raphaelcasimir/kord-stk/README.md

# kord-stk
The KORD-reborn project (of Holy Mother Russia) purpose is to control a rocket's attitude in flight.

1. First phase: the Stick of Truth (STK) 
1. Second phase: the Rocket Control System (RCS)

https://www.youtube.com/watch?v=VuEvJ63-ckM

Please keep in mind that  explosions, holes in things and casualties should be minimised.

May Russia be with you.
