raphaelcasimir/kord-stk/Report/chapters/glossary.tex

% Glossaries package
% http://ctan.cs.uu.nl/macros/latex/contrib/glossaries/glossariesbegin.pdf
%
% % % % % % % %
%	Example of glossary entry:
% \newglossaryentry{cabbage}{name={cabbage},description={vegetable with thick green or purple leaves}}
%
%	Example of acronym entry:
% \newacronym{spi}{SPI}{Serial Peripheral Interface}
%

\newacronym{e}{E}{example}
