raphaelcasimir/kord-stk/Report/chapters/Preanalysis&Requirement/RocketStability.tex

\subsection{Controlling a Rocket's Stability}
The design method for placing the CP and GP does not always provide a perfectly stable attitude control. Indeed to have such precision an active control system is necessary. Full scale rockets use the thrusting force to achieve alike control. In order to do so most of them operate with the gimbaled thrust method. It consists of steering the engine's nozzle to get the thrusting force in right incidence. An example is seen cf. figure \autoref{fig:RocketGimbal}. 
\begin{figure} [htbp]
	\centering
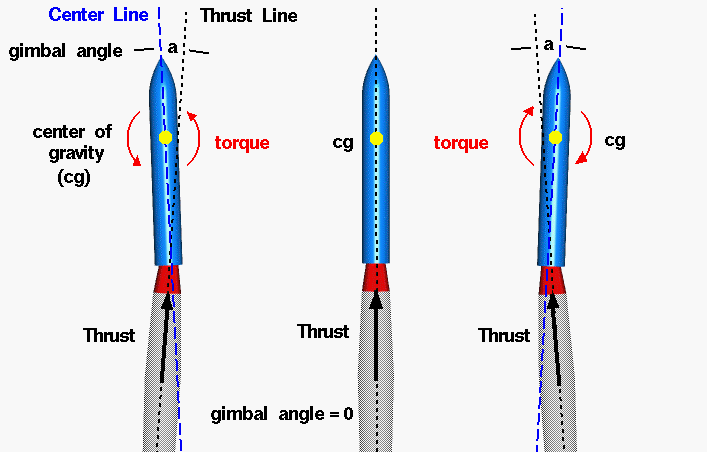
[picture p5: Report/figures/Preanalysis&Requirement/RocketStability/RocketGimbal.png]
	
	\caption{Example of gimballing a rocket nozzle \cite{web:rocketnasa}.}
	\label{fig:RocketGimbal}
\end{figure}
\newpage

Where a torque is applied to create a rotation around the rocket's center of gravity. The thrust direction is relative to the position of the center of gravity.  This should compensate for direction deviations from the rocket's center line or trajectory, and keep the rocket stable. The described gimbal method will be the control method focused on in this project. The rocket will be designed with a control system depending on vectoring the thruster in relation to the attitude position of the rocket.
