raphaelcasimir/kord-stk/Report/chapters/Implementation/implementation.tex

\chapter{Inverted Pendulum Implementation}\label{sec:InvPendImp}
This section describes the hardware and software implementation of the controllers designed \autoref{sec:IPController}. The goal is to determine if the designed controllers will balance the stick in the real world application. The section is separated into three different parts about sensors, hardware controller and software controller. The first part is to implement the feedback for the controllers which in the case is sensors. 

\section{Implementing Sensors}
The following section describes the implementation of the sensors with an Arduino Uno and the inverted pendulum setup.   

\subsection*{Potentiometer}\label{section:PotmeterImplementation}
The system consist of multiple sensors, as decribed in \autoref{sec:IPDesc}, where two of these are potentiometers. The potentiometers is tested in Appendix \ref{appendix:PotMeterTest}. The appendix concluded with a first order approximation of both potentiometers. During the implementation it is realized that slight calibrations were needed because the potentiometer had moved in the setup. The approximation for Pot$_{arm}$ is:
\begin{equation}
\theta_a\ =\ 63,11 \cdot V_{{Pot}_{arm}} - 117,0
\end{equation}
\startexplain
	\explain{$\text{V}_{{Pot}_{arm}}$ is the output voltage of the arms potentiometer}{V}
	\explain{$\theta_a$ is the angle of the arm}{$^\circ$}
\stopexplain

The approximation for Pot$_{stick}$ is:
\begin{equation}
\theta_s\ =\ 66,66 \cdot \text{VPot}_{stick} - 163,9
\end{equation}
\startexplain
	\explain{$\text{V}_{{Pot}_{stick}}$ is the output voltage of the stick potentiometer.}{V}
	\explain{$\theta_s$ is the angle of the stick, but where zero degrees is when the stick has a zero degree deviation from the arm}{$^\circ$}
\stopexplain

An example of implementing this is done through a pseudo-code which converts the analogue value to radians. The linear approximations of the potentiometers are used.
\begin{lstlisting}
void loop() {
  // read the input on A0 and A1:
  int PotArm = analogRead(A0);
  int PotStick = analogRead(A1);

  double VPotarm = PotArm / 204.8; //Analog2Voltage
  double ThetaA = 66.66 * VPotarm - 170.46; // Voltage2Degree
  double ThetaARad = ThetaA * (31.415926 / 1800.0); //Degree2Radians
  double VPotstick = PotStick / 204.8;
  double ThetaS = 63.64 * VPotstick - 117.77;
  double ThetaSRad = ThetaS * (31.415926 / 1800.0);
}
\end{lstlisting}    

The sampling time of the sensors is an important aspect when ensuring stability of the control system. The sensor sampling can not be to slow because then the control loops will be slow and not update fast enough. Considering that the sensor is a potentiometer which does not have any active components, then the only limit is the Arduino. Arduino specifies that calling an analogRead() takes approximately 100 $\upmu$s which corresponds to a sampling frequency of 10 kHz. This is considered fast enough for the system and is therefore not a problem. 

\subsection*{Tachometer}
The tachometer and its precision has been tested in Appendix \ref{appendix:RPMTest}. The test concluded that the internal tachometer's precision is within the limit of what can be implemented. The tachometer outputs a voltage which is close to linear with the number of revolutions per minute.

The test concluded with a transfer function for the tachometer, that gives the relation between the tachometer voltage and motor velocity:
\begin{equation}
\dfrac{\dfrac{1000\ \text{RPM}}{3.130\ \text{V}} \cdot 2 \cdot \pi}{60\ \text{s}}\ \cdot\ T_{Voltage}[\text{V}]\ =\ M_{Velocity}\ \text{[rad/s]}
\end{equation}

The function can not directly be implemented with the Arduino. The tachometer will generate a negative and a positive voltage corresponding to the direction of the motor. Negative voltage can not be directly input to the Arduino without short circuiting it, and the positive voltage would be too high considering that the motor can go up to 8500 RPM. Interfacing is therefore needed between tachometer and Arduino.
This interfacing is done through the ESCON motor controller included in the inverted pendulum setup. The two outputs of the tachometer are put into the motor controller via two analogue inputs. One acts as the positive connection and the other as the negative. How the motor controller is reacting to an input is configured through the ESCON studio included. In this case it is set with the conversion ratio from voltage to RPM on 3.130 V/1000 RPM, which was determined by external calibration from another tachometer and implemented in the software.  The motor controller is set with a output that converts this RPM down between 1 and 4 V to the Arduino. Where 1 V is corresponding to -3000 RPM and 4 V corresponding to +3000 RPM. This gives the possibility to convert these values back to RPM in Arduino. How the motor controller converts the voltages is considered a black box. The wiring for the tachometer can be seen on \autoref{fig:EsconWiring}. 

\begin{figure}[htbp]
\centering

\caption{Circuit diagram of the wiring for the control setup.}
\label{fig:EsconWiring}
\end{figure}
\newpage
\section{Implementing ESCON Motor Controller}
The following sections describes the implementation of the hardware motor controller with the Arduino. The motor controller in the setup is a Maxon Escon 50/5.

The Maxon ESCON 50/5 is a PWM servo controller, that can be used to control DC and EC motors. The application is to amplify signals and control systems through different control operations. It can also be used with a PWM input signal that can be outputted as an amplified and higher frequency PWM signal to a motor. The servo controller can be used in three different modes which can be configured through the included Maxon ESCON studio. It can be configured in two modes for speed control with open and closed loops with feedback from sensors through the board, and one mode for motor current control through inputs from other modules such as an Arduino. In the setup the Escon controller is set to current control.

It is set up through the ESCON studio with current control, and with an external controlled PWM signal. It then gives the possibility to input a PWM signal from the Arduino, which will be amplified so that 90\% duty cycle equals 11 A and 10\% equals -11 A. This means that 50\% will give 0 A.

The Arduino uses a 8-bit timer for PWM as standard. To get a better resolution the TimerOne library is implemented. TimerOne is a 16-bit hardware timer which can be downscaled to give the possibility to have a 10-bit resolution on the PWM signal. A better resolution gives a higher number of duty cycle values which makes the control more precise than with 8-bit. 

The configuration file for the ESCON studio is included in the attachment files under "/Attachment/Implementation/Motor Controller/Motor Controller Configuration File". It can be imported into the ESCON studio and loaded onto any 50/5 controller.

The main specifications of the ESCON is listed in \autoref{MaxonSpecifications}.

\begin{table}[htbp]
	\centering
\caption{Maxon Escon 50/5 specifications\citep{datasheet:maxon}.}
\label{MaxonSpecifications}
	\begin{tabular}{llll}
	\hline
	Parameter & Value & Unit \\ \hline
	Supply voltage V$_{cc}$& 10-50 V & {[}V{]} \\
	Output voltage (max.) & 0,98 $\cdot$ V$_{cc}$& {[}kg{]} \\
	Nominal output current & 5 & {[}A{]} \\
	Maximum output current (<20 s) & 15 & {[}A{]}\\
	Current control PWM frequency & 53,6 & {[}kHz{]}
	\end{tabular}
\end{table}

The wiring for the setup can also be seen on \autoref{fig:EsconWiring}.  

\newpage
The control PWM signal from the Arduino is set with a frequency of 5 kHz because that it is the maximum input frequency the motor controller will accept. It is set to 5 kHz so that the PWM avoids interference with the sampling frequency for the system.
The input PWM signal is then amplified and made faster. The output PWM frequency of the motor controller is 53.6 kHz with a duty cycle from 10 - 90\% which can not be changed in the ESCON studio. The switching frequency of the ESCON is considered close to optimal as the PWM frequencies are within the limit of the datasheet specifications. The main concern of a switching frequency of 53.6 kHz on the motor is heat dissipation. Therefore the minimum PWM frequency for the motor is calculated to see if the motor controllers PWM frequency fits the motor.

\subsection{Calculating Minimum PWM Frequency}
The only PWM frequency considered is the minimum switching frequency for the motor. This is done by considering the motor resistance and inductance versus the maximum amount of current ripple wanted on the motor. The values for the resistance and the inductance of the motor are calculated in Appendix \ref{tab_appendix:KeSetUp}. The formula is seen on \autoref{eq:PWMSwitch}.

\begin{equation}
f_{switch} \geq \frac{-1}{2\cdot \ln(1-\frac{p}{100})}\cdot\frac{R_{m}}{L_{m}}
\label{eq:PWMSwitch}
\end{equation}
\startexplain
	\explain{$p$ is the maximum \% current ripple in the motor.}{1}
	\explain{$\nicefrac{R_{m}}{L_{m}}$ is the inverse electrical time constant of the motor.}{Hz}
\stopexplain

Replacing with the numerical values of the resistance and the inductance and choosing a max ripple percentage of 5\%, the minimum switching frequency determined to be:
\begin{equation}
    f_{switch} \geq \frac{-1}{2 \cdot ln(1-\frac{5}{100})}\cdot\frac{0.82\ \Omega}{156\cdot10^-6 \ \cdot \text{H}} \approx \ 51.2 \text{ kHz}
\end{equation}

The maximum ripple in the motor is determined by making the ripple the unknown factor P$_{ripple}$ and setting the PWM frequency to the implemented 53.6 kHz.  

\begin{equation}
    53.6 \text{kHz} = \frac{-1}{2 \cdot ln(1-\frac{P_{ripple}}{100})}\cdot\frac{0.82\ \Omega}{156\cdot10^-6 \ \cdot \text{H}}\ =\ P_{ripple}\ = 4.785\%  
\end{equation}
This gives that the maximum current ripple is 4.785\% if considering a PWM frequency on 53.6 kHz. A general rule is that the ripple should be less than 10\% of the current, so considering that it is less than 5\% is acceptable.

%https://playground.arduino.cc/Code/Timer1
 
%\section{Implementing Controllers}
%The implementing on the hardware has been described in the chapter, and therefore the implementation can proceed to the implementing the controllers on an Arduino. 

\input{chapters/Implementation/ZTransform.tex}

\subsection{Controller Software}
This sections describes the software implemented on the Arduino.  The software can be found in the attached materials under "Attachment/Implementation/Arduino Software/InvertedPendulumControlSoftware". The structure and processes is represented with a flowchart on \autoref{fig:Flowchart}.   
\begin{figure}[htbp]
\centering

\caption{Flowchart for the implemented software on Arduino.}
\label{fig:Flowchart}
\end{figure}
\newpage

\section{Implementation Evaluation}
This following sections describes the different problems that occurred with the hardware and software through out the implementation. They will be explained to show the progress through out the implementation.

\subsection{Filtering Sensors}
During implementation of the arm loop, it was found that a shaking occurred through the motor, gear and out to the arm. From testing higher gains it was found that the shaking was amplified and became more unstable with the higher gains. Testing of the hardware and software was done to determine the source of the shaking. To start with, the sensors were checked for noise and floating. This was done to remove incorrect readings and unstable sensors. The sensors were read through an oscilloscope and it was found that the ESCON motor controllers PWM frequency was represented in the sensor signal. This can occur from incorrect ground or wires not correctly isolated. This problem was solved by adding a capacitor to the sensors as seen on \autoref{fig:EsconWiring}. The capacitor is connected from signal wires to ground to make a low pass filter. 1 $\upmu$F is chosen, one for each signal wire and considering that it is two 10 k$\Omega$ potentiometers it will give a varying cut of frequency. The cut-off frequency is calculated to be:       
\begin{subequations}
\begin{flalign}
\frac{1}{2\cdot \pi \cdot 10000\ \Omega \cdot 1 \cdot 10^{-6}\  \text{F}}\ =\ 15.92\ \text{Hz} \\
\frac{1}{2\cdot \pi \cdot 2.97\ \Omega \cdot 1 \cdot 10^{-6}\  \text{F}}\ =\ 53.6\ \text{kHz}
\end{flalign}
\end{subequations}

The resistance changes needs to go under $\approx$ 2.97 $\Omega$ before the cut-off frequency exceeds the frequency of the noise, and any resistance change higher will dampen with more than -3 dB. It is noticeable that the resistance values of the potentiometers are in between both limits of resistances and the noise is therefore dampened. The conclusion of adding these filters, is that the high frequency noise that made the arm shake is reduced. There was still a small-amplitude shaking around the setpoint when the arm was at a position and kept there. This could due to non-optimal range and bad optimization of bits in the software. The software is made with scaling from analogue values to radians, which means that reading the arm potentiometer and having an analogue value from 235 to 527 and converting it to -0,785 to 0,785 radians means that that first two bits are not used. This gives that the 10-bit resolution of the PWM is not used optimally when two are static, but it is still better than having 8-bit with two static. 

This can be optimized by changing the range of the potentiometers so the maximum angles the arm reaches correspond to the full 10-bit range. It could also be solved by changing the model and with the conversion throughout the software. The analogue value would thus not be converted which would give a better resolution for the PWM output. They can also be combined for the best resolution. It is chosen to only implement the resolution optimization if and only if the acceptance test show that the system does not fulfil the set requirements.

\subsection{PWM Frequency Problems}
The stick control loop was implemented with an interrupt attached to the TimerOne to get the desired sampling rate. The simulations gave gains and results that could be implemented on the system. When implemented it was found that the arm did not control correctly when the stick moved. Repetitive test gave the conclusions that the speed of the arm was to slow. Higher gains were implemented but did not give the wanted result and the gains were set back to the simulated. An oscilloscope test was made on the Arduino PWM frequency by measuring the input frequency on the motor controller. The test showed that the frequency was 100 Hz and not 5 kHz as expected. 

The software was revised and determined that attaching the interrupt to TimerOne overwrote the PWM switching frequency. The interrupt was removed and changed to a wait so that the sampling time was kept constant. The PWM frequency was then measured to be 5 kHz and the arm then behaved as wanted with the simulated gains. 

\subsection{I2T Limitation}
Another problem observed where a run time limit on the control system. The system would slow down after approximately a minute but it was easily observed through the ESCON studio that an I2T limit was reached on the motor controller. An I2T limit is an algorithm that is described by the nominal current, the motor peak current in RMS, and the motor peak current in seconds. It is used to secure the motor and driver from damage and over heating. The parameters for the algorithm were set through the ESCON studio, with a nominal current on 5 A, a peak current on 11 A, and a thermal time constant on 200 seconds. When the limit is reached, the motor current only goes to 5 A so the motor controller is shut off to cool down before it can then be used again.  

\subsection{Controller tuning}
An initial test showed that the controller designed could balance the stick but it was balanced when the arm was closer to 30$^\circ$ than 0$^\circ$. This is likely caused by a steady state error somewhere in the system. As the motor loop controller had a steady state error the gain was increased to reduce the error. This made the stick balance closer to the upright position. The new motor loop controller becomes \autoref{eq:newDmotor}.
\begin{flalign}
D_{motor}=10\label{eq:newDmotor}
\end{flalign}

\chapter{Rocket Implementation}

\section{Implementing Inertial Measurement Unit}

\input{chapters/"Implementation"/rocket_measurement_unit.tex}
