raphaelcasimir/kord-stk/Report/chapters/appendices/_appendices.tex

\graphicspath{{figures/appendices/}}

%\include{chapters/appendices/PsocMasterCode}

%\include{chapters/appendices/template}
\include{chapters/appendices/DCmotorInductance}
\include{chapters/appendices/LinearStick}
\include{chapters/appendices/RPMTest}
\include{chapters/appendices/PotMeterTest}
\include{chapters/appendices/SRB_test}
\include{chapters/appendices/servomotors}
%\include{chapters/appendices/gyroscope}
%\include{chapters/appendices/ground_attached_first_flight}
