raphaelcasimir/kord-stk/Report/chapters/appendices/DCmotorInductance.tex

\graphicspath{{figures/appendix/"Motor&GearTests"/}}
\chapter{Test Journal: Gear Train System}\label{appendix:DCMotorInductance}
\begin{table}[htbp]
\begin{tabular}{l l}
\textbf{Test participants:} & Maxime \& Geoffroy  \\
\textbf{Date:}  & 28/2/2017
\end{tabular}
\end{table}

\section*{Purpose}
The objective of this test is to determine all the characteristics of the gear train system composed of the DC motor and the gear train.
\section{Electronics characteristics}

\input{chapters/appendices/LmRmTest.tex}

\subsection{The DC Motor velocity constant $K_e$}\label{sec:MeasKe}
\input{chapters/appendices/KeTest.tex}

\subsection{The DC Motor torque constant $K_t$}\label{sec:MeasKt}
\input{chapters/appendices/KtTest.tex}

\newpage
\section{Mechanical Characteristics}

\subsection{Frictions $B_m$}\label{sec:MeasBm}
\input{chapters/appendices/BmTest.tex}

\subsection{Moment of Inertia of the Gears $J_{gear}$}\label{sec:MeasJg}
\input{chapters/appendices/GearFriction.tex}
