raphaelcasimir/kord-stk/Report/chapters/Modeling/MotorGearsTFSimplified.tex

\subsubsection{Determining $\frac{\Theta_a}{U_m}$ }
When controlling the equilibrium of the stick, $\theta_s$ grows up to only a couple degrees, not exceeding 10. Therefore, regarding the torque generated by the stick, $\theta_s$ can be considered as 0. Thus giving a second degree equation for $\tau_s$ and $\tau_l$:
\begin{subequations}
	\begin{flalign}\label{eq:LinTauSSimplified}
		\tau_s&=M_sgl_a\Theta_a\\
		\tau_l&=M_ag\frac{l_a}{2}\Theta_a-J_a\Theta_a s^2+M_sgl_a\Theta_a +(J_{gear}s +B_{gear})\Omega_m(s)
	\end{flalign}
\end{subequations}

Now that $\tau_l$ is found, it is re-injected in \autoref{eq:Iinserted} giving \autoref{eq:begTFOaUm}.
\begin{align}\label{eq:begTFOaUm}
	s J_{m} \Omega_m(s) &=K_{t} \frac{U_m-K_e \Omega_m(s)}{R_m} - \Big(M_ag\frac{l_a}{2}\Theta_a-J_a\Theta_a s^2+M_sgl_a\Theta_a \notag \\ 
	&+ (J_{gear}s +B_{gear})\Omega_m(s)\Big) - B_{m} \Omega_m(s) 
\end{align}

$\Omega_m(s)$ is expressed according to $\Theta_a$ with \autoref{eq:thetaOmega}.
\begin{flalign}\label{eq:begTFOaUm2}
	\frac{J_{m}}{N^3}\Theta_a s^2 &=K_{t} \frac{U_m-K_e \frac{s}{N^3}\Theta_a}{R_m}- \Big(M_ag\frac{l_a}{2}\Theta_a-J_a\Theta_a s^2+M_sgl_a\Theta_a \notag \\ 
	&  + (J_{gear}s +B_{gear})\frac{s}{N^3}\Theta_a\Big) - B_{m} \frac{s}{N^3}\Theta_a 
\end{flalign}

Factorizing \autoref{eq:begTFOaUm2} by $\Theta_a$ and $U_m$, \autoref{eq:midTFOaUm} is obtained.
\begin{flalign}\label{eq:midTFOaUm}
	\frac{K_t}{R_m}U_m	= \Theta_a\Big[ \frac{J_{m}}{N^3}s^2 + \frac{K_e K_t}{R_mN^3}s + M_ag\frac{l_a}{2} - J_a s^2 + M_sgl_a + \frac{J_{gear}}{N^3}s^2+\frac{B_{gear}}{N^3}s + \frac{B_{m}}{N^3}s \Big]
\end{flalign}

\autoref{eq:midTFOaUm} is then organized to find $\nicefrac{\Theta_a}{U_m}$.
\begin{flalign}\label{eq:UmThetaaTFSimplified}
	\frac{\Theta_a}{U_m}&= \frac{\nicefrac{K_t}{R_m}}{\left( \frac{J_{m}}{N^3} + \frac{J_{gear}}{N^3} - J_a \right)s^2 + \left( \nicefrac{1}{N^3}\left( \frac{K_e K_t}{R_m} + B_{gear} + B_{m}\right) \right) s + gl_a(M_s+M_a)}
\end{flalign}
