raphaelcasimir/kord-stk/Report/chapters/Modeling/MotorGearsTFComplete.tex

Now that $\tau_l$ is found, it is re-injected in \autoref{eq:Iinserted} giving \autoref{eq:UmtoThetaa1}. 
\begin{flalign}\label{eq:UmtoThetaa1}
	s\cdot J_m\cdot \Omega_m(s) & =K_t\frac{U_m(s)-K_e\cdot \Omega_m(s)}{R_m+sL_m}-\big(-J_a\Theta_a s^2+M_ag\frac{l_a}{2}\Theta_a \notag \\ 
	& +M_sl_a\Theta_a+s^2\frac{l_s}{2}l_aM_s\Theta_a+s^2\frac{l_s^2}{4}M_s\left(\frac{\frac{-3l_a}{2l_s}s^2}{s^2-\frac{3g}{2l_s}}\right)\Theta_a \notag\\
	& +(J_{gear}s +B_{gear})\Omega_m(s) \big) - B_m \cdot \Omega_m(s)
\end{flalign}

$\Omega_m(s)$ is expressed according to $\Theta_a$ with \autoref{eq:thetaOmega}. 
\begin{flalign}\label{eq:UmtoThetaa2}
	s\cdot J_{m}\cdot \frac{s}{N^3}\Theta_a &=K_{t}\frac{U_m(s)-K_e\cdot \frac{s}{N^3}\Theta_a}{R_m+sL_m}-\Big( -J_a\Theta_a s^2+M_ag\frac{l_a}{2}\Theta_a \notag\\ 
	&+M_sl_a\Theta_a+s^2\frac{l_s}{2}l_aM_s\Theta_a+s^2\frac{l_s^2}{4}M_s\left(\frac{\frac{-3l_a}{2l_s}s^2}{s^2-\frac{3g}{2l_s}}\right)\Theta_a \notag \\
	&+(J_{gear}s+B_{gear}) \frac{s}{N^3}\Theta_a \Big)  - \frac{B_m}{N^3}s\Theta_a
\end{flalign}

\autoref{eq:UmtoThetaa2} is reorganized in order to find the transfer function from $U_m$ to $\Theta_a$. $L_m$ is neglected given the insignificance of it's value compared to $R_m$.
\begin{flalign}\label{eq:UmtoThetaa3}
	\frac{K_t}{R_m} U_m &= -\Theta_a \Big[s\cdot J_{m}\cdot \frac{s}{N^3} + \frac{K_eK_t}{R_m}-J_a s^2+M_ag\frac{l_a}{2} \notag\\ 
	&+M_sl_a+s^2\frac{l_s}{2}l_aM_s+s^2\frac{l_s^2}{4}M_s\left(\frac{\frac{-3l_a}{2l_s}s^2}{s^2-\frac{3g}{2l_s}}\right) \notag \\
	&+(J_{gear}s+B_{gear}) \frac{s}{N^3} +\frac{B_{m}}{N^3}s \Big]
\end{flalign}

\begin{flalign}
	\frac{\Theta_a}{U_m} &= \frac{\nicefrac{K_t}{R_m}(s^2-\frac{3g}{2l_s})}{As^4+Bs^3+Cs2+Ds+E} \label{eq:UmtoThetaaFinal}\\
	A&= \frac{J_m}{N^3} + \frac{J_{gears}}{N^3} - J_a + \frac{1}{8}l_al_sM_s \addunit{\kilo\gram\meter\squared}\\
	B&= \frac{1}{N^3}\left( \frac{K_eK_t}{R_m} + B_m + B_{gears} \right) \addunit{\newton\meter\second}\\
	C&= gl_a\left( M_a + \frac{1}{4}M_s \right) -\frac{3g}{2l_s}\left( \frac{J_m + J_{gears}}{N^3} -J_a\right) \addunit{\newton\meter}  \\
	D&= -\frac{3g}{2l_sN^3} \left( \frac{K_eK_t}{R_m} + B_m + B_{gears} \right) \addunit{\newton\meter\per\second}  \\
	E&= -\frac{3g^2l_a}{4l_s}(M_a+M_s)  \addunit{\newton\meter\per\second\squared}
\end{flalign}
