raphaelcasimir/kord-stk/Report/chapters/appendices/template.tex

\graphicspath{{figures/design/}}
\chapter{Test Journal: Template}
\begin{table}[!h]
\begin{tabular}{l l}
\textbf{Test participants:} & Maxime \& Robin \& Bang  \\
\textbf{Date:}  & 12/10-2016
\end{tabular}
\end{table}

\section*{Purpose}
The purpose of the test is to calculate the internal resistance and inductance for the DC motor.
\section*{Test equipment and components}
\begin{table}[h]
	\centering
	\caption{List of measurement equipment and components}\label{tab_appendix:template}

	\begin{tabularx}{\textwidth}{lXXXX}
		Name 				& Brand	& Model & AAU-number									\\ \toprule \rowcolor{lightGrey}
		Multimeter	& Fluke & 37 & 08181 	\\
		Powersupply	& Hameg triple & HM7042 & 33902\\ \rowcolor{lightGrey}
		DC motor & Maxon & 41.023.038-00.00-052& N/A
	\end{tabularx}
\end{table}
\section*{Setup}
Measurement setup is seen on \autoref{fig:DCSetup} \
\begin{figure} [h]
\centering

\caption{Measurement setup.}
\label{fig:DCSetup}
\end{figure}

Pictures and describing text
\section*{Method}
Step by step of test, maybe in enumerate
\begin{enumerate}
\item one
\item two
\end{enumerate}
\section*{Raw data}
Or maybe a plot if there's many results. (Remember to save the raw data anyway.)
\section*{Data processing}
\section*{Conclusion}
