raphaelcasimir/kord-stk/Report/figures/Design/MotorLoop/MotorRootLocus.pdf

-200 | -150 | -100 | -50
0 | 50

-1

-0.50

0.51

Root Locus of Voltage to Velocity

Real Axis

Imaginary Axis
