raphaelcasimir/kord-stk/Report/chapters/preface.tex

\iflanguage{english}{
\chapter*{Preface\markboth{Preface}{Preface}}\label{ch:preface}%
%\addcontentsline{toc}{chapter}{Preface}%
}{%
\chapter*{Forord\markboth{Forord}{Forord}}\label{ch:forord}%
%\addcontentsline{toc}{chapter}{Forord}%
}

This report is composed by group CE6-633 during the 6th semester of the Bachelor of \projectFaculty{} at \AAU{}, \the\year. The study of rocket stabilization and inverted pendulum balancing described in this report is part of the theme \textit{\projectTheme}. 

For citation the report employs IEEE style referencing. If citations are not present by figures or tables, these have been made by the authors of the report. Units are indicated according to the SI system.

The natural logarithm is denominated by $\ln$ and $\log_{10}$ is the base 10 logarithm.

A period is used as a decimal mark. Half a space is used as a 100 0 separator. 

\vspace{\baselineskip}\hfill \AAU, \today
\vfill\noindent

\begin{center}
\begin{minipage}[b]{0.3\textwidth}
 \centering
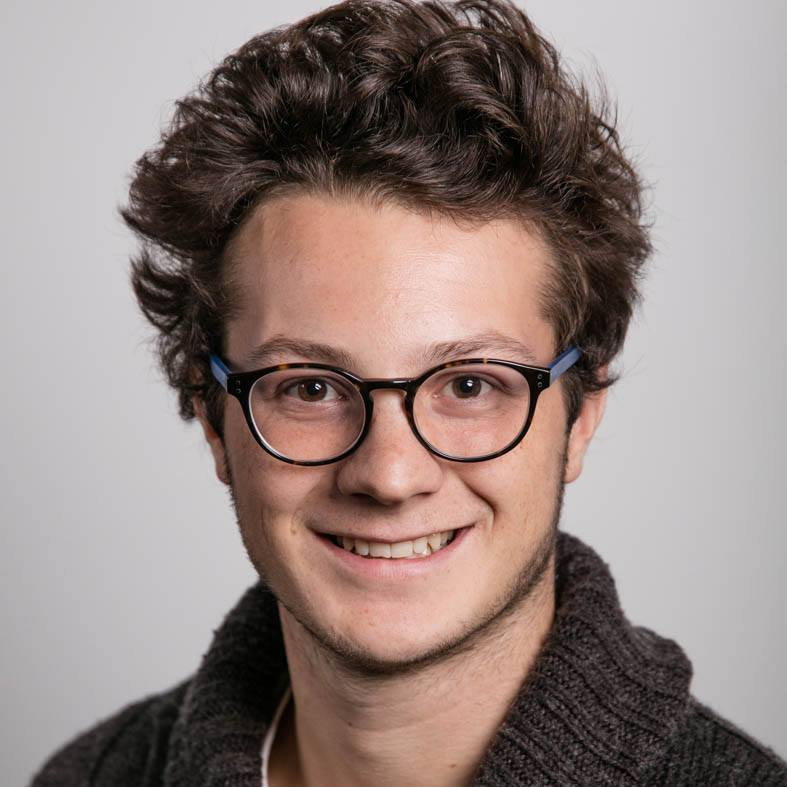
[picture p17: Report/figures/ID_photo/Geoffroy2.jpg]
 	
 \rule{\textwidth}{0.5pt}\\
  Geoffroy Sion\\
 {\footnotesize <gsion16@student.aau.dk>}
\end{minipage}
\begin{minipage}[b]{0.3\textwidth}
 \centering
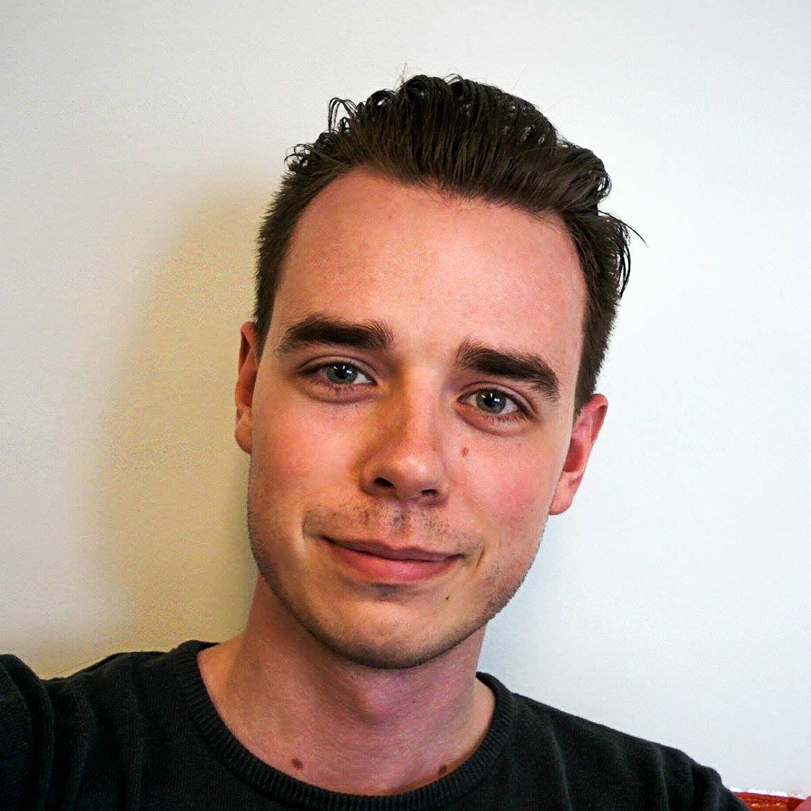
[picture p18: Report/figures/ID_photo/Jacob2.jpg]
 
 \rule{\textwidth}{0.5pt}\\
  Jacob Lassen\\
 {\footnotesize <jlasse14@student.aau.dk>}
\end{minipage}
\begin{minipage}[b]{0.3\textwidth}
	\centering
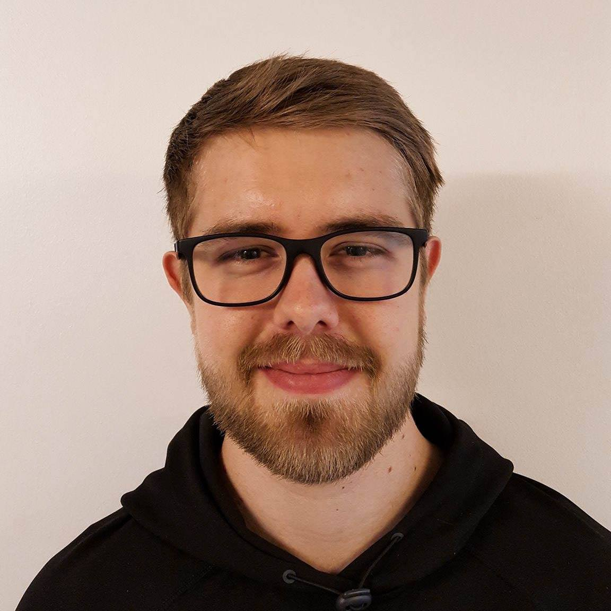
[picture p19: Report/figures/ID_photo/Mathias.jpg]
	
	\rule{\textwidth}{0.5pt}\\
	Mathias Nielsen\\
	{\footnotesize <mathni14@student.aau.dk>}
\end{minipage}

\end{center}
\vspace{3\baselineskip}
\begin{center}

\begin{minipage}[b]{0.3\textwidth}
 \centering
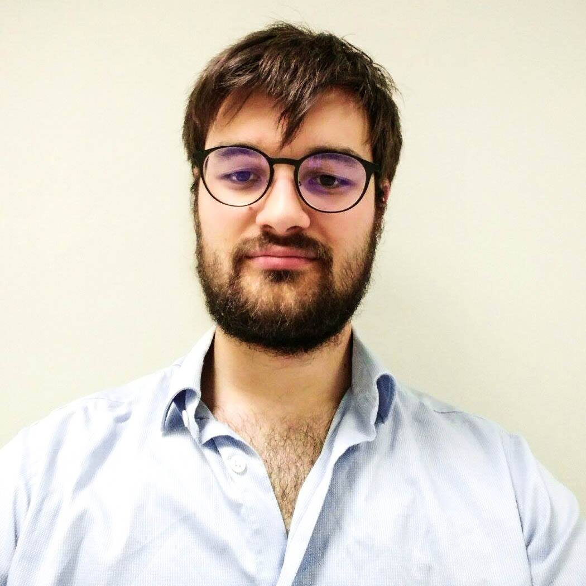
[picture p20: Report/figures/ID_photo/Maxime2.jpg]
 
 \rule{\textwidth}{0.5pt}\\
  Maxime Remy\\
 {\footnotesize <mremy16@student.aau.dk>}
\end{minipage}
\begin{minipage}[b]{0.3\textwidth}
	\centering
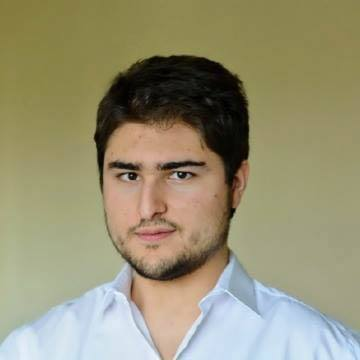
[picture p21: Report/figures/ID_photo/Raphael2.jpg]
	
	\rule{\textwidth}{0.5pt}\\
	Raphaël Casimir\\
	{\footnotesize <rcasim16@student.aau.dk>}
\end{minipage}
\begin{minipage}[b]{0.3\textwidth}
	\centering
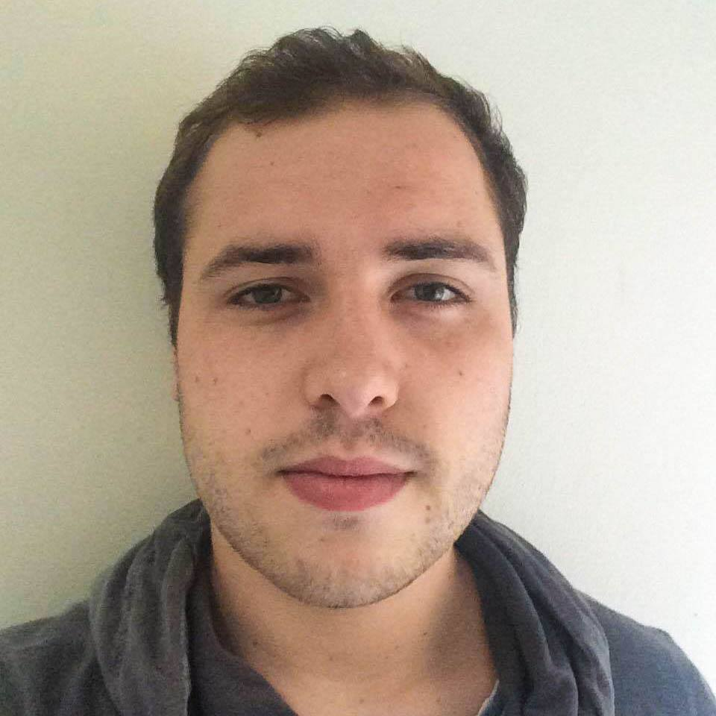
[picture p22: Report/figures/ID_photo/Romain2.jpg]
	
	\rule{\textwidth}{0.5pt}\\
	Romain Dieleman\\
	{\footnotesize <rdiele16@student.aau.dk>}
\end{minipage}

% For one person 
%\begin{minipage}[b]{0.45\textwidth}
% \centering
% \rule{\textwidth}{0.5pt}\\
%  xx\\
% {\footnotesize <xx>}
%\end{minipage}

% For 2 persons 
%\begin{minipage}[b]{0.45\textwidth}
% \centering
% \rule{\textwidth}{0.5pt}\\
%  xx\\
% {\footnotesize <xx>}
%\end{minipage}
%\hspace{0.3cm}
%\begin{minipage}[b]{0.45\textwidth}
% \centering
% \rule{\textwidth}{0.5pt}\\
%  xx\\
% {\footnotesize <xx>}
%\end{minipage}

\end{center}
