raphaelcasimir/kord-stk/Report/chapters/projectinfo.tex

\newcommand{\projectFaculty}{%
\iflanguage{english}{%
Electronics and IT%
}{%
Elektronik og IT%
}}

\newcommand{\projectGroup}{%
Group CE6-633%
}

\newcommand{\projectSemester}{%
P6%
}

\newcommand{\projectType}{%
\iflanguage{english}{%
Project Report%
}{%
Projektrapport%
}}

\newcommand{\projectTitle}{%
%
Inverted Pendulum Balance \\ and \\  Rocket Trajectory Stability
%
}

\newcommand{\projectSubtitle}{%
\iflanguage{english}{%
- Compare and Control -%
}{%
- Undertitel -%
}}

\newcommand{\projectTheme}{%
Control Engineering%
}

\newcommand{\projectPeriod}{%
\iflanguage{english}{%
Spring Semester 2017%
}{%
Efterårssemester 2016%
}}

\newcommand{\projectParticipants}{%
Geoffroy Sion\\
Jacob Lassen\\
Mathias Nielsen\\
Maxime Remy\\
Raphaël Casimir\\
Romain Dieleman
}

\newcommand{\projectSupervisors}{%
Kirsten Nielsen \\ Tom Pedersen
}

\newcommand{\projectCopies}{??}

\newcommand{\projectCompletion}{
30 May 2017%
}
