raphaelcasimir/kord-stk/Report/figures/modeling/gearTrain/LabelledWheels.pdf

m

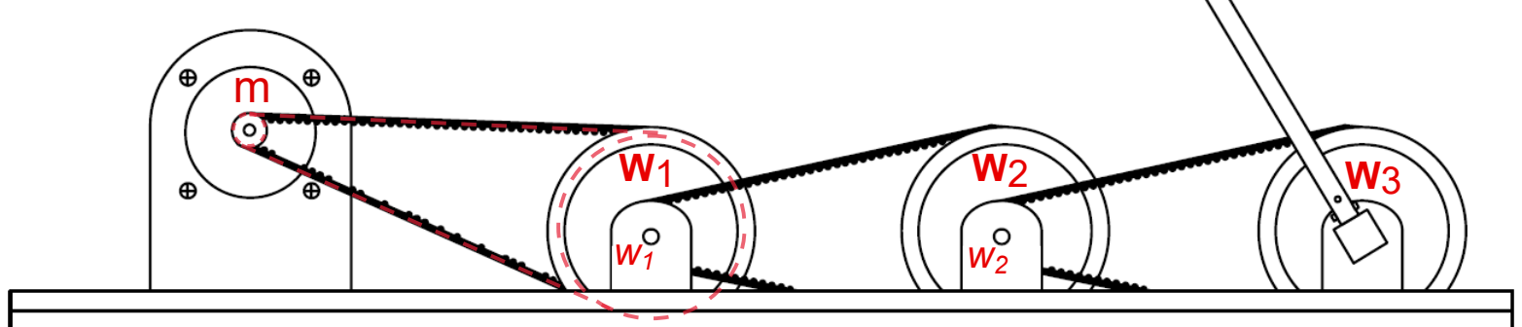
[picture p26: page 1]

•• | • •

W1
w1

W2

w2

W3
