raphaelcasimir/kord-stk/Report/figures/Design/IPController/rlocusArmStick-eps-converted-to.pdf

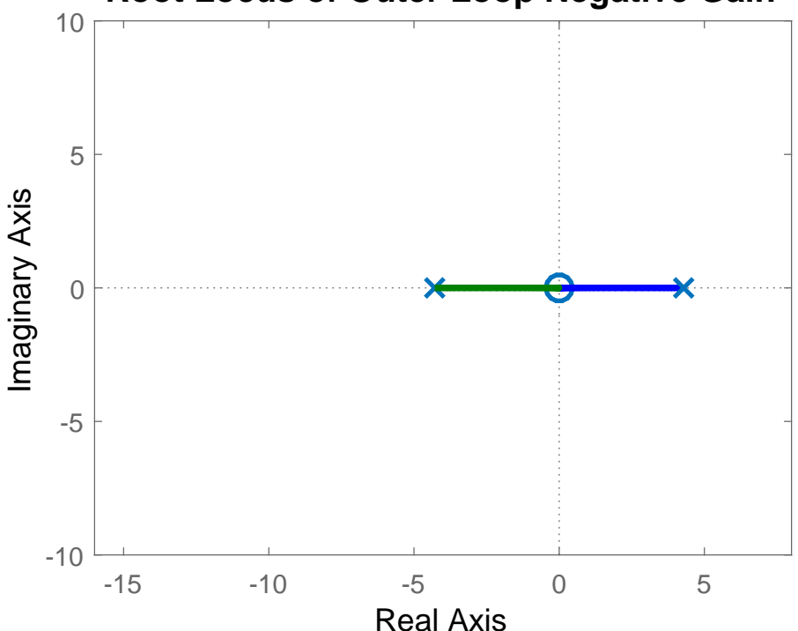
[picture p27: figure]
Real Axis; Imaginary Axis

Root Locus of Outer Loop Negative Gain
