raphaelcasimir/kord-stk/Report/figures/Design/IPController/rlocusZeroAdded-eps-converted-to.pdf

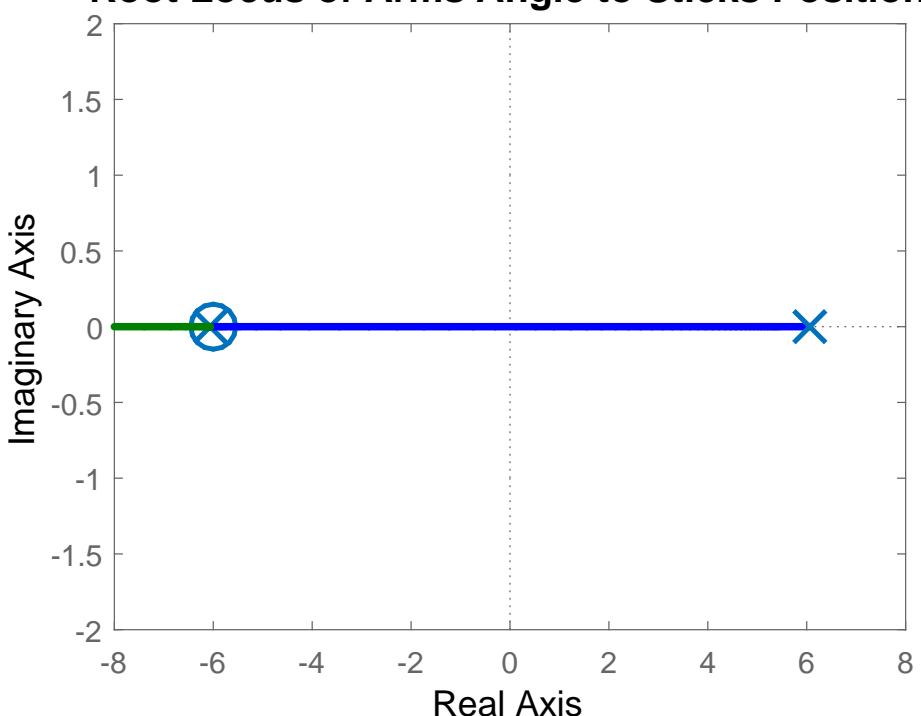
[picture p28: figure]
Real Axis; Imaginary Axis

Root Locus of Arms Angle to Sticks Position
