raphaelcasimir/kord-stk/Report/figures/Design/IPController/IPCascade.pdf

Ds | Da | Ga | Gs
Ref | Θs(s) | Θa(s) | U(s) | Θa(s) | Θs(s) | Out
