raphaelcasimir/kord-stk/Report/figures/modeling/Motor/DCMotorMechanic.pdf

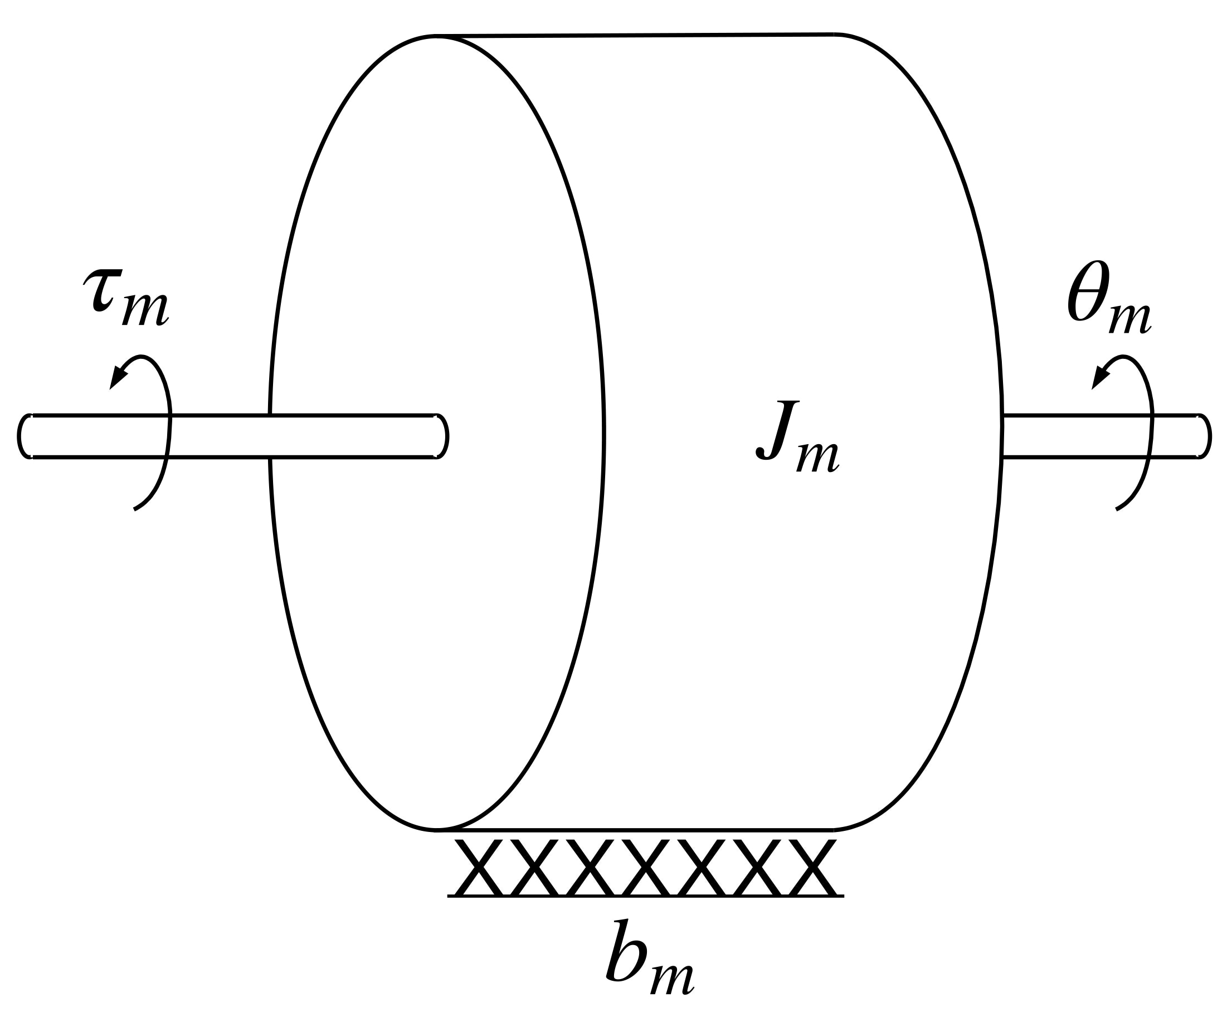
[picture p29: page 1]
