raphaelcasimir/kord-stk/Old Report CDs/2010/Materiale/statefeedback1.pdf

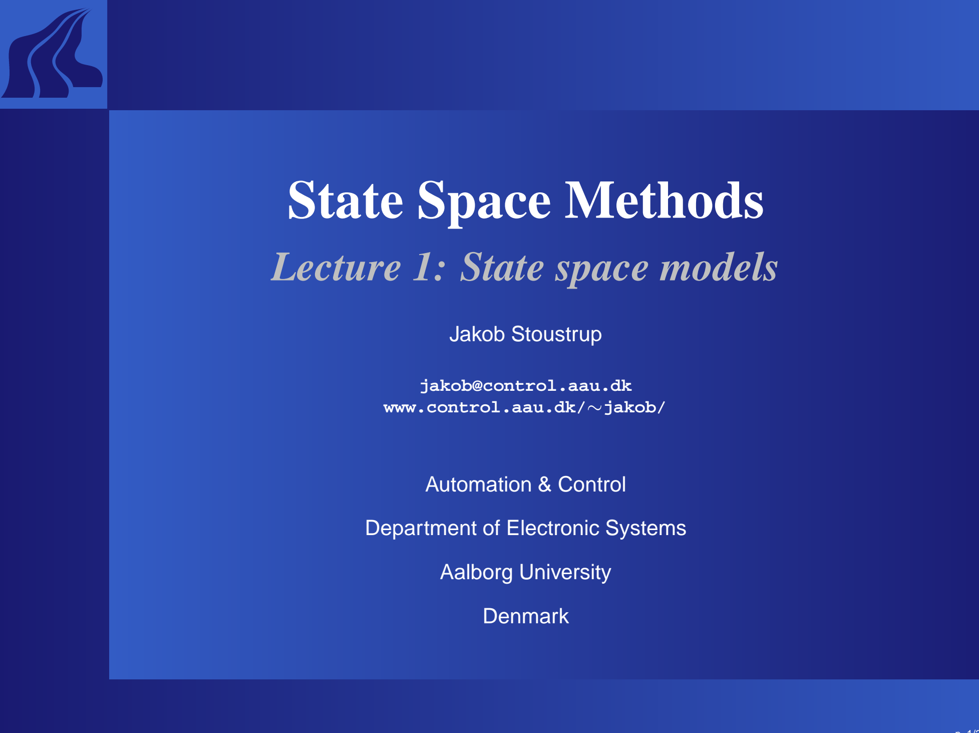
[picture p30: figure]
State Space Methods; Lecture 1: State space models; Jakob Stoustrup; jakob@control.aau.dk www.control.aau.dk/∼jakob/; Automation & Control; Department of Electronic Systems; Aalborg University; Denmark

– p. 1/25

## CContents (http://www.aau.dk/english/index.htm)

One slide course summary

State space models
Example: mass-spring-damper

State space models and transfer functions

Poles and zeros of state space models

State space transformations

## COne (http://www.aau.dk/english/index.htm) slide course summary

State space models

## COne (http://www.aau.dk/english/index.htm) slide course summary

State space models
Controllability

## COne (http://www.aau.dk/english/index.htm) slide course summary

State space models
Controllability
State feedback design (pole assignment)

## COne (http://www.aau.dk/english/index.htm) slide course summary

State space models
Controllability
State feedback design (pole assignment) Observability

## COne (http://www.aau.dk/english/index.htm) slide course summary

State space models
Controllability
State feedback design (pole assignment) Observability
Observer gain design (pole assignment)

## COne (http://www.aau.dk/english/index.htm) slide course summary

State space models
Controllability
State feedback design (pole assignment) Observability
Observer gain design (pole assignment) Observer based control (separation theorem)

## COne (http://www.aau.dk/english/index.htm) slide course summary

State space models
Controllability
State feedback design (pole assignment) Observability
Observer gain design (pole assignment) Observer based control (separation theorem) Reduced order observers

## COne (http://www.aau.dk/english/index.htm) slide course summary

State space models
Controllability
State feedback design (pole assignment) Observability
Observer gain design (pole assignment) Observer based control (separation theorem) Reduced order observers
Integral state space control

## COne (http://www.aau.dk/english/index.htm) slide course summary

State space models
Controllability
State feedback design (pole assignment) Observability
Observer gain design (pole assignment) Observer based control (separation theorem) Reduced order observers
Integral state space control
Zero assignment

## COne (http://www.aau.dk/english/index.htm) slide course summary

State space models
Controllability
State feedback design (pole assignment) Observability
Observer gain design (pole assignment) Observer based control (separation theorem) Reduced order observers
Integral state space control
Zero assignment
Anti-windup

## COne (http://www.aau.dk/english/index.htm) slide course summary

State space models
Controllability
State feedback design (pole assignment) Observability
Observer gain design (pole assignment) Observer based control (separation theorem) Reduced order observers
Integral state space control
Zero assignment
Anti-windup
Optimal control

## CContents (http://www.aau.dk/english/index.htm)

One slide course summary

State space models
Example: mass-spring-damper

State space models and transfer functions

Poles and zeros of state space models

State space transformations

## CState (http://www.aau.dk/english/index.htm) space models

A linear third order system in continuous time with two inputs and two outputs has a state space model of the following form:

x˙ 1= a11x1 | + a12x2 | + a13x3 | + b11u1 | + b12u2
x˙ 2= a21x1 | + a22x2 | + a23x3 | + b21u1 | + b22u2
x˙ 3= a31x1 | + a32x2 | + a33x3 | + b31u1 | + b32u2
where x1, x2, x3 | are called the states, u1, u2 | are
called the inputs, and y1, y2 | are called the
outputs.

## CState (http://www.aau.dk/english/index.htm) space models

A linear third order system in continuous time with two inputs and two outputs has a state space model of the following form:

x˙ 1= a11x1 | + a12x2 | + a13x3 | + b11u1 | + b12u2
x˙ 2= a21x1 | + a22x2 | + a23x3 | + b21u1 | + b22u2
x˙ 3= a31x1 | + a32x2 | + a33x3 | + b31u1 | + b32u2
| | | {z | | }
System equations

## CState (http://www.aau.dk/english/index.htm) space models

A linear third order system in continuous time with two inputs and two outputs has a state space model of the following form:

x˙ 1= a11x1 | + a12x2 | + a13x3 | + b11u1 | + b12u2
x˙ 2= a21x1 | + a22x2 | + a23x3 | + b21u1 | + b22u2
x˙ 3= a31x1 | + a32x2 | + a33x3 | + b31u1 | + b32u2
y1= c11x1 | + c12x2 | + c13x3 | + d11u1 | + d12u2
y2= c21x1 | + c22x2 | + c23x3 | + d21u1 | + d22u2

## CState (http://www.aau.dk/english/index.htm) space models

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

x˙ 1= a11x1 | + a12x2 | + a13x3 | + b11u1 | + b12u2
x˙ 2= a21x1 | + a22x2 | + a23x3 | + b21u1 | + b22u2
x˙ 3= a31x1 | + a32x2 | + a33x3 | + b31u1 | + b32u2
y1= c11x1 | + c12x2 | + c13x3 | + d11u1 | + d12u2
y2= c21x1 | + c22x2 | + c23x3 | + d21u1 | + d22u2
| | | {z | | }
Output equations

## CState (http://www.aau.dk/english/index.htm) space models

In matrix form, a continuous time state space model can be written as:

x˙(t) | = | Ax(t) | + | Bu(t)
y(t) | = | Cx(t) | + | Du(t)
where:
x | =
x1 x2 x3 | , | u | = | u1 u2! | , | y | = | y1 y2!

## CState (http://www.aau.dk/english/index.htm) space models

In matrix form, a continuous time state space model can be written as:

x˙(t) | = | Ax(t) | + | Bu(t)
y(t) | = | Cx(t) | + | Du(t)
where:
A | = a11 | a12 | a13 a21 | a22 | a23 a31 | a32 | a33 | , | B | = b11 | b12 b21 | b22 b31 | b32

## CState (http://www.aau.dk/english/index.htm) space models

In matrix form, a continuous time state space model can be written as:

x˙(t) | = | Ax(t) | + | Bu(t)
y(t) | = | Cx(t) | + | Du(t)
where:
C | = | c11 | c12 | c13 c21 | c22 | c23! | , | D | = | d11 | d12 d21 | d22!

## CState (http://www.aau.dk/english/index.htm) space models

In matrix form, a continuous time state space model can be written as:

x˙(t) | = | Ax(t) | + | Bu(t)
y(t) | = | Cx(t) | + | Du(t)

Similarly, a discrete time state space model can be written as:

x(k + 1) | = | Ax(k) | + | Bu(k)
y(k) | = | Cx(k) | + | Du(k)

## CChoosing (http://www.aau.dk/english/index.htm) state variables

For a physical system, the number of states required is typically equal to the number of ’energy storages’, and a possible choice of state variables is often those variables, that ’represent’ energy storage.

## CChoosing (http://www.aau.dk/english/index.htm) state variables

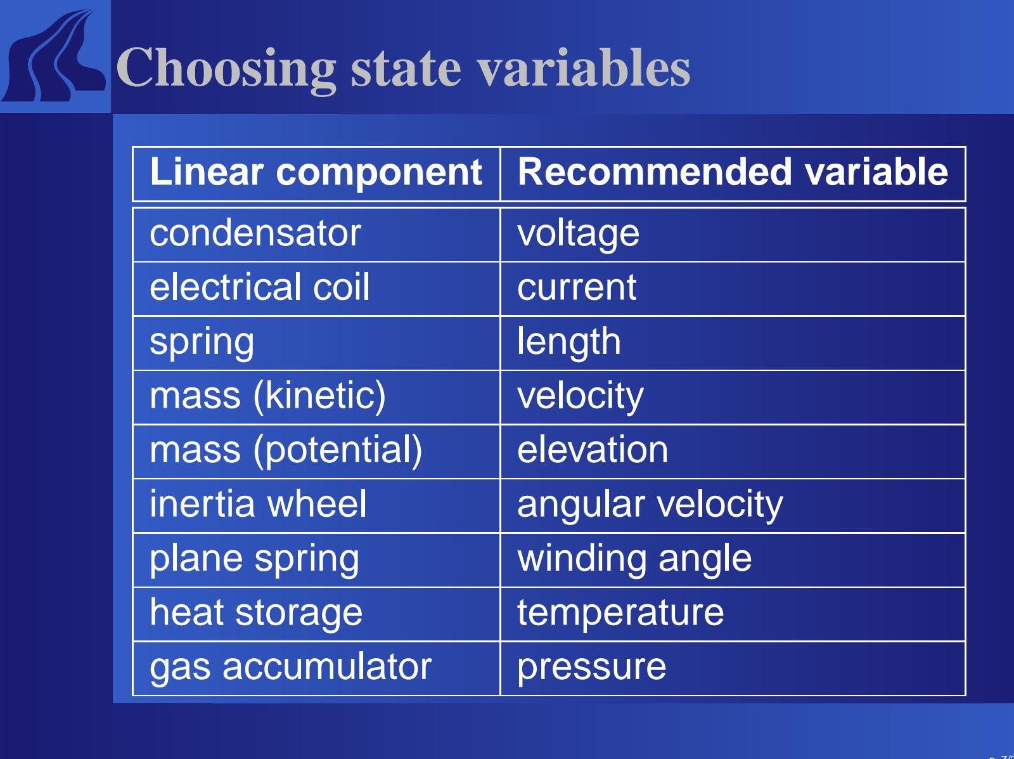
[picture p31: page 24]

Linear component | Recommended variable
condensator | voltage
electrical coil | current
spring | length
mass (kinetic) | velocity
mass (potential) | elevation
inertia wheel | angular velocity
plane spring | winding angle
heat storage | temperature
gas accumulator | pressure

## CContents (http://www.aau.dk/english/index.htm)

One slide course summary

State space models
Example: mass-spring-damper

State space models and transfer functions

Poles and zeros of state space models

State space transformations

## CExample: (http://www.aau.dk/english/index.htm) mass-spring-damper

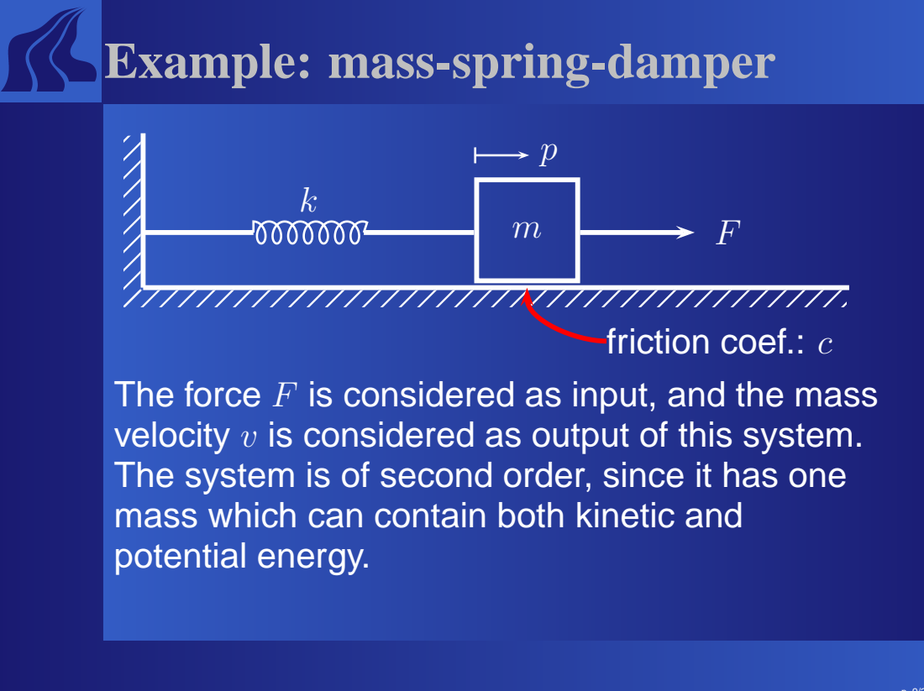
[picture p32: page 26]
friction coef.: c; The force F; is considered as input, and the mass; velocity v; is considered as output of this system.

The system is of second order, since it has one
mass which can contain both kinetic and
potential energy.

## CExample: (http://www.aau.dk/english/index.htm) mass-spring-damper

A possible selection of states are the position p and the velocity v.

## CExample: (http://www.aau.dk/english/index.htm) mass-spring-damper

A possible selection of states are the position p and the velocity v. The derivative of v is given by Newton’s second law:

mv˙ | = −k · p − c · v + F | =⇒
v˙ | = − k m
- p − | c
| m · v +

1
m
| | · F

## CExample: (http://www.aau.dk/english/index.htm) mass-spring-damper

A possible selection of states are the position p and the velocity v. The derivative of v is given by Newton’s second law:

mv˙ | = −k · p − c · v + F | =⇒
v˙ | = − k m
- p − | c
| m · v +

1
m
| | · F
The derivative of p | is simply given by:
p˙ | = v

## CExample: (http://www.aau.dk/english/index.htm) mass-spring-damper

Thus, we have the following state space model:

˙pv! = | 0 | 1 − km | − cm | ! pv! + | 01m | ! F
v | = | 0 | 1 | pv! + | 0 | F

which is indeed of the form:

x˙(t) | = | Ax(t) | + | Bu(t)
y(t) | = | Cx(t) | + | Du(t)

## CContents (http://www.aau.dk/english/index.htm)

One slide course summary

State space models
Example: mass-spring-damper

State space models and transfer functions

Poles and zeros of state space models

State space transformations

CState (http://www.aau.dk/english/index.htm) space model → transfer fct.

Taking Laplace transforms of the system

x˙(t) | = | Ax(t) | + | Bu(t)
y(t) | = | Cx(t) | + | Du(t)
yields

CState (http://www.aau.dk/english/index.htm) space model → transfer fct.

Taking Laplace transforms of the system

x˙(t) | = | Ax(t) | + | Bu(t)
y(t) | = | Cx(t) | + | Du(t)
yields
sx(s) | = | Ax(s) | + | Bu(s)
y(s) | = | Cx(s) | + | Du(s)
rearranging, we obtain:

CState (http://www.aau.dk/english/index.htm) space model → transfer fct.

Taking Laplace transforms of the system

x˙(t) | = | Ax(t) | + | Bu(t)
y(t) | = | Cx(t) | + | Du(t)
yields
sx(s) | = | Ax(s) | + | Bu(s)
y(s) | = | Cx(s) | + | Du(s)
rearranging, we obtain:
(sI − A) x(s) | = | Bu(s)
y(s) | = | Cx(s) + Du(s)

CState (http://www.aau.dk/english/index.htm) space model → transfer fct.

sx(s) | = | Ax(s) | + | Bu(s)
y(s) | = | Cx(s) | + | Du(s)
rearranging, we obtain:
(sI − A) x(s) | = | Bu(s)
y(s) | = | Cx(s) + Du(s)
Premultiplying with (sI − A)⁻¹ | on either side of
the system equation, results in
x(s) | = | (sI − A)⁻¹ Bu(s)
y(s) | = | Cx(s) + Du(s)

CState (http://www.aau.dk/english/index.htm) space model → transfer fct.

(sI − A) x(s) | = | Bu(s)
y(s) | = | Cx(s) + Du(s)
Premultiplying with (sI − A)⁻¹ | on either side of
the system equation, results in
x(s) | = | (sI − A)⁻¹ Bu(s)
y(s) | = | Cx(s) + Du(s)
Finally, we obtain:
x(s) | = | (sI − A)⁻¹ Bu(s)
y(s) | = | C (sI − A)⁻¹ Bu(s) + Du(s)

CState (http://www.aau.dk/english/index.htm) space model → transfer fct.

Premultiplying with (sI − A)⁻¹ on either side of the system equation, results in

x(s) | = | (sI − A)⁻¹ Bu(s)
y(s) | = | Cx(s) + Du(s)
Finally, we obtain:
x(s) | = | (sI − A)⁻¹ Bu(s)
y(s) | = | C (sI − A)⁻¹ Bu(s) + Du(s)
Consequently,
y(s) = G(s)u(s), where:
G(s) = C (sI − A)⁻¹ B + D

## CExample: (http://www.aau.dk/english/index.htm) mass-spring-damper

For the spring-mass-damper system with m | = 1,
c | = 3, k | = 2, the state space representation is:
˙pv! = | 0 | 1 −2 | −3 | ! pv! + | 01 | ! F
v | = | 0 | 1 | pv! + | 0 | F

Thus, the transfer function becomes:
G(s) = C (sI − A)⁻¹ B + D

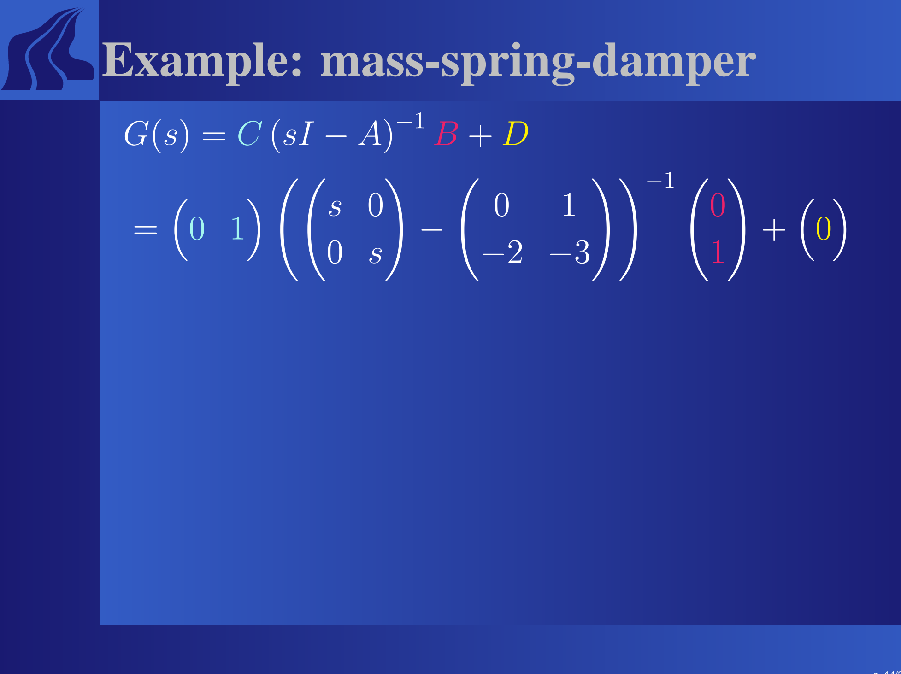
[picture p33: figure]
CExample: mass-spring-damper

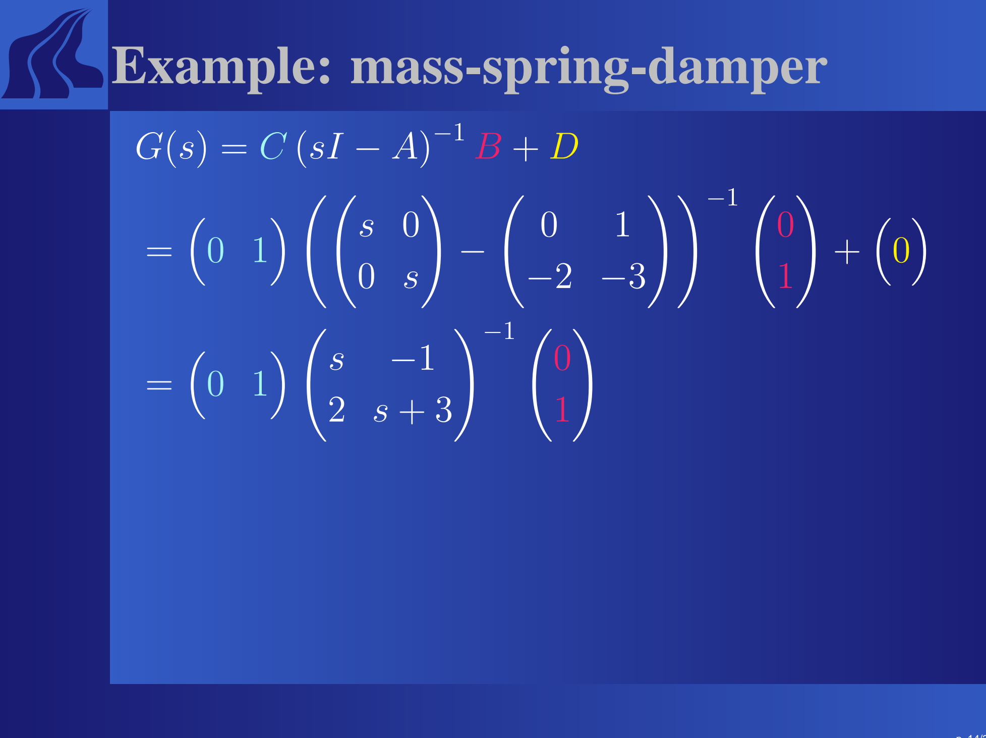
[picture p34: figure]
CExample: mass-spring-damper

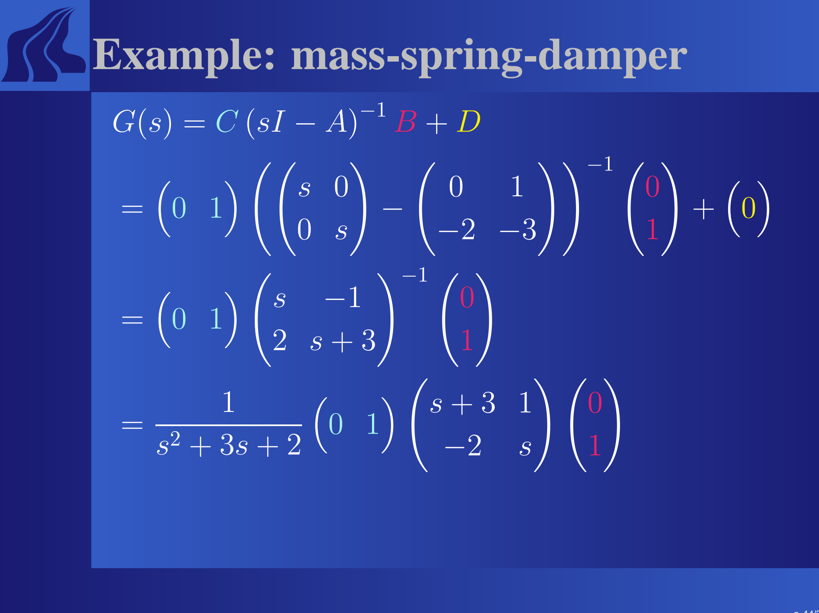
[picture p35: figure]
CExample: mass-spring-damper

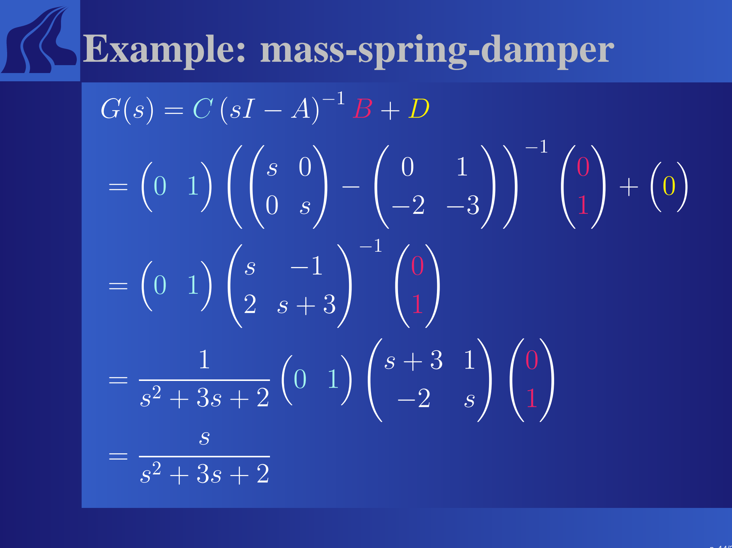
[picture p36: figure]
CExample: mass-spring-damper

## CTransfer (http://www.aau.dk/english/index.htm) fct. → state space model

Consider the transfer function g(s) = | 1 s²+a1s+a2 | .
From the relationship
y(s) = | 1 s² + a1s + a2u(s)

we infer

s²y(s) + a1sy(s) + a2y(s) = u(s)
Taking inverse Laplace transform, this becomes:

y¨(t) + a1y˙(t) + a2y(t) = u(t)

## CTransfer (http://www.aau.dk/english/index.htm) fct. → state space model

y¨(t) + a1y˙(t) + a2y(t) = u(t)
A possible choice of states is: x1 | = y, x2 | = | ˙y.
With this choice, the system equations become:
x˙ 1 | = | ˙y | = x2
x˙ 2 | = | ¨y | = −a1y˙ − a2y + u | = −a2x1 | − a1x2 | + u
In matrix form, we obtain:

## CTransfer (http://www.aau.dk/english/index.htm) fct. → state space model

y¨(t) + a1y˙(t) + a2y(t) = u(t)
A possible choice of states is: x1 | = y, x2 | = | ˙y.
With this choice, the system equations become:
x˙ 1 | = | ˙y | = x2
x˙ 2 | = | ¨y | = −a1y˙ − a2y + u | = −a2x1 | − a1x2 | + u
In matrix form, we obtain:
˙x1 x2! = | 0 | 1 −a2 | −a1 | ! x1 x2! + | 01! u
y | = | 1 | 0 | x1 x2! + | 0 u

## CContents (http://www.aau.dk/english/index.htm)

One slide course summary

State space models
Example: mass-spring-damper

State space models and transfer functions

Poles and zeros of state space models

State space transformations

## CPoles (http://www.aau.dk/english/index.htm) of state space models

With
G(s) = C (sI − A)⁻¹ B + D
we have that:
G(s) → ∞ for s | → p | ⇒ | det (pI − A) = 0
Hence,
p | is a pole for G(s) | ⇒

## CPoles (http://www.aau.dk/english/index.htm) of state space models

With
G(s) = C (sI − A)⁻¹ B + D
we have that:
G(s) → ∞ for s | → p | ⇒ | det (pI − A) = 0
Hence,
p | is a pole for G(s) | ⇒ | p | is an eigenvalue for A

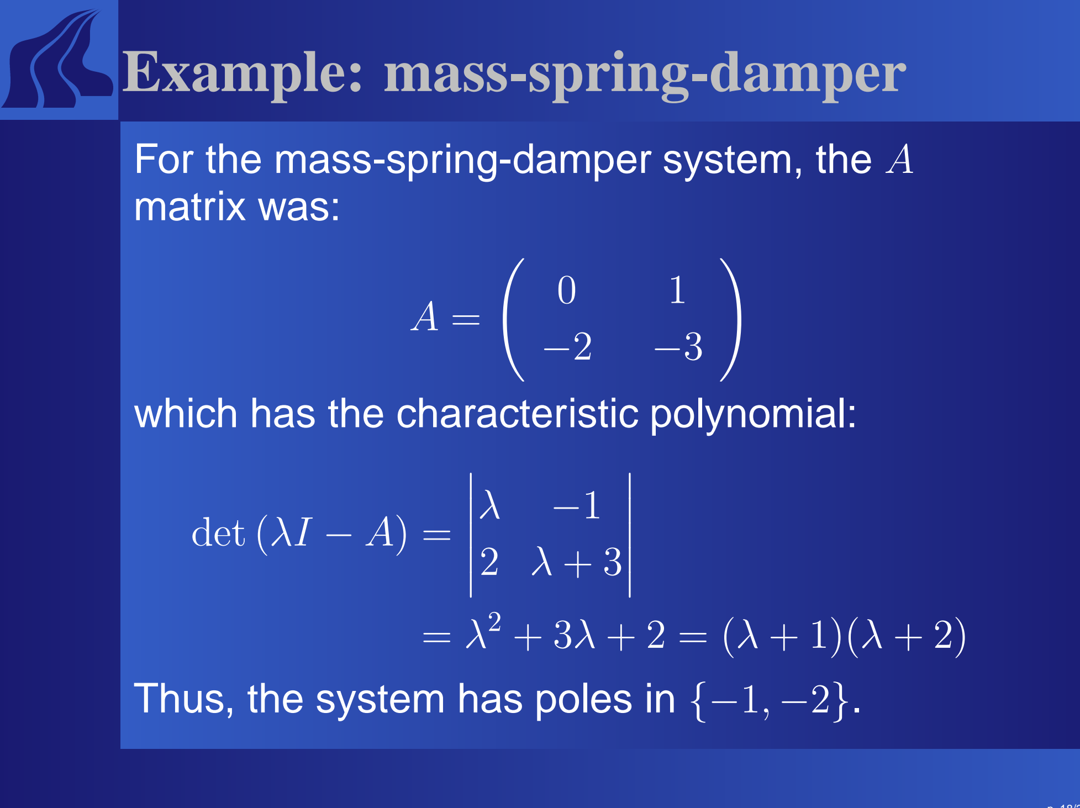
[picture p37: figure]
CExample: mass-spring-damper; matrix was:; det (λI − A) =; = λ² + 3λ + 2 = (λ + 1)(λ + 2) Thus, the system has poles in {−1, −2}.

For the mass-spring-damper system, the A

which has the characteristic polynomial:

## CZeros (http://www.aau.dk/english/index.htm) of state space models

With
G(s) = C (sI − A)⁻¹ B + D
we have that:
G(z)u | = 0 | ⇒ | C (zI − A)⁻¹ Bu + Du | = 0
⇒ | Cξ + Du | = 0 , | ξ | = (zI − A)⁻¹ Bu
⇒ | Cξ + Du | = 0 , | (A − zI) ξ + Bu | = 0
⇒ | A − zI | B C | D! | ξu! = 0

## CZeros (http://www.aau.dk/english/index.htm) of state space models

G(z)u | = 0 | ⇒ | C (zI − A)⁻¹ Bu + Du | = 0
⇒ | Cξ + Du | = 0 , | ξ | = (zI − A)⁻¹ Bu
⇒ | Cξ + Du | = 0 , | (A − zI) ξ + Bu | = 0
⇒ | A − zI | B C | D! | ξu! = 0
Thus, z | is a zero for | G(s) | ⇒
A − zI | B C | D! does not have full column rank

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

## CContents (http://www.aau.dk/english/index.htm)

One slide course summary

State space models
Example: mass-spring-damper

State space models and transfer functions

Poles and zeros of state space models

State space transformations

## CState (http://www.aau.dk/english/index.htm) space transformations

State space representations are not unique! Given one model:

x˙ | = | Ax | + | Bu
y | = | Cx | + | Du
another model can be obtained by a non-singular transformation of the state vector:
x | = Tξ , | ξ | = T ⁻¹x

## CState (http://www.aau.dk/english/index.htm) space transformations

Introducing this in the state space model, we obtain:
T ˙ξ | = | ATξ | + | Bu
y | = | CTξ | + | Du
or, equivalently ˙ξ | = | T ⁻¹ATξ | + | T ⁻¹Bu
y | = | CTξ | + | Du

CState (http://www.aau.dk/english/index.htm) space transformations ˙ξ | = | T ⁻¹ATξ | + | T ⁻¹Bu
y | = | CTξ | + | Du
Thus, a new state space model of the form ˙ξ | = | A˜ξ | + | B˜u
y | = | C˜ξ | + | D˜u

where

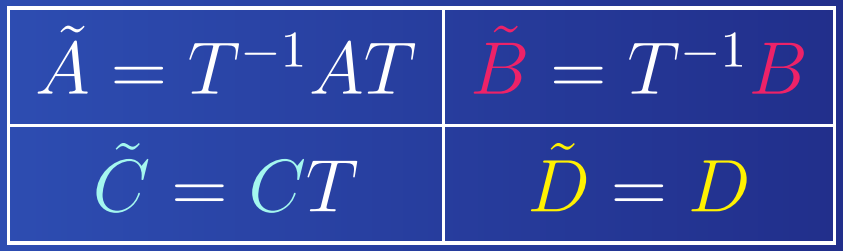
[picture p38: figure]
A˜ = T ⁻¹AT

has been obtained.

## CExample: (http://www.aau.dk/english/index.htm) mass-spring-damper

For the mass-spring-damper system, we change basis using the following transformation matrix:

T | = | 1 | 1 −1 | −2! , | T ⁻¹ | = | 2 | 1 −1 | −1!

This gives the following new state space
representation: | ˙ξ | = | A˜ξ | + | B˜u
y | = | C˜ξ | + | D˜u

with

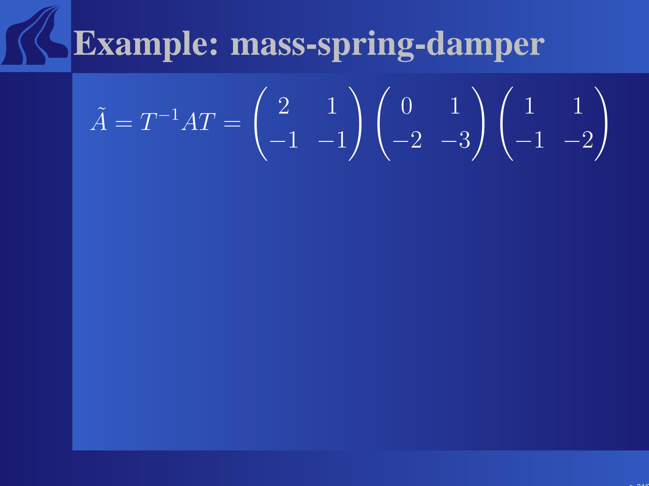
[picture p39: figure]
CExample: mass-spring-damper

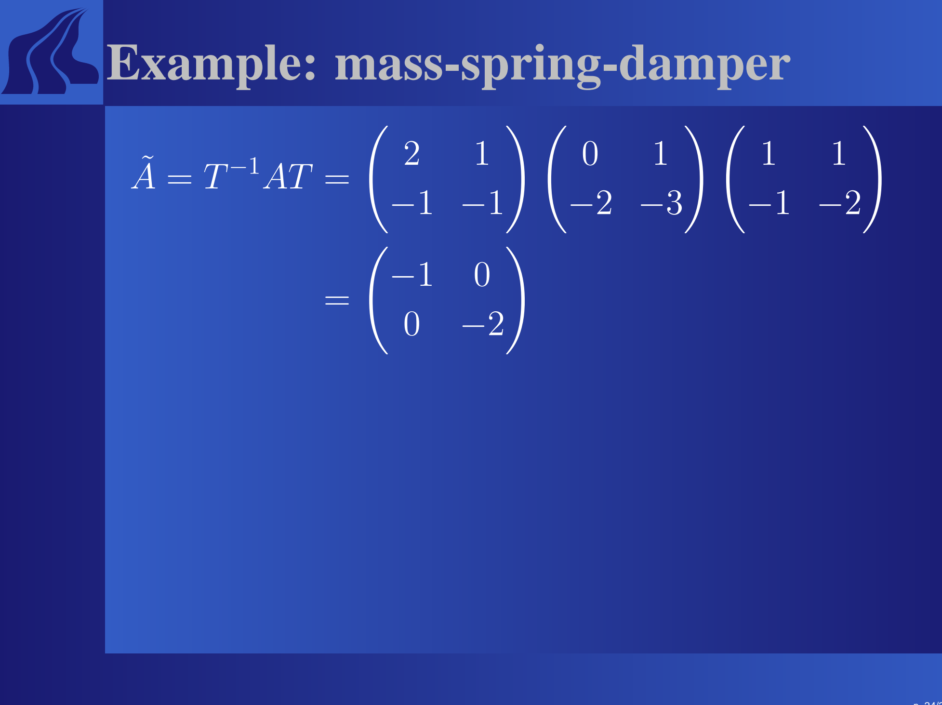
[picture p40: figure]
CExample: mass-spring-damper

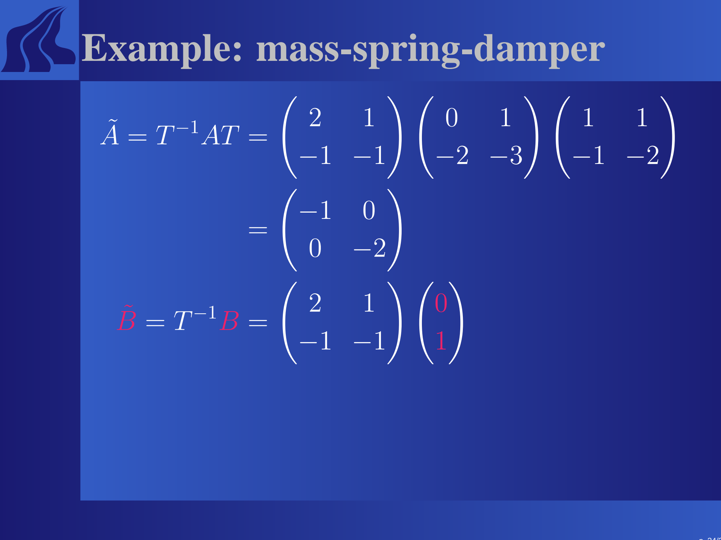
[picture p41: figure]
CExample: mass-spring-damper

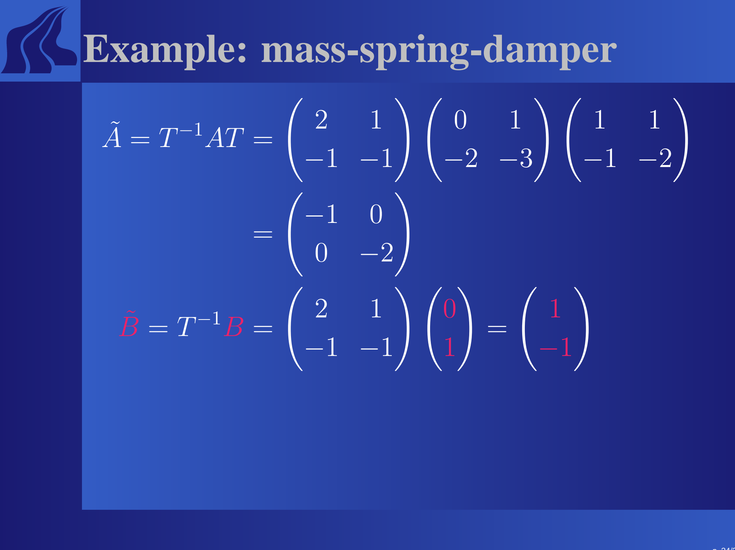
[picture p42: figure]
CExample: mass-spring-damper

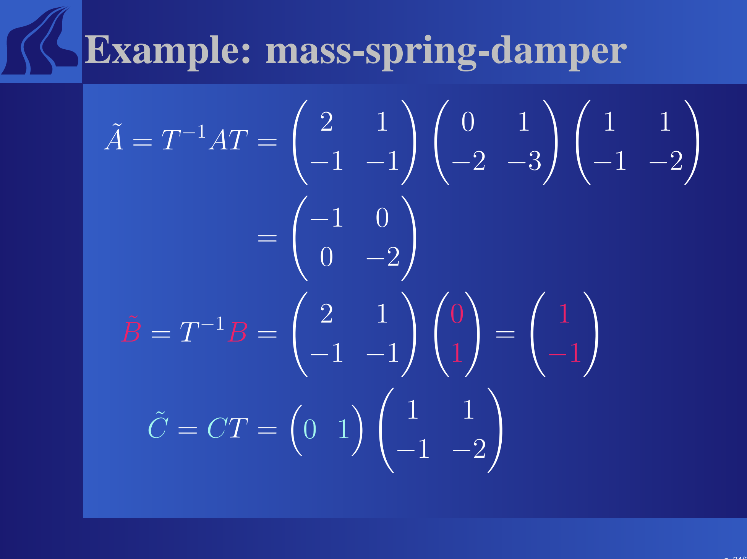
[picture p43: figure]
CExample: mass-spring-damper

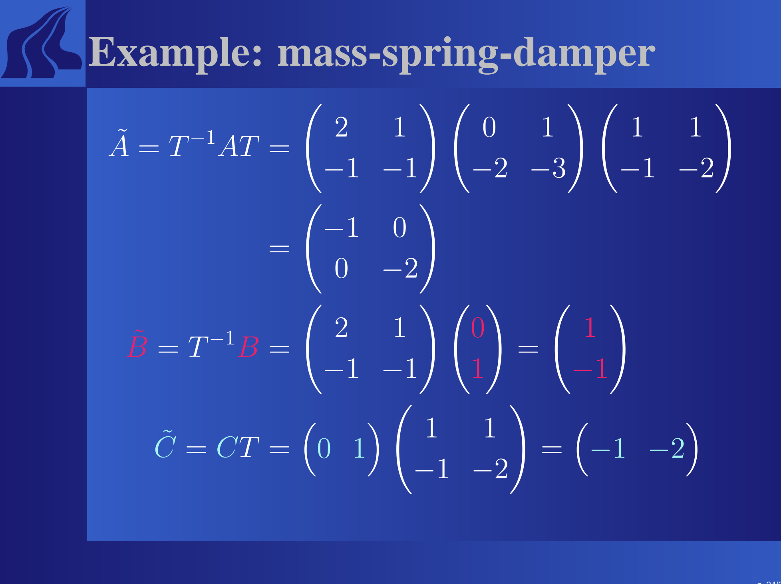
[picture p44: figure]
CExample: mass-spring-damper

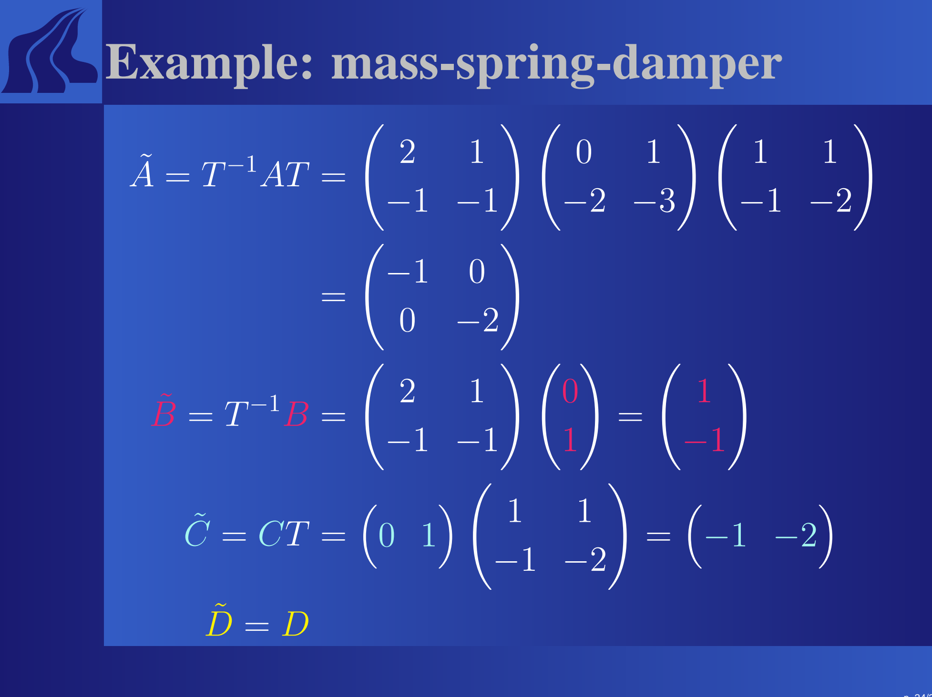
[picture p45: figure]
CExample: mass-spring-damper

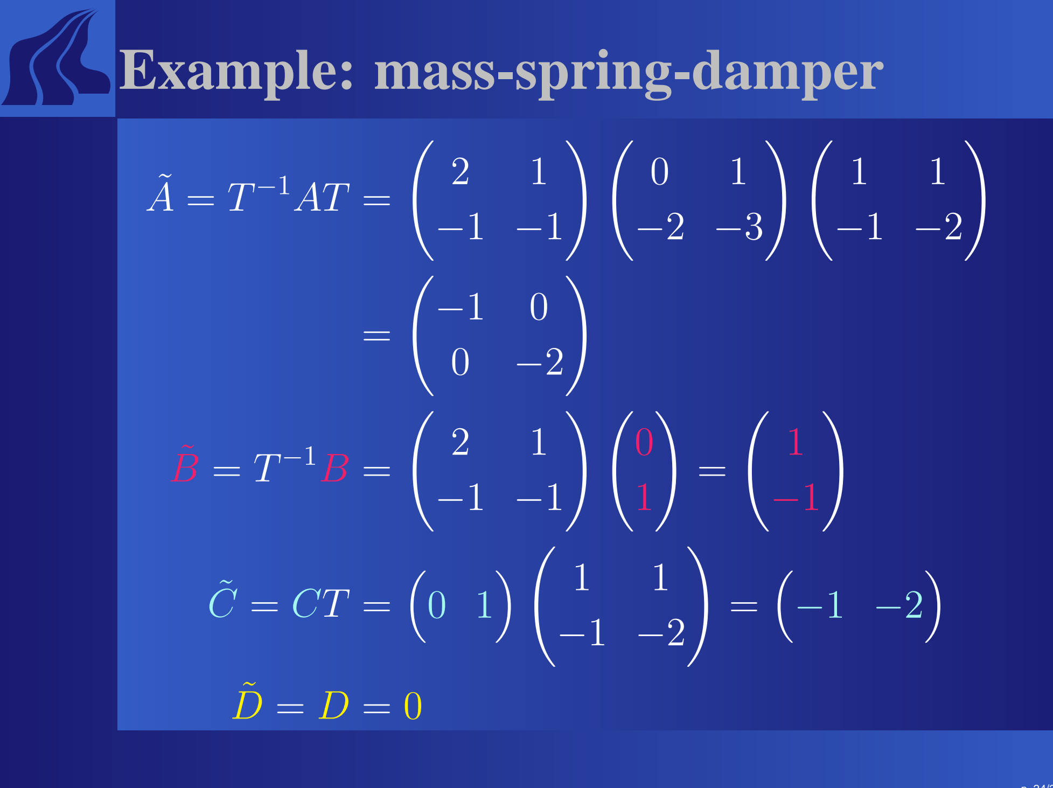
[picture p46: figure]
CExample: mass-spring-damper

## CExample: (http://www.aau.dk/english/index.htm) mass-spring-damper

Transfer matrix:
G˜(s) = C˜ sI − A˜−1 | B˜ + D˜ | – p. 25/25

## CExample: (http://www.aau.dk/english/index.htm) mass-spring-damper

Transfer matrix:
G˜(s) = C˜ sI − A˜−1 | B˜ + D˜ = −1 | −2 s + 1 | 0 0 | s + 2!−1 | 1−1! + 0

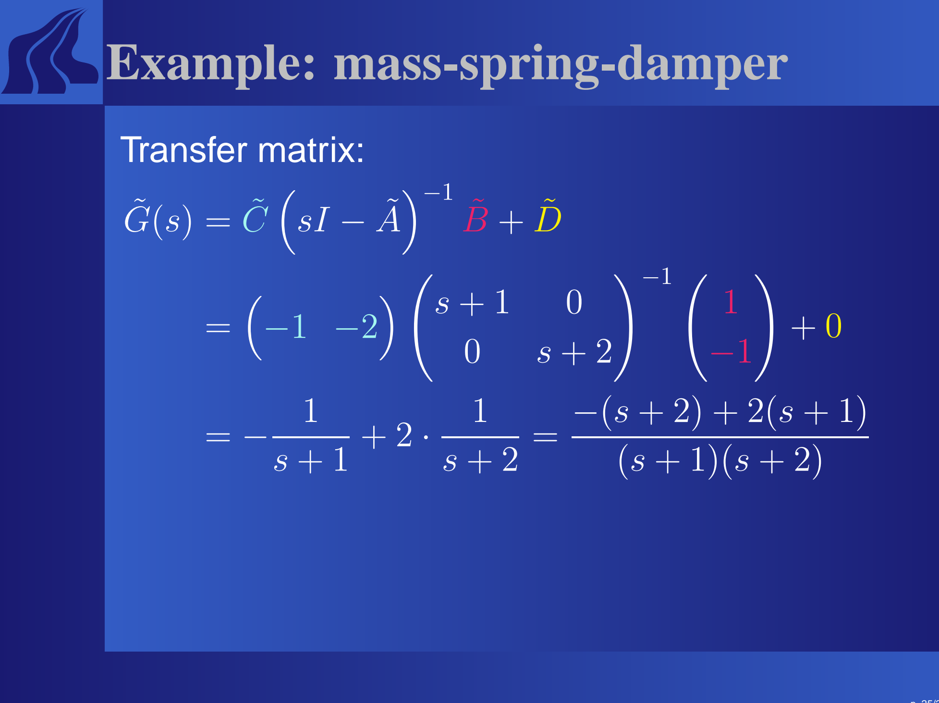
[picture p47: figure]
CExample: mass-spring-damper; Transfer matrix:

## CExample: (http://www.aau.dk/english/index.htm) mass-spring-damper

Transfer matrix:
G˜(s) = C˜ sI − A˜−1 | B˜ + D˜ = −1 | −2 s + 1 | 0 0 | s + 2!−1 | 1−1! + 0
= − | 1
s + 1 | + 2 ·

1
s + 2

= −(s + 2) + 2(s + 1)
(s + 1)(s + 2)
=

s
s² + 3s + 2

## CExample: (http://www.aau.dk/english/index.htm) mass-spring-damper

Transfer matrix:
G˜(s) = C˜ sI − A˜−1 | B˜ + D˜ = −1 | −2 s + 1 | 0 0 | s + 2!−1 | 1−1! + 0
= − | 1
s + 1 | + 2 ·

1
s + 2

= −(s + 2) + 2(s + 1)
(s + 1)(s + 2)
=

s
s² + 3s + 2
= G(s)
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
