raphaelcasimir/kord-stk/Old Report CDs/2010/Matlab/DiverseMaalinger/MaalArmogPind/MaalingPindogArm.xlsx

Arm |  | Pind
Volt | grader | Volt | grader
8.51 | -225 | 5.35 | -90
5.56 | -180 | 2.65 | -45
2.7 | -135 | 0 | 0
0.1 | -90 | -2.69 | 45
-2.95 | -45 | -5.33 | 90
-5.74 | 0
-8.59 | 45
