raphaelcasimir/kord-stk/Report/figures/ID_photo/Geoffroy.jpg

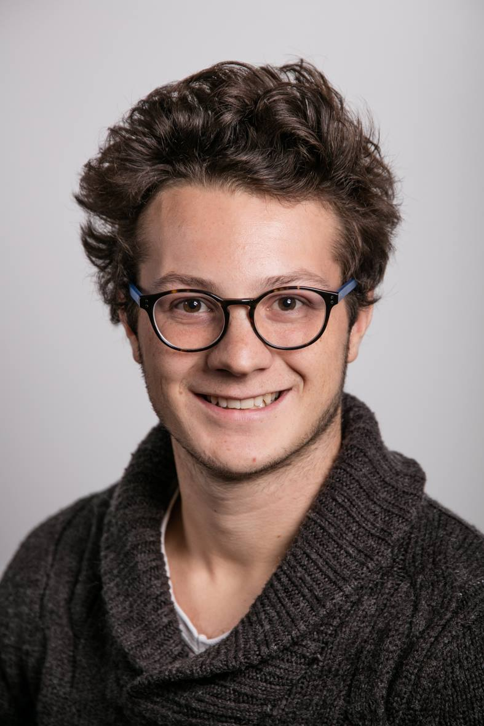
Report/figures/ID_photo/Geoffroy.jpg
