raphaelcasimir/kord-stk/Report/figures/ID_photo/Jacob.jpg

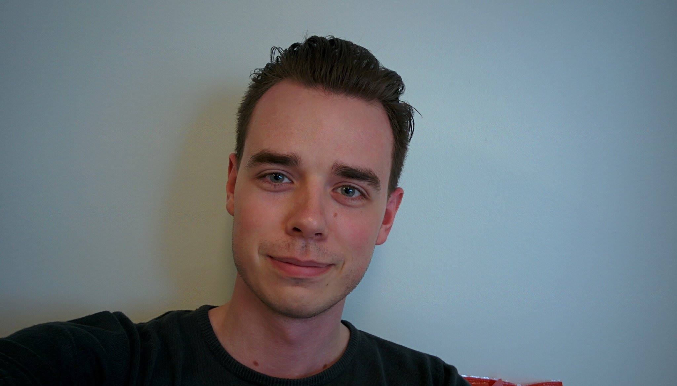
Report/figures/ID_photo/Jacob.jpg
