raphaelcasimir/kord-stk/Report/figures/ID_photo/Maxime.jpg

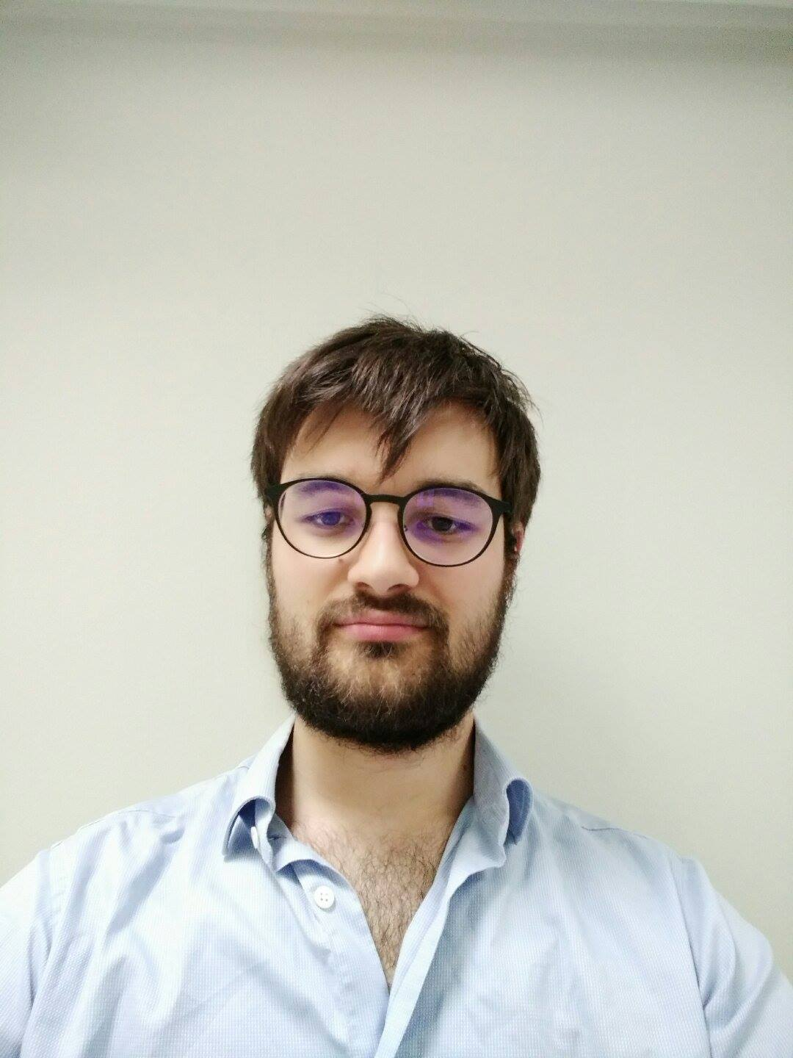
Report/figures/ID_photo/Maxime.jpg
