raphaelcasimir/kord-stk/Report/figures/ID_photo/Romain.jpg

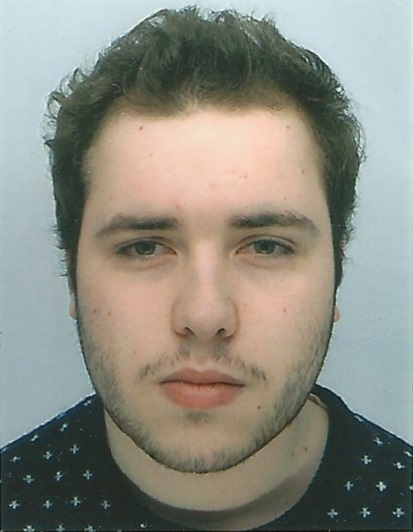
Report/figures/ID_photo/Romain.jpg
