raphaelcasimir/kord-stk/Report/figures/modeling/DCMotorRelation.png

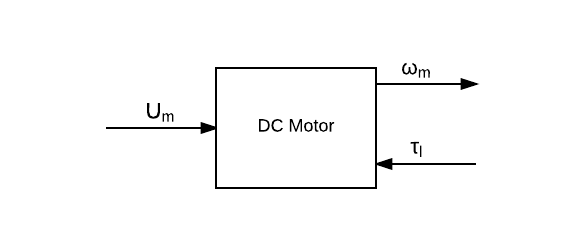
Report/figures/modeling/DCMotorRelation.png
