raphaelcasimir/kord-stk/Report/figures/modeling/MotorGearRelation.png

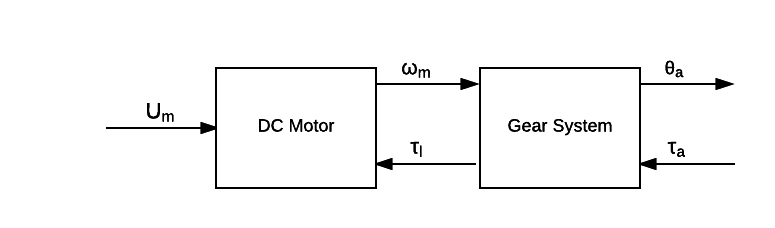
Report/figures/modeling/MotorGearRelation.png
