raphaelcasimir/kord-stk/Report/figures/modeling/NotUsedATM.png

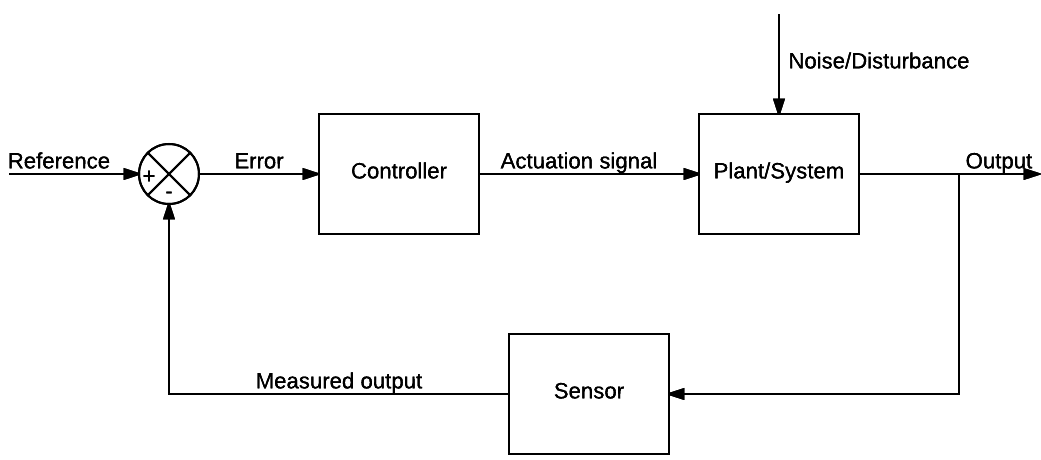
Report/figures/modeling/NotUsedATM.png
