raphaelcasimir/kord-stk/Report/figures/Preanalysis&Requirement/PendulumModeling/ForcePerp.jpg

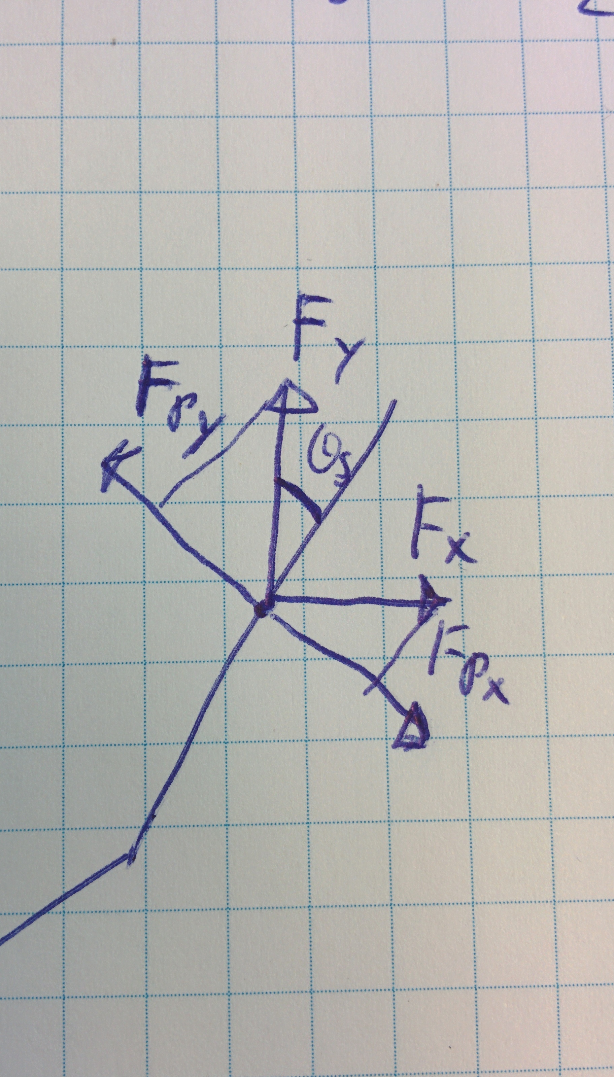
Report/figures/Preanalysis&Requirement/PendulumModeling/ForcePerp.jpg
