raphaelcasimir/kord-stk/Report/figures/Preanalysis&Requirement/PendulumModeling/FreeBodyPendulum.jpg

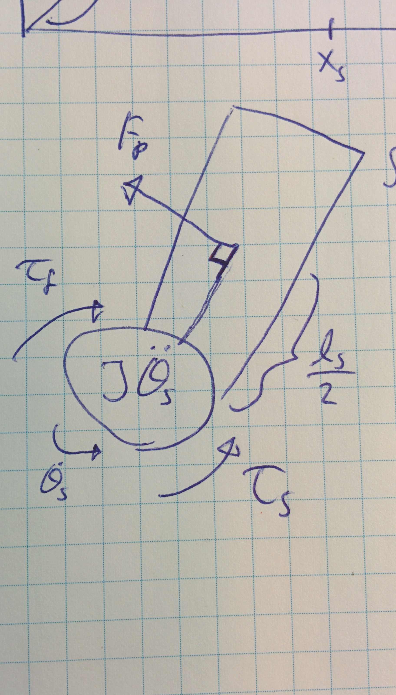
Report/figures/Preanalysis&Requirement/PendulumModeling/FreeBodyPendulum.jpg
