raphaelcasimir/kord-stk/Report/figures/Preanalysis&Requirement/RocketStability/UnstableRocketTrajectory.png

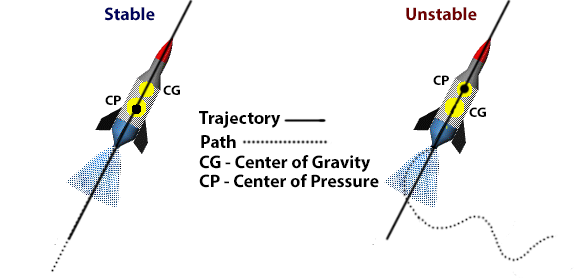
Report/figures/Preanalysis&Requirement/RocketStability/UnstableRocketTrajectory.png
