raphaelcasimir/kord-stk/Report/figures/Preanalysis&Requirement/SimilarSystems/double-inverted-pendulum.png

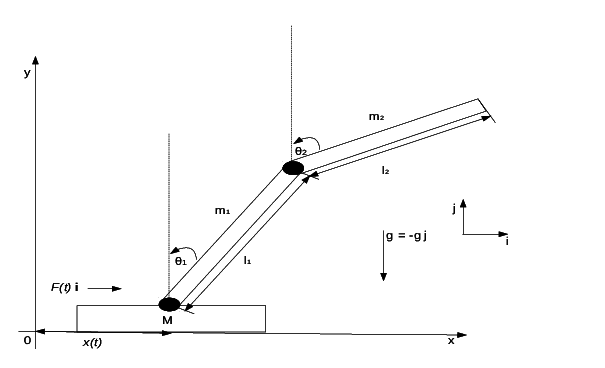
Report/figures/Preanalysis&Requirement/SimilarSystems/double-inverted-pendulum.png
