raphaelcasimir/kord-stk/Report/figures/RocketStructure.png

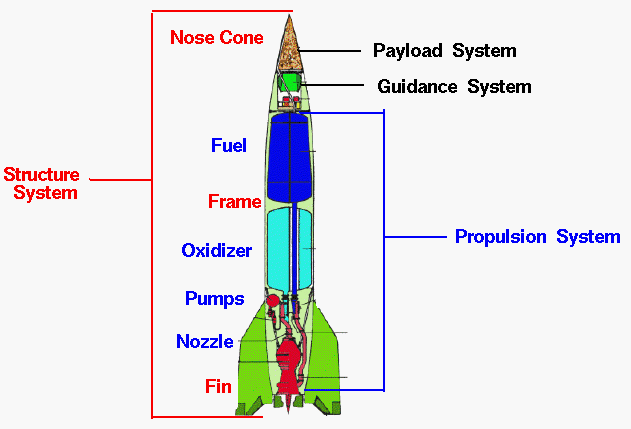
Report/figures/RocketStructure.png
