raphaelcasimir/kord-stk/Rocket/Gimbal_angle_error_calculator/Calculation_gimbal_angle.jpg

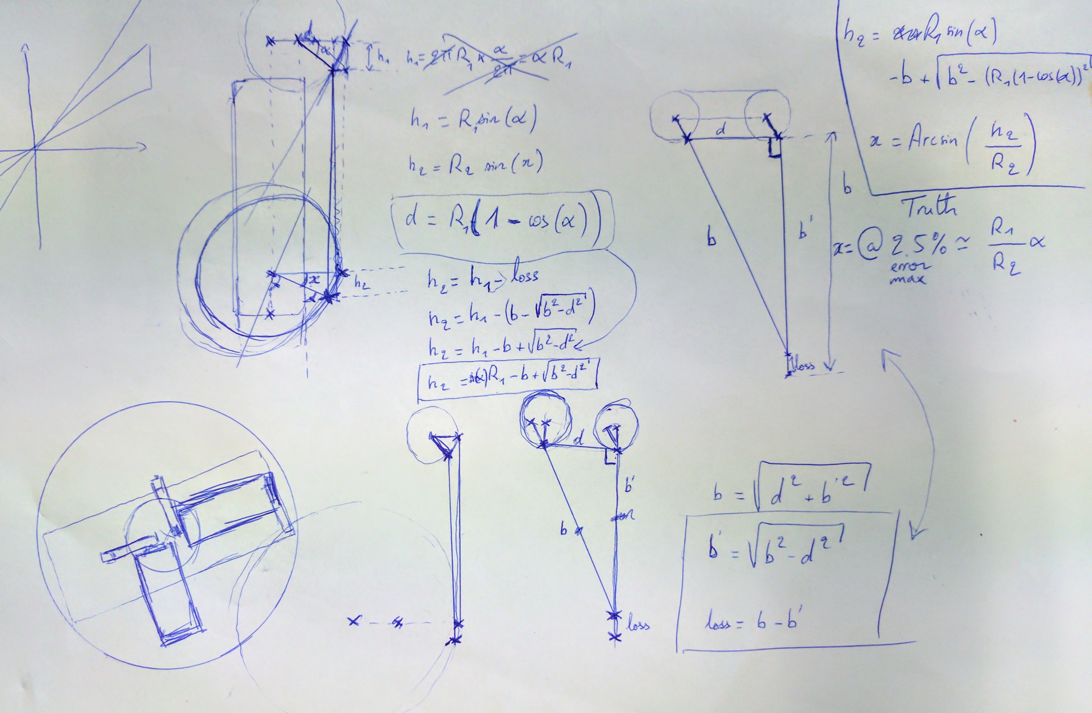
Rocket/Gimbal_angle_error_calculator/Calculation_gimbal_angle.jpg
