raphaelcasimir/kord-stk/Report/figures/Design/MotorLoop/MotorStepControlled.pdf

1.2 ----------

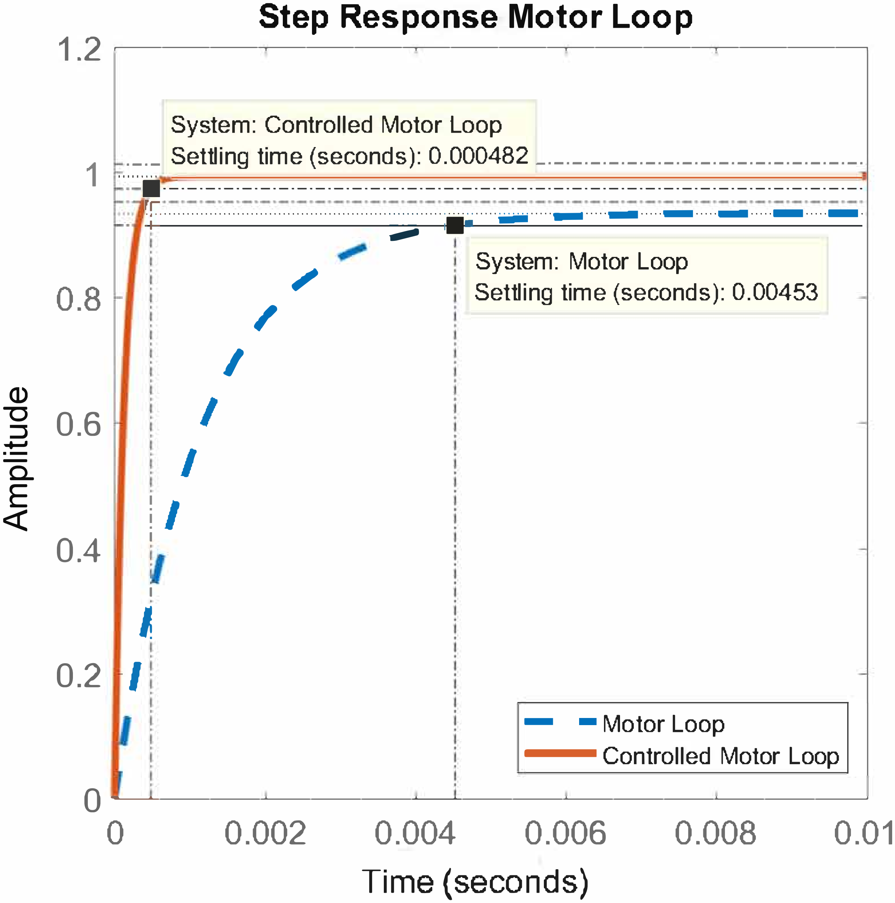
[picture p61: page 1]

Step Response Motor Loop

System: Controlled Motor Loop
1 ·-·- Settling time (s econds): 0.000482 -·-·-·-·-·-·-·-·-·-·-·-·-·-·-·-·-·-·

········-·-·-·-·-·-·-·-·-·-·-·-·-·-·-·-·-·-·-·-·-·-·-·-·-·-·-·-·-·-·-·-·-·-·-·-·-·-·
{······················································;iiijii

'''''iiiiiii'''''-·····-·····-·····-·····-·····-·

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
0.2 I

I
I
/

System: Motor Loop
Settling time (s econds): 0.00453

⁻ - -Motor Loop
Controlled Motor Loop

o---------
0 | 0.002 | 0.004 | 0.006
Time (seconds)

0.008 0.01

## Amplitude
