raphaelcasimir/kord-stk/Report/chapters/appendices/BmTest.tex

\begin{table}[htbp]
	\centering
	\caption{List of measurement equipment and components}\label{tab_appendix:BmSetUp}
	
	\begin{tabularx}{\textwidth}{lXXXX}
		Name 				& Brand	& Model & AAU-number									\\ \toprule \rowcolor{lightGrey}
		Oscilloscope	& Agilent & 54621D & 33941 	\\
		Powersupply	& Agilent & E3631A & 78577\\ \rowcolor{lightGrey}
		DC motor & Alsthom BBC & F9M2& 08339
	\end{tabularx}
\end{table}

\subsubsection*{Setup}
\autoref{fig:BmMeasurementSetup} shows a diagram and photo of the measurement set up.
\begin{figure}[htbp]
	\centering
	\begin{subfigure}{0.50\textwidth}
		
		\caption{Diagram of the set up.} \label{fig:BmMeasurementDiagram}
	\end{subfigure}
	\begin{subfigure}{0.40\textwidth}
		
		%\missingfigure{Picture of the setup}
		\caption{Picture of the setup.} \label{fig:BmMeasurementPictures}
	\end{subfigure}
	\caption{The measurement set up for .} \label{fig:BmMeasurementSetup}   
\end{figure}

\subsubsection*{Method}
This test consists of having the motor shaft running in steady state while the torque $\tau_m$, the shaft angular velocity $\omega$ and the current $I$ are measured.

\subsubsection*{Raw data}
\autoref{tab_appendix:BmData} has all the measurements done.

\begin{figure}[htbp]
	\centering
	\caption{Raw data used to determine $B_m$}\label{tab_appendix:BmData}
	\begin{tabularx}{0.35\textwidth}{XX}
		Current (A) & $\omega$ (rad/s)\\ \toprule \rowcolor{lightGrey}
	0.74 & 89.0  \\
0.76 & 96.9  \\ \rowcolor{lightGrey}
0.78 & 106.8 \\
0.80 & 116.2 \\ \rowcolor{lightGrey}
0.82 & 128.8 \\
0.84 & 144.5 \\ \rowcolor{lightGrey}
0.86 & 150.8 \\
0.88 & 165.5 \\ \rowcolor{lightGrey}
0.90 & 184.3 \\
0.92 & 204.2 \\ \rowcolor{lightGrey}
0.94 & 216.8 \\
0.96 & 232.5 \\ \rowcolor{lightGrey}
0.98 & 252.4 \\
1.00 & 289.0 \\ \rowcolor{lightGrey}
1.03 & 321.5
	\end{tabularx}
\end{figure}

\subsubsection*{Data processing}

The motor and the shaft are in steady state so $\tau_m=\tau_{fm}$ which combined with \autoref{eq:FrictionTorque} gives \autoref{eq:BmTest}.

\begin{equation}\label{eq:BmTest}
B_m=\frac{K_t I}{\omega} \addunit{\newton\per\radian\second}
\end{equation}
\startexplain
\explain{$I$ is the current in the circuit}{\si{\ampere}}
\explain{$K_t$ is the motor's torque constant}{\si{\newton\meter\per\ampere}}
\explain{$\omega$ is the shaft's angular velocity}{\si{\radian\per\second}}
\explain{$B_m$ is the viscous friction constant}{\si{\newton\meter\per\radian\second}}
\stopexplain

\subsubsection*{Conclusion}

\autoref{fig:BmTest} plots the $B_m$ found for each measurement. The $B_m$ used in the model is the average of these points. This gives $B_m=\SI{120}{\micro\newton\meter\per\radian\second}$.

\begin{figure}[htbp]
	\centering
	
	\caption{Plot of $B_m$ found for each measures}\label{fig:BmTest}
\end{figure}
