raphaelcasimir/kord-stk/Report/chapters/appendices/LmRmTest.tex

\subsection{Internal Resistance of the DC Motor $R_m$}\label{sec:MeasRm}
\begin{table}[htbp]
	\centering
	\caption{List of measurement equipment and components}\label{tab_appendix:RMSetUp}
	
	\begin{tabularx}{\textwidth}{lXXXX}
		Name 				& Brand	& Model & AAU-number									\\ \toprule \rowcolor{lightGrey}
		Oscilloscope	& Agilent & 54621D & 33941 	\\
		Powersupply	& Agilent & E3631A & 78577\\ \rowcolor{lightGrey}
		DC motor & Alsthom BBC & F9M2& 08339
	\end{tabularx}
\end{table}

The first parameter to be tested is the internal resistance of the motor $R_m$. This resistance is needed in the motor's transfer function and will be used to determine the other parameters of the motor. 
\subsubsection*{Setup}
\autoref{fig:RmMeasurementSetup} shows a diagram and photo of the measurement set up
\begin{figure}[htbp]
	\centering
	\begin{subfigure}{0.50\textwidth}
		
		\caption{Diagram of the setup.} \label{fig:RmMeasurementDiagram}
	\end{subfigure}
	\begin{subfigure}{0.40\textwidth}
			
		\caption{Picture of the setup.} \label{fig:RmMeasurementPictures}
	\end{subfigure}
	\caption{The measurement setup.} \label{fig:RmMeasurementSetup}   
\end{figure} 

\subsubsection*{Method}
This test consists of having the motor shaft locked while the voltage is increased by 0.5 V between each measurements.

\subsubsection*{Raw data}
\autoref{tab_appendix:RmData} is the plotted evolution of the voltage of the circuit according to the current.

\begin{table}[htbp]
	\centering
	\caption{Raw data used to determine $R_m$}\label{tab_appendix:RmData}
	\begin{tabularx}{0.35\textwidth}{XX}
		Voltage (V) & Current (A)\\ \toprule \rowcolor{lightGrey}
		0.50 & 0.33 \\
		1.00 & 0.71 \\ \rowcolor{lightGrey}
		1.50 & 1.13 \\
		2.00 & 1.67 \\ \rowcolor{lightGrey}
		2.49 & 2.34 \\
		2.98 & 2.94 \\ \rowcolor{lightGrey}
		3.50 & 3.75 \\
		3.99 & 4.68 \\ \rowcolor{lightGrey}
		4.50 & 5.54 \\
		4.98 & 6.11 \\ \rowcolor{lightGrey}
		5.54 & 6.46 \\
		6.02 & 7.40 \\ \rowcolor{lightGrey}
		6.51 & 8.26 \\
		7.01 & 9.14 
	\end{tabularx}
\end{table}

\subsubsection{Data Processing}
In order to find the motor's resistance $R_m$, the electrical equations of the motor will be used:
\begin{equation}
	U_m = R_m \cdot i + L_m \frac{di}{dt} + K_e\omega_m
\end{equation}

With the motor shaft locked, $\omega_m = 0$. Moreover, the measurements are made a couple seconds after the change in voltage is made. The current is then constant, canceling its derivative. 

The resulting equation is Ohm's law:
\begin{equation}
U_m = R_m \cdot i
\end{equation}

The measurement of voltage according to the current is presented in \autoref{fig:Rmplot}.
\begin{figure}[htbp]
	
	\caption{Measurement of voltage according to the current} \label{fig:Rmplot}
\end{figure}

$R_m$ is the slope of the linear approximation (in dashed yellow) of the voltage over the current: 
\begin{subequations} \label{eq:LaEq}
	\begin{flalign}
		&U_m = R_m \cdot i \\
		&R_m \approx \SI{0.82}{\ohm}
	\end{flalign}
\end{subequations}

\newpage
\subsection{Internal Inductance of the DC Motor $L_m$}
\begin{table}[htbp]
	\centering
	\caption{List of measurement equipment and components}\label{tab_appendix:LaSetUp}

	\begin{tabularx}{\textwidth}{lXXXX}
		Name 				& Brand	& Model & AAU-number									\\ \toprule \rowcolor{lightGrey}
		Oscilloscope	& Agilent & 54621D & 33941 	\\
		Powersupply	& Agilent & E3631A & 78577\\ \rowcolor{lightGrey}
		DC motor & Alsthom BBC & F9M2& 08339 
	\end{tabularx}
\end{table}
\subsubsection*{Setup}
\autoref{fig:LaMeasurementSetup} shows a diagram and photo of the measurement set up.
\begin{figure}[htbp]
	\centering
	\begin{subfigure}{0.50\textwidth}
		
		\caption{Diagram of the setup.} \label{fig:LaMeasurementDiagram}
	\end{subfigure}
	\begin{subfigure}{0.40\textwidth}
		
		\caption{Picture of the setup.} \label{fig:LaMeasurementPictures}
	\end{subfigure}
	\caption{$L_m$ measurement setup.} \label{fig:LaMeasurementSetup}   
\end{figure}

\subsubsection*{Method}
This test consists of having the motor shaft locked while a step is applied. The current is measured through the circuit. With the current step response, the inductance of the motor can be found. 
\subsubsection*{Raw data}
\autoref{fig:LaTestCurrentPlot} is the plotted evolution of the current of the circuit in respect to time.

\begin{figure}[htbp]
	\centering
	
	\caption{Plot of the current step response in respect to time}\label{fig:LaTestCurrentPlot}
\end{figure}

\newpage
\subsubsection*{Data processing}
When the shaft is locked and a step is applied the DC motor's electric equation can be resumed as in \autoref{eq:LmEquation}.
\begin{equation}
	F(s)=\frac{I(s)}{U(s)}=\frac{\frac{1}{R_m}}{\frac{L_m}{R_m} s+1} \addunit{1}
	\label{eq:LmEquation}
\end{equation}
\startexplain
\explain{$I(s)$ is the current in Laplace domain}{1}
\explain{$U(s)$ is the body's acceleration}{1}
\explain{$R_m$ is the internal resistance of the motor}{\si{\ohm}}
\explain{$L_m$ is the internal inductance of the motor}{\si{\henry}}
\stopexplain

When a unit step response is applied to the system \autoref{eq:LmEquation} becomes \autoref{eq:LmEquationStep}.

\begin{equation}
F(s)=\frac{\frac{1}{R_m}}{\frac{L_m}{R_m} s+1}\frac{1}{s}=\frac{-\frac{1}{R_m}}{s+\frac{R_m}{L_m}}+\frac{1}{R_m s} \addunit{1}
\label{eq:LmEquationStep}
\end{equation}

\autoref{eq:LmEquationStep} is then put in the continuous time domain to get \autoref{eq:LmEquationStepTime}.

\begin{equation}
f(t)= \frac{1}{R_m} \left(1-e^{-\frac{R_m}{L_m} t}\right) \addunit{1}
\label{eq:LmEquationStepTime}
\end{equation}

\autoref{eq:LmEquationStepTime} means that at $t=\frac{L_m}{R_m}$ the function would give $1-e^{-1} \approx \SI{63.2}{\percent}$ of its settling value given that the step starts at 0 seconds. Therefore, at \SI{63.2}{\percent} of the settling value $t=\frac{L_m}{R_m}$. \\
Since $R_m=\SI{0.82}{\ohm}$ is known, finding $L_m$ becomes trivial. Here, the step starts at 0.00348 s.

\subsubsection*{Conclusion}

Since the settling value of the output current is \SI{4.04}{\ampere}. Then \autoref{eq:LmEq} gives the value of $L_m$.

\begin{subequations} \label{eq:LmEq}
	\begin{flalign}
		&\frac{1}{R_m} \left(1-e^{-\frac{R_m}{L_m} t}\right) = 4.04 \cdot 0.63212055882 \addunit{\second} \\
		&t \approx 0.00367 - 0.00348 \approx \SI{0.00019}{\second} \\
		&L_m=tR_m \\
		&L_m \approx \SI{156}{\micro\henry}
	\end{flalign}
\end{subequations}
