raphaelcasimir/kord-stk/Report/figures/appendix/Motor&GearTests/plotRm.pdf

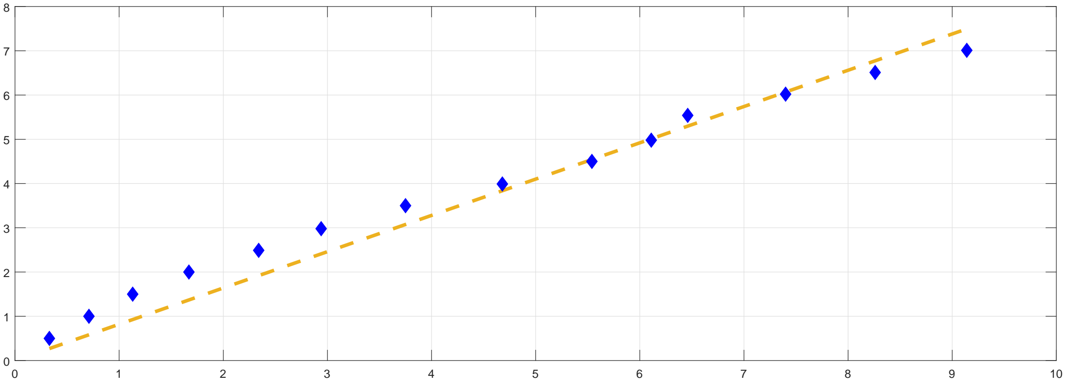
[picture p69: figure]

## Current (A)

## Voltage (V)

## Rm measurements
