raphaelcasimir/kord-stk/Report/figures/appendix/Motor&GearTests/PlotBm.pdf

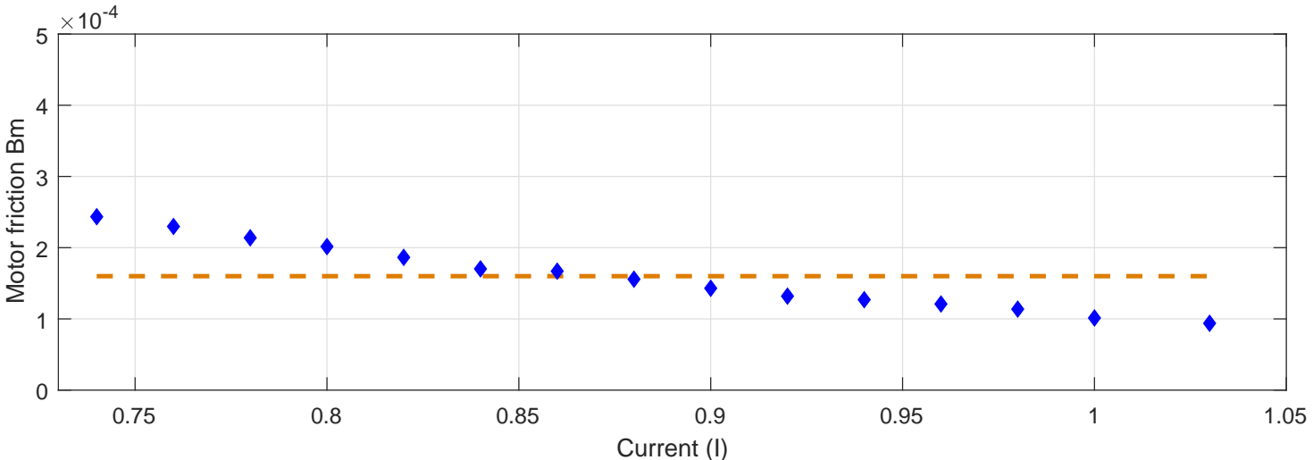
[picture p70: figure]
Current (I); Motor friction Bm
