raphaelcasimir/kord-stk/Report/figures/appendix/Motor&GearTests/PlotKe.pdf

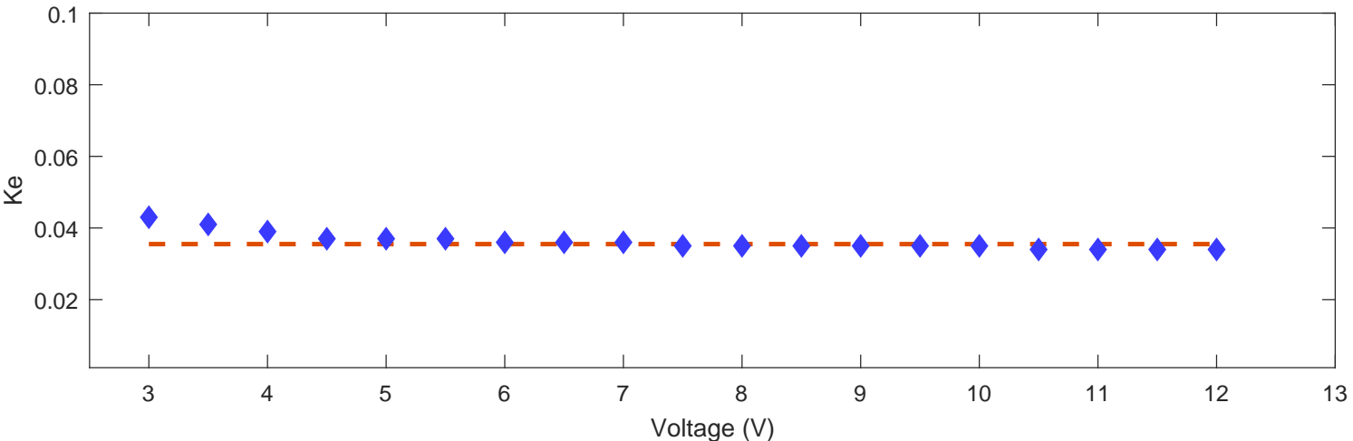
[picture p71: figure]
Voltage (V)
