raphaelcasimir/kord-stk/Report/figures/appendix/Motor&GearTests/PlotKt.pdf

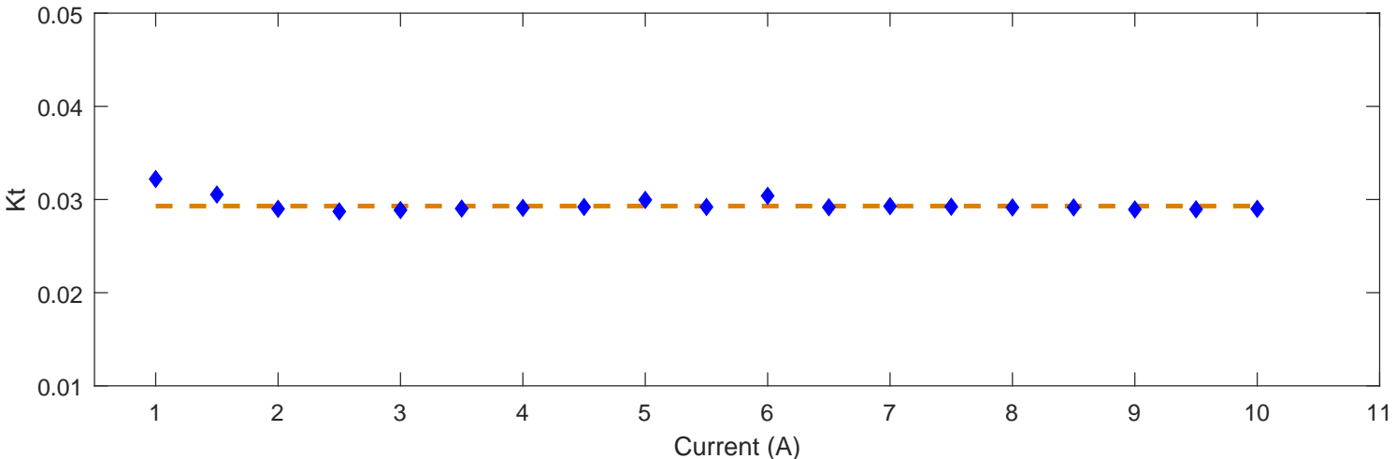
[picture p72: figure]
Current (A)
