raphaelcasimir/kord-stk/Report/figures/appendix/Motor&GearTests/PlotKe-eps-converted-to.pdf

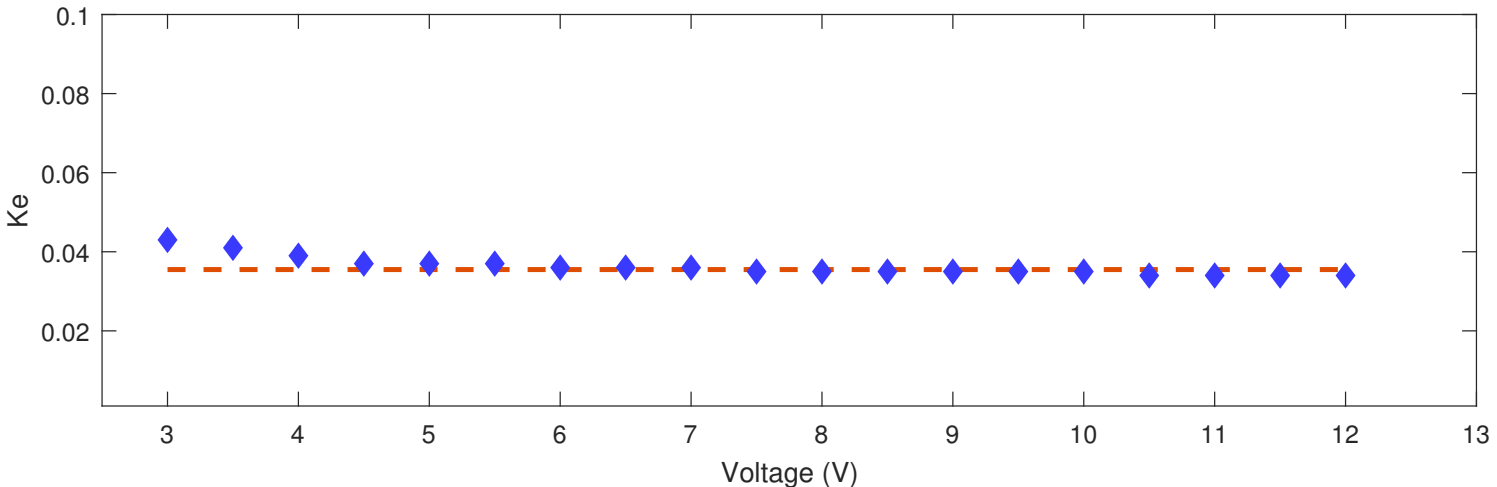
[picture p73: figure]
Voltage (V)
