raphaelcasimir/kord-stk/Test Results/Motor Ra (New tests).xlsb.xlsx

 |  |  |  |  |  |  |  |  |  |  |  |  |  |  |  |  |  |  |  |  |  |  |  |  |  |  |  |  |  |  |  |  |  |  |  | New, real shit, not fake news, legit tests results
I2 [A] | U1 | U2 |  | Uavg | Rm [ohm] |  |  |  |  |  |  |  |  |  |  |  |  |  |  |  |  |  |  |  |  |  |  |  |  |  |  |  |  |  |  |  |  | 0.5 | 1 | 1.5 | 2 | 2.49 | 2.98
0.5 | 0.72 | 0.72 |  | 0.72 | 1.44 |  |  |  |  |  |  |  |  |  |  |  |  |  |  |  |  |  |  |  |  |  |  |  |  |  |  |  |  |  |  |  |  |  |  |  |  |  | U (V)
1 | 1.46 | 1.46 |  | 1.46 | 1.46 |  |  |  |  |  |  |  |  |  |  |  |  |  |  |  |  |  |  |  |  |  |  |  |  |  |  |  |  | Motor Parameters |  |  |  |  |  |  |  |  | 0.50
1.5 | 2.37 | 1.98 |  | 2.175 | 1.45 |  |  |  |  |  |  |  |  |  |  |  |  |  |  |  |  |  |  |  |  |  |  |  |  |  |  |  |  | Rm = | 0.82 |  |  |  |  |  |  |  | 1.00
2 | 2.87 | 2.62 |  | 2.745 | 1.3725 |  |  |  |  |  |  |  |  |  |  |  |  |  |  |  |  |  |  |  |  |  |  |  |  |  |  |  |  | Lm = | 0.0102 |  |  |  |  |  |  |  | 1.50
2.5 | 3.2 | 2.96 |  | 3.08 | 1.232 |  |  |  |  |  |  |  |  |  |  |  |  |  |  |  |  |  |  |  |  |  |  |  |  |  |  |  |  | Ke = | 0.0366 |  |  |  |  |  |  |  | 2.00
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
