raphaelcasimir/kord-stk/Test Results/Motor Ra.xlsx

I2 [A] | U1 | U2 |  | Uavg | Ra [ohm]
0.5 | 0.72 | 0.72 |  | 0.72 | 1.44
1 | 1.46 | 1.46 |  | 1.46 | 1.46
1.5 | 2.37 | 1.98 |  | 2.175 | 1.45
2 | 2.87 | 2.62 |  | 2.745 | 1.3725
2.5 | 3.2 | 2.96 |  | 3.08 | 1.232
3 | 3.15 | 3.08 |  | 3.115 | 1.038333333
3.5 | 3.4 | 3.25 |  | 3.325 | 0.95
4 | 3.73 | 3.62 |  | 3.675 | 0.91875
4.5 | 3.92 | 3.77 |  | 3.845 | 0.8544444444
5 | 4.41 | 4.27 |  | 4.34 | 0.868
5.5 | 4.56 | 4.64 |  | 4.6 | 0.8363636364
6 | 4.75 | 4.74 |  | 4.745 | 0.7908333333
6.5 | 5.06 | 5.14 |  | 5.1 | 0.7846153846
7 | 5.37 | 5.28 |  | 5.325 | 0.7607142857
 |  |  |  |  |  |  |  |  |  | Test of angular velocity to get Ke
 |  |  |  |  |  |  | Internal |  |  |  | External
 |  |  |  | U (V) | I(A) |  | Vtin(V) | rpm | omega(int) |  | Vtex(mV) | rpm | omega(ext)
 |  |  |  | 4.5 | 0.765 |  | 2.3 | 76.66666667 | 8.03 |  | 11 | 110 | 11.52
 |  |  |  | 5 | 0.76 |  | 2.8 | 93.33333333 | 9.77 |  | 21 | 210 | 21.99
 |  |  |  | 5.5 | 0.78 |  | 3.2 | 106.6666667 | 11.17 |  | 24 | 240 | 25.13
 |  |  |  | 6 | 0.79 |  | 3.7 | 123.3333333 | 12.92 |  | 27 | 270 | 28.27
 |  |  |  | 6.5 | 0.815 |  | 4.1 | 136.6666667 | 14.31 |  | 30 | 300 | 31.42
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
