raphaelcasimir/kord-stk/GearTrain/GearTrainTest/Amplifier/AmpInputVoltage.CSV

Record Length | 2.500000e+03 | -0.500000000000 | 0.72000
Sample Interval | 4.000000e-04 | -0.499600000000 | 0.72000
Trigger Point | 1.250000000000e+03 | -0.499200000000 | 0.72000
 |  | -0.498800000000 | 0.72000
 |  | -0.498400000000 | 0.72000
 |  | -0.498000000000 | 0.72000
Source | CH1 | -0.497600000000 | 0.72000
Vertical Units | V | -0.497200000000 | 0.72000
Vertical Scale | 2.000000e+00 | -0.496800000000 | 0.72000
Vertical Offset | -7.120000e+00 | -0.496400000000 | 0.72000
Horizontal Units | s | -0.496000000000 | 0.72000
Horizontal Scale | 1.000000e-01 | -0.495600000000 | 0.72000
Pt Fmt | Y | -0.495200000000 | 0.72000
Yzero | 0.000000e+00 | -0.494800000000 | 0.64000
Probe Atten | 1.000000e+00 | -0.494400000000 | 0.72000
Model Number | TDS2004B | -0.494000000000 | 0.64000
Serial Number | C030598 | -0.493600000000 | 0.72000
Firmware Version | FV:v22.16 | -0.493200000000 | 0.72000
 |  | -00.492800000000 | 0.72000
 |  | -00.492400000000 | 0.72000
 |  | -00.492000000000 | 0.72000
 |  | -00.491600000000 | 0.72000
 |  | -00.491200000000 | 0.72000
 |  | -00.490800000000 | 0.72000
 |  | -00.490400000000 | 0.72000
 |  | -00.490000000000 | 0.72000
 |  | -00.489600000000 | 0.72000
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
