raphaelcasimir/kord-stk/Report/figures/appendix/srb_test_setup_raw.png

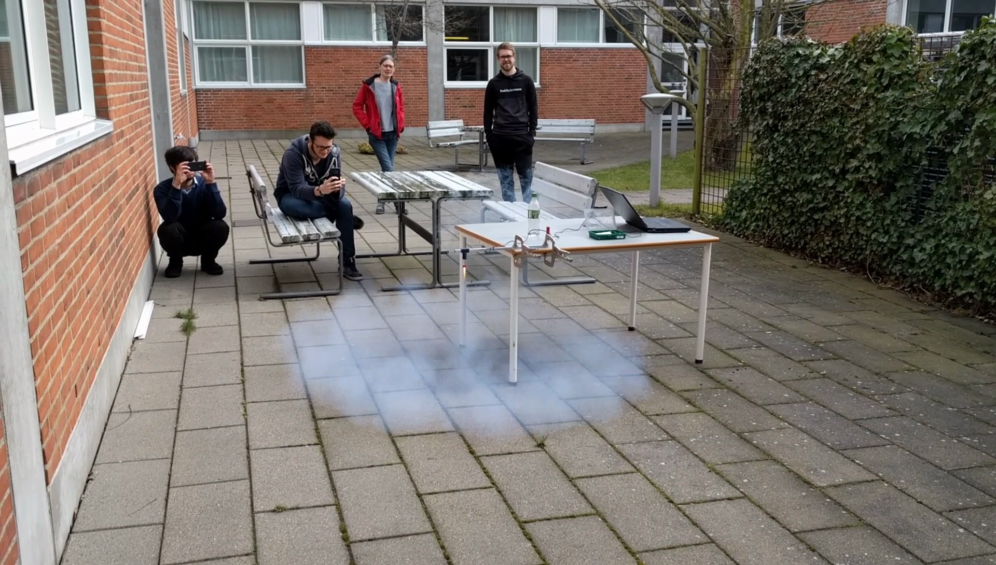
Report/figures/appendix/srb_test_setup_raw.png
