raphaelcasimir/kord-stk/Report/figures/Flowchart.pdf

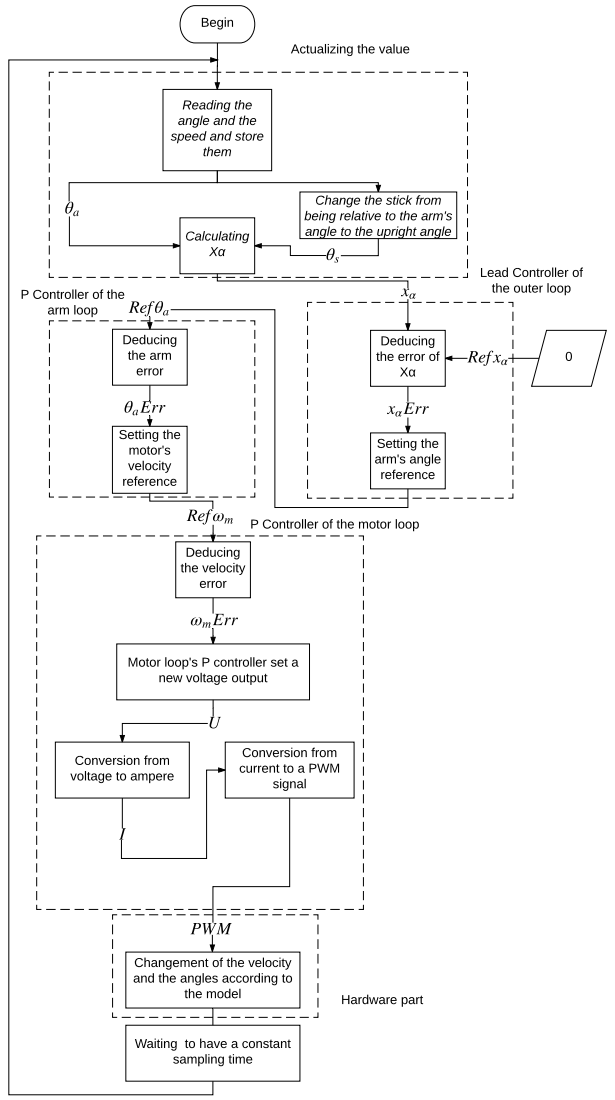
[picture p75: page 1]
Setting the arm's angle reference; Deducing the arm error; velocity reference; Conversion from; voltage to ampere; the model; Hardware part; Begin

Actualizing the value

Reading the
angle and the
speed and store
them

Change the stick from
being relative to the arm's

angle to the upright angle Calculating X?

Lead Controller of
the outer loop

P Controller of the
arm loop

Deducing
the error of X?

Setting the motor's

P Controller of the motor loop

the velocity error

Motor loop's P controller set a
new voltage output

current to a PWM
signal

Changement of the velocity and the angles according to

Waiting to have a constant sampling time
