raphaelcasimir/kord-stk/Report/figures/MotorControllerSetup.pdf

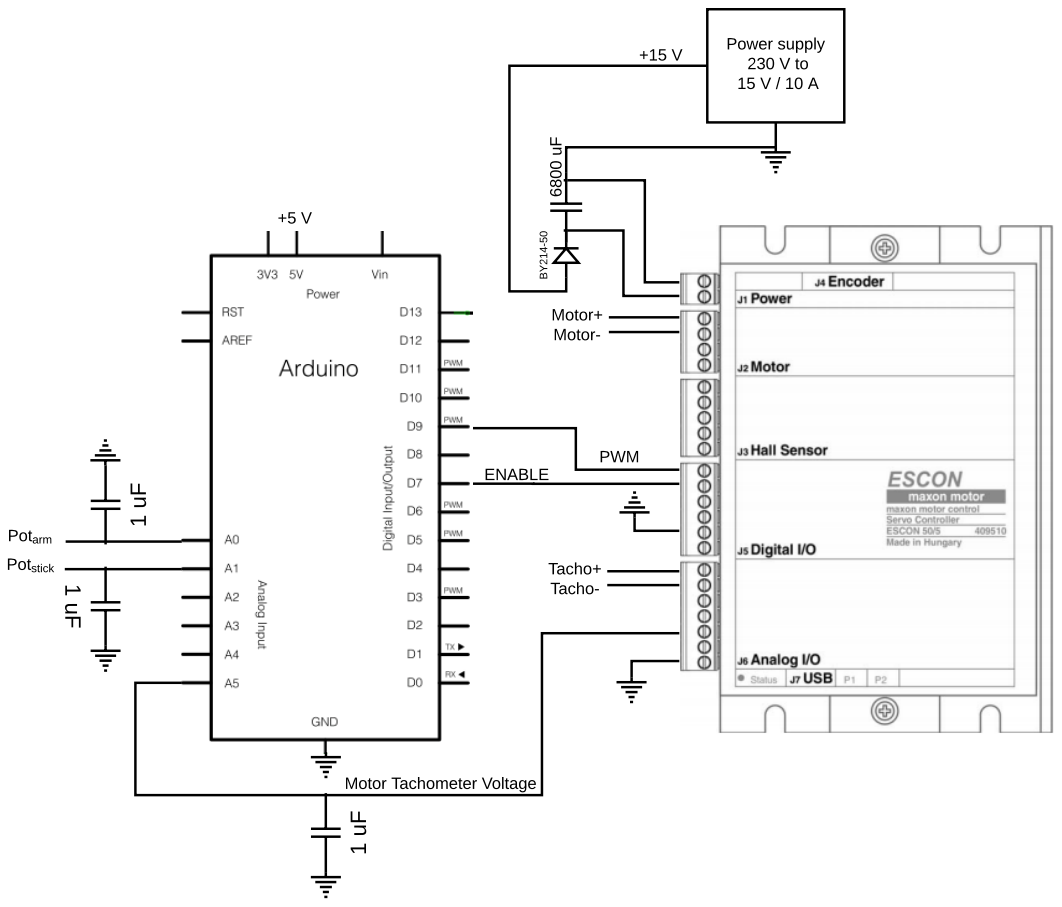
[picture p76: page 1]
PWM; ENABLE; Power supply 230 V to 15 V / 10 A; Motor+ Motor-; Potarm; Potstick; 6800 uF BY214-50 Tacho+; Tacho-

Motor Tachometer Voltage
