raphaelcasimir/kord-stk/Report/figures/appendix/LaTestCurrentPlot-eps-converted-to.pdf

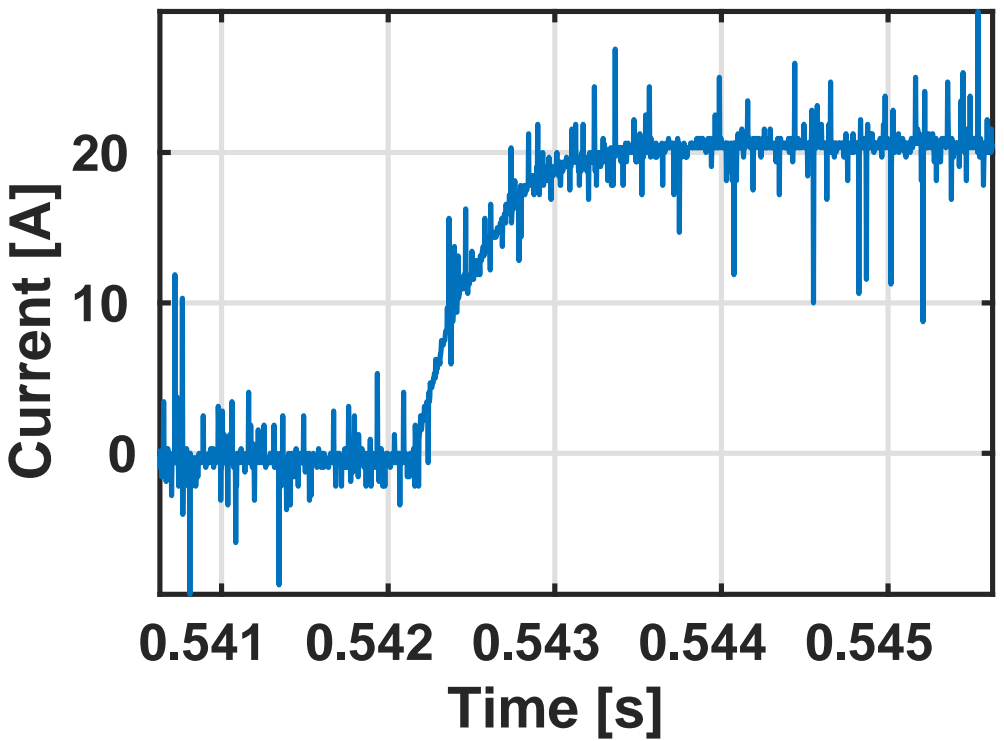
[picture p77: page 1]
0.541 0.542 0.543 0.544 0.545 Time [s]; Current [A]
