raphaelcasimir/kord-stk/Report/figures/modeling/Rocket/Rocket diagram.pdf

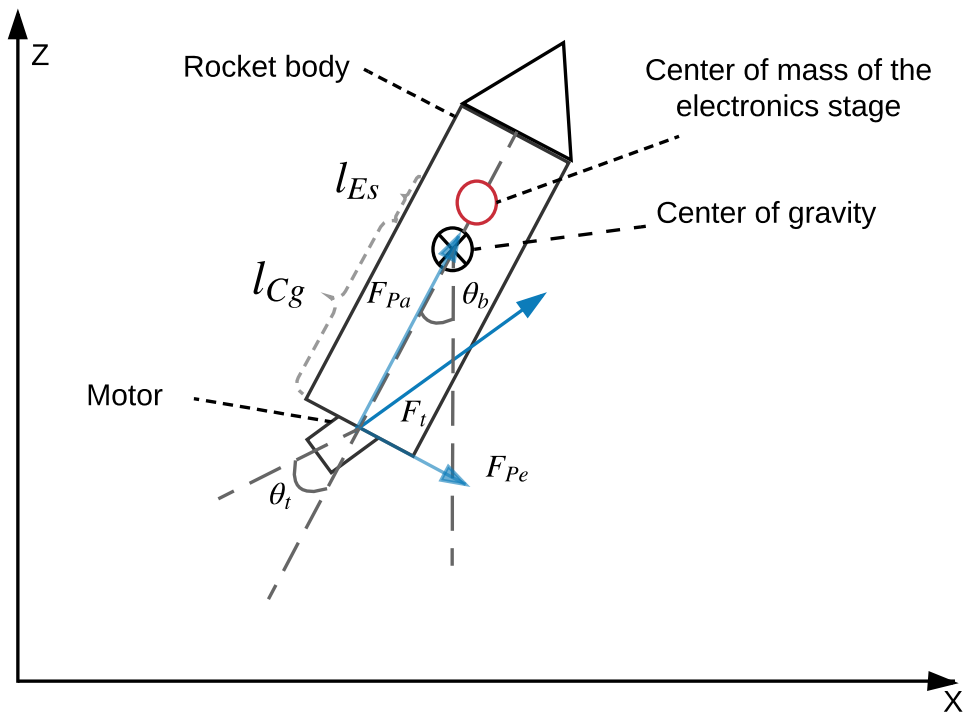
[picture p78: page 1]
Motor; Rocket body

Center of mass of the
electronics stage

Center of gravity
