raphaelcasimir/kord-stk/Report/figures/appendix/Motor&GearTests/PlotLm.pdf

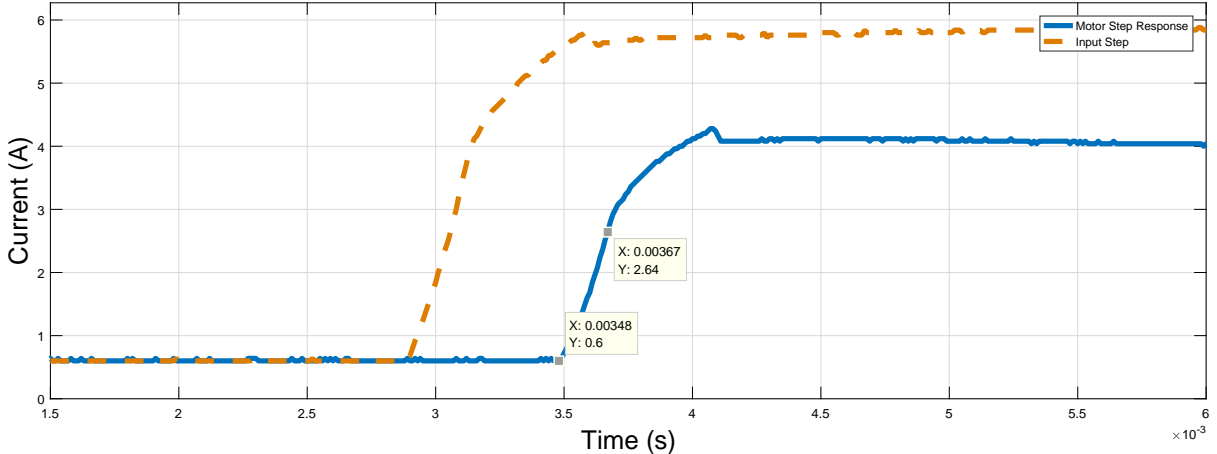
[picture p79: page 1]
Time (s); Current (A)

Motor Step Response
Input Step

X: 0.00348
Y: 0.6
