raphaelcasimir/kord-stk/Report/figures/Design/IPController/BlockAllLoops.pdf

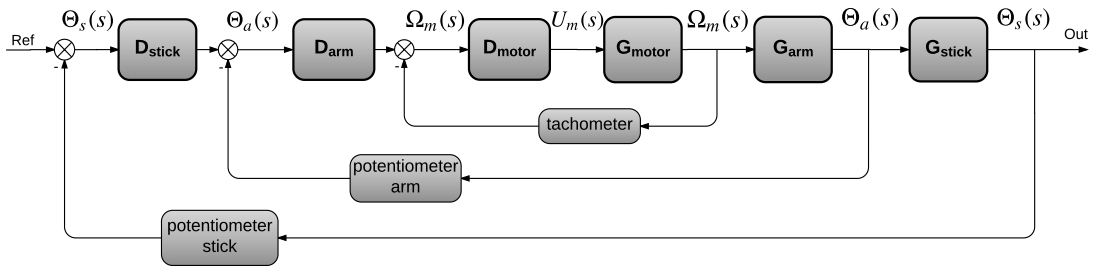
[picture p80: page 1]
Ref; Dstick; Darm; Garm; Gstick; potentiometer arm; potentiometer stick; Out; Dmotor; Gmotor; tachometer
