raphaelcasimir/kord-stk/Report/figures/Design/IPController/IPBlock.pdf

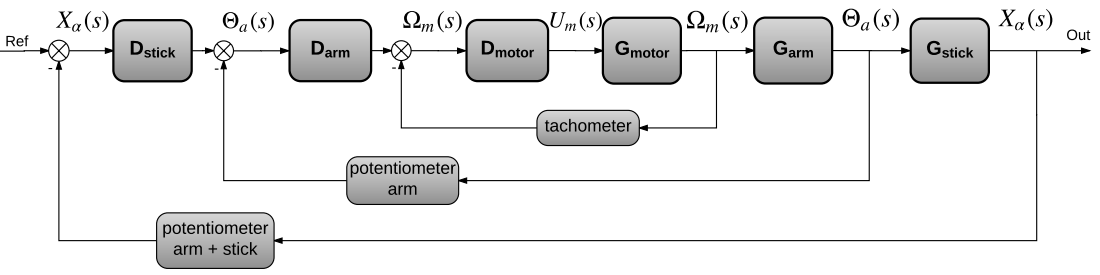
[picture p81: page 1]
Ref; Dstick; Darm; Garm; Gstick; potentiometer arm; potentiometer arm + stick; Out; Dmotor; Gmotor; tachometer
