raphaelcasimir/kord-stk/Report/figures/modeling/Motor/InputOutputMotor.pdf

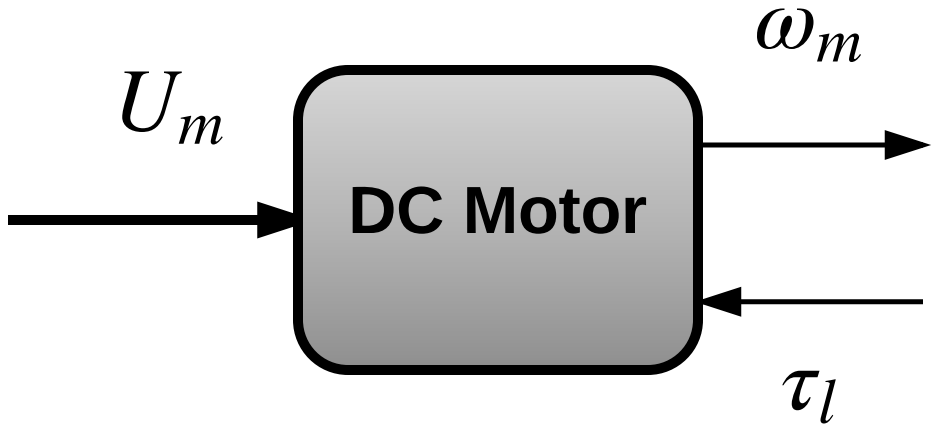
[picture p82: page 1]
DC Motor
