raphaelcasimir/kord-stk/Report/figures/modeling/gearTrain/GearSystemDiagram.pdf

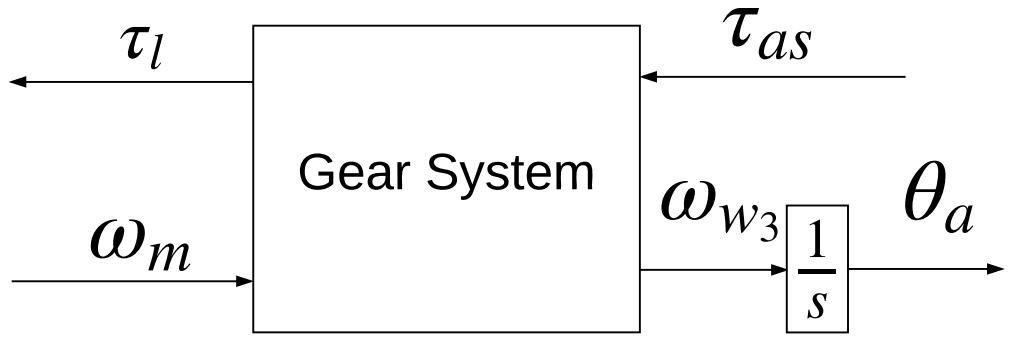
[picture p83: page 1]
Gear System
