raphaelcasimir/kord-stk/Report/figures/appendix/Motor&GearTests/RmTestSetUpDiagram.pdf

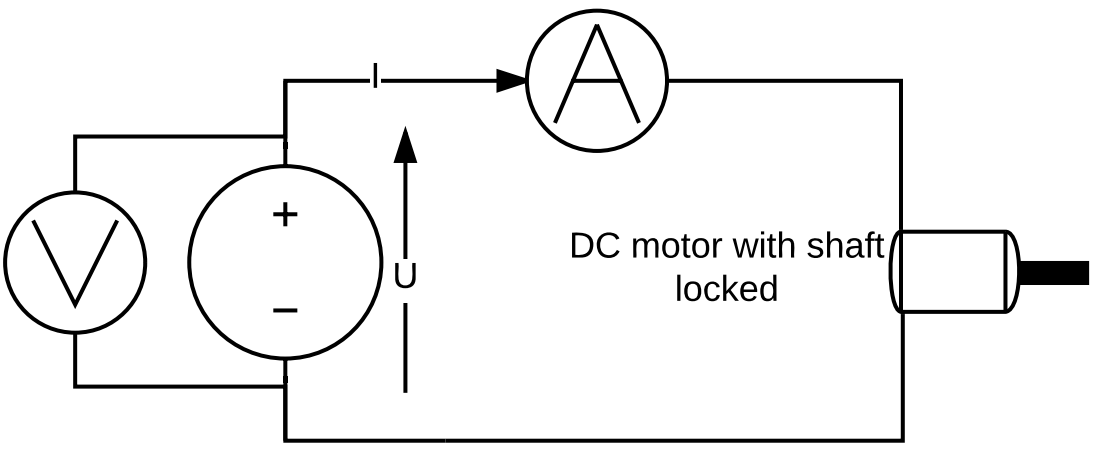
[picture p84: page 1]

DC motor with shaft
locked
