raphaelcasimir/kord-stk/Report/figures/modeling/Motor/Tauplot-converted-to-pdf.pdf

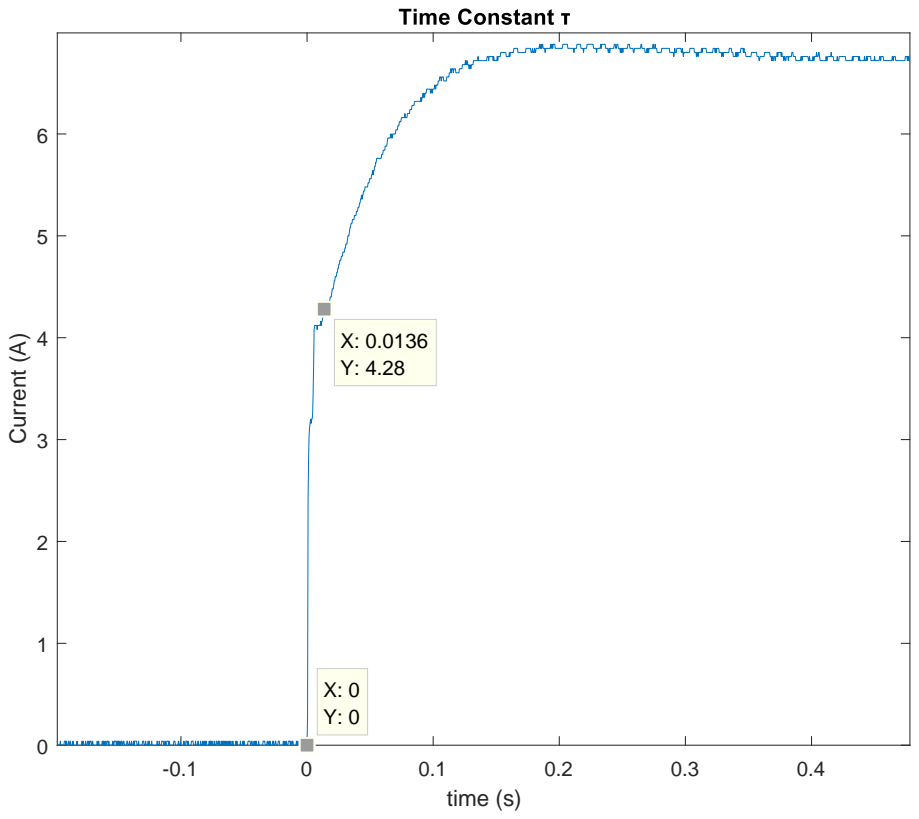
[picture p85: page 1]
time (s); Current (A)
