raphaelcasimir/kord-stk/Report/figures/appendix/Motor&GearTests/RmLmDataPlot-eps-converted-to.pdf

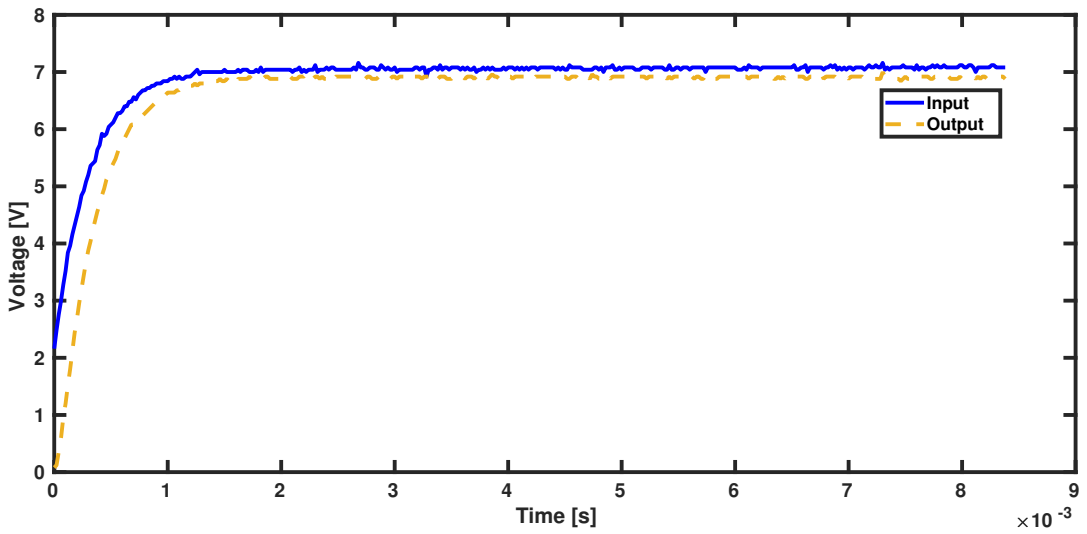
[picture p86: page 1]
Time [s]; Voltage [V]; Input Output
