raphaelcasimir/kord-stk/Report/figures/appendix/Motor&GearTests/RmLmFitPlot-eps-converted-to.pdf

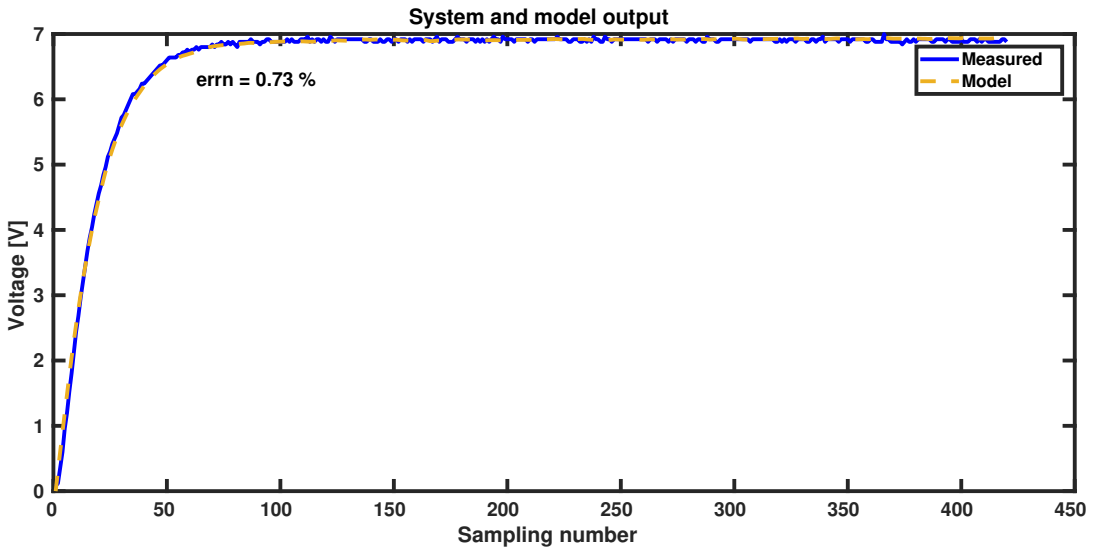
[picture p87: page 1]
Sampling number; Voltage [V]; errn = 0.73 %; Measured Model

System and model output
