raphaelcasimir/kord-stk/Report/matrix_hw_GR633.pdf

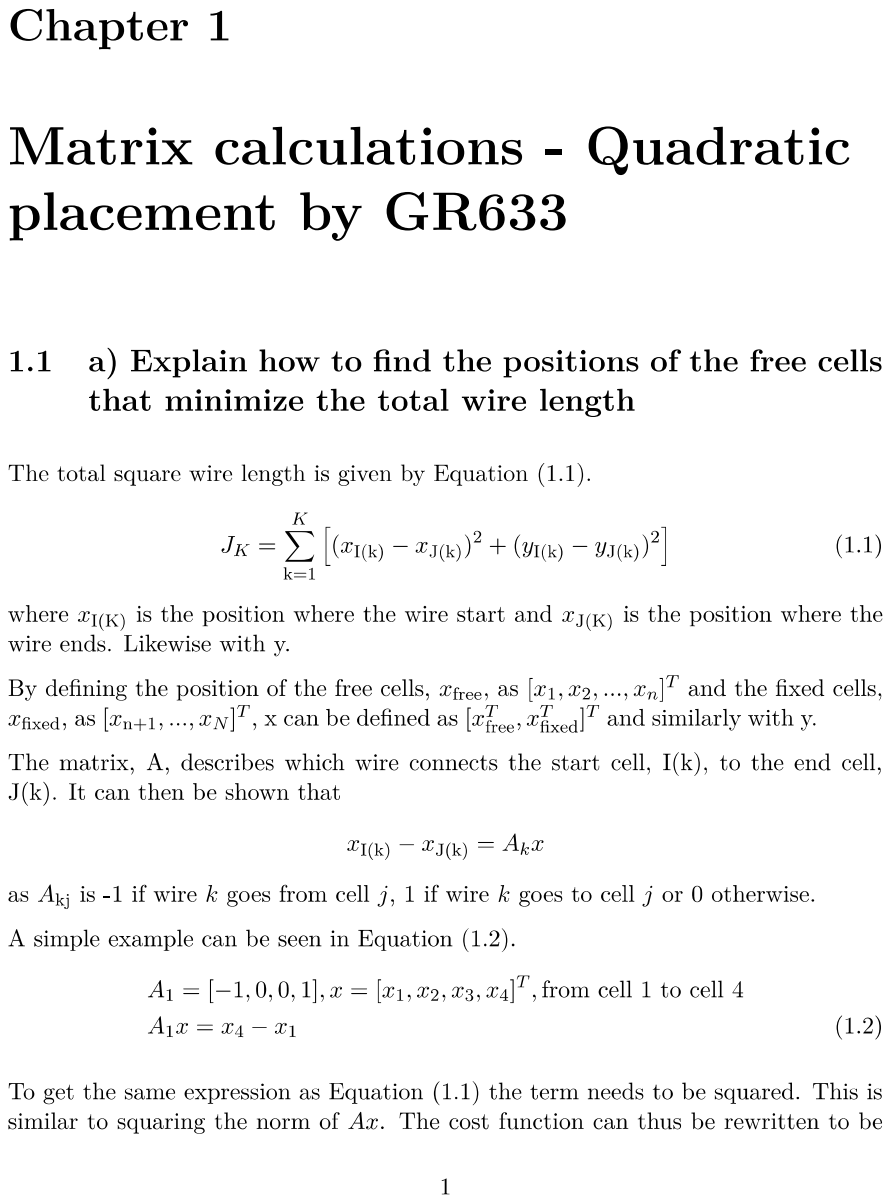
[picture p88: page 1]

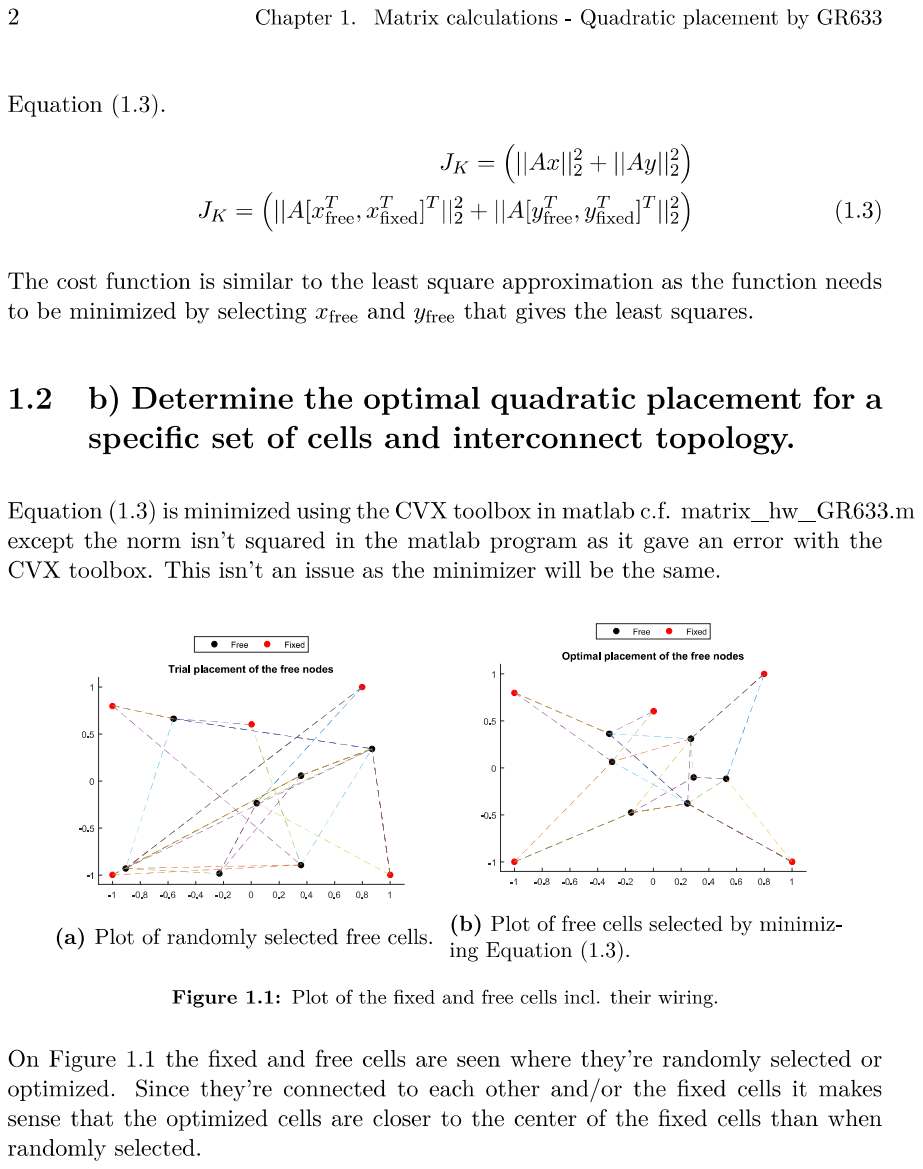
[picture p89: page 2]
