raphaelcasimir/kord-stk/Rocket/Rocket PCB schematics/Electric_Igniter.pdf

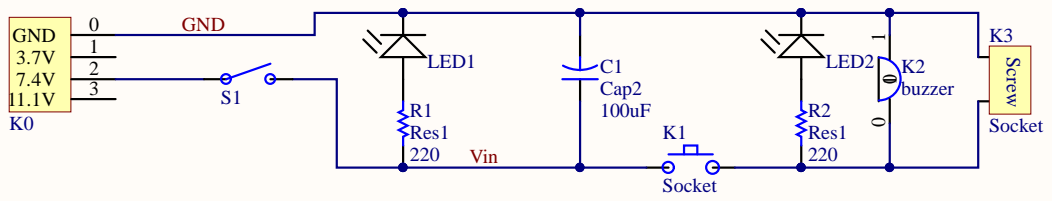
[picture p90: page 1]

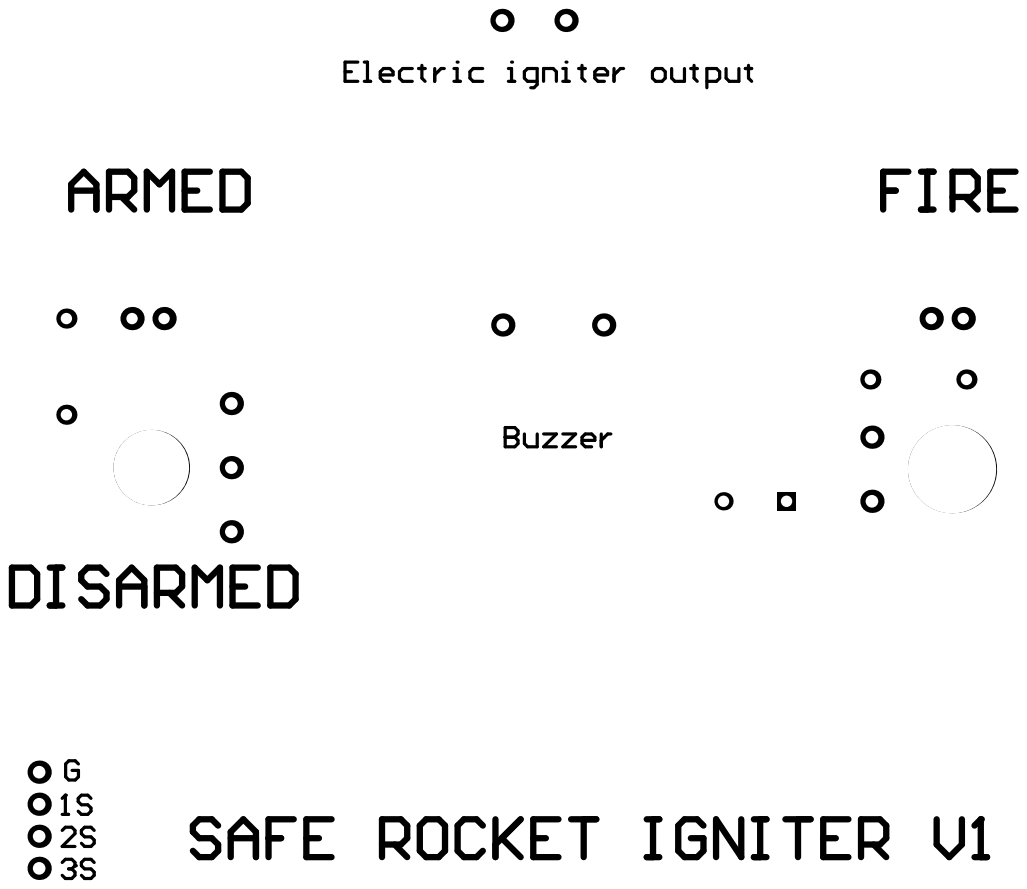
[picture p91: page 2]

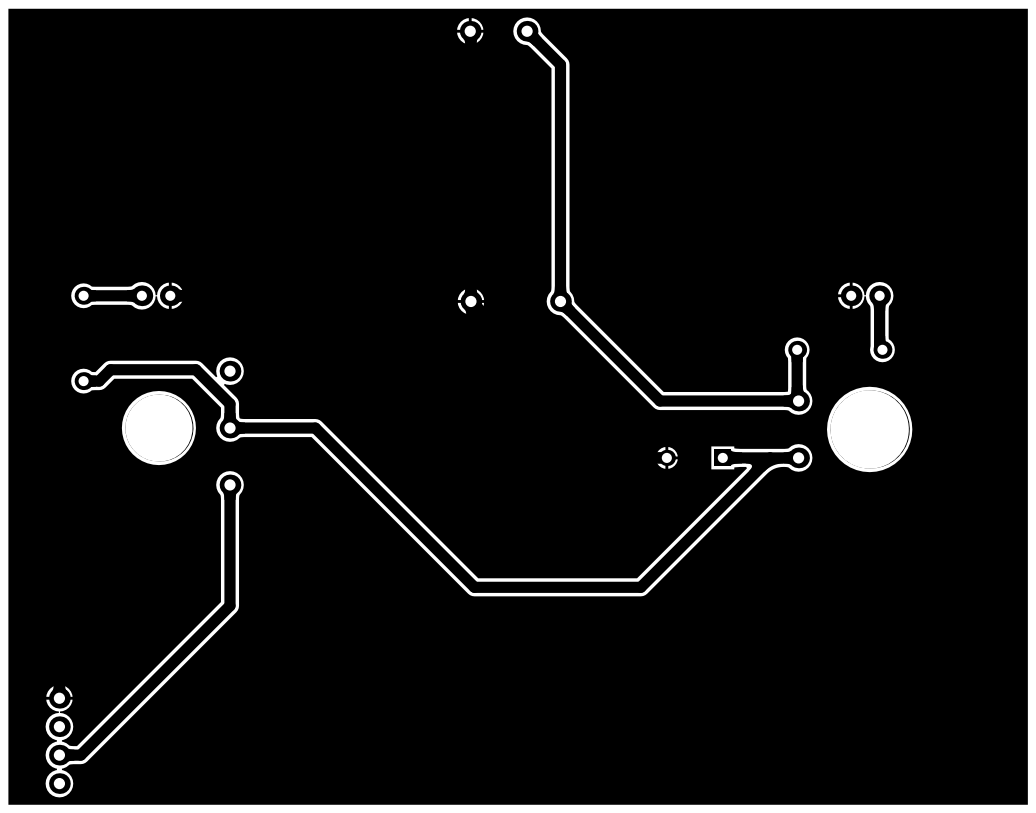
[picture p92: page 3]
