raphaelcasimir/kord-stk/Rocket/Rocket PCB schematics/Rocket_Logic_Board.pdf

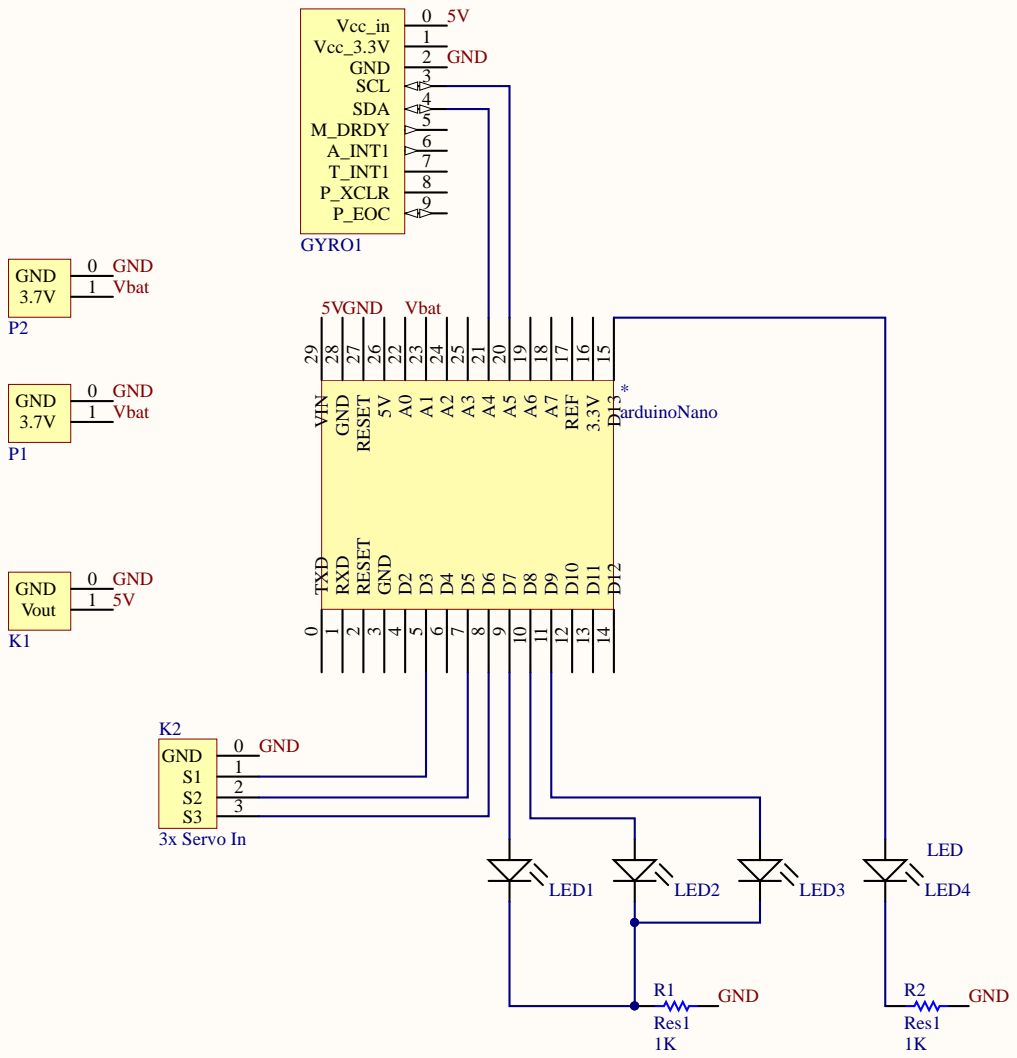
[picture p93: page 1]

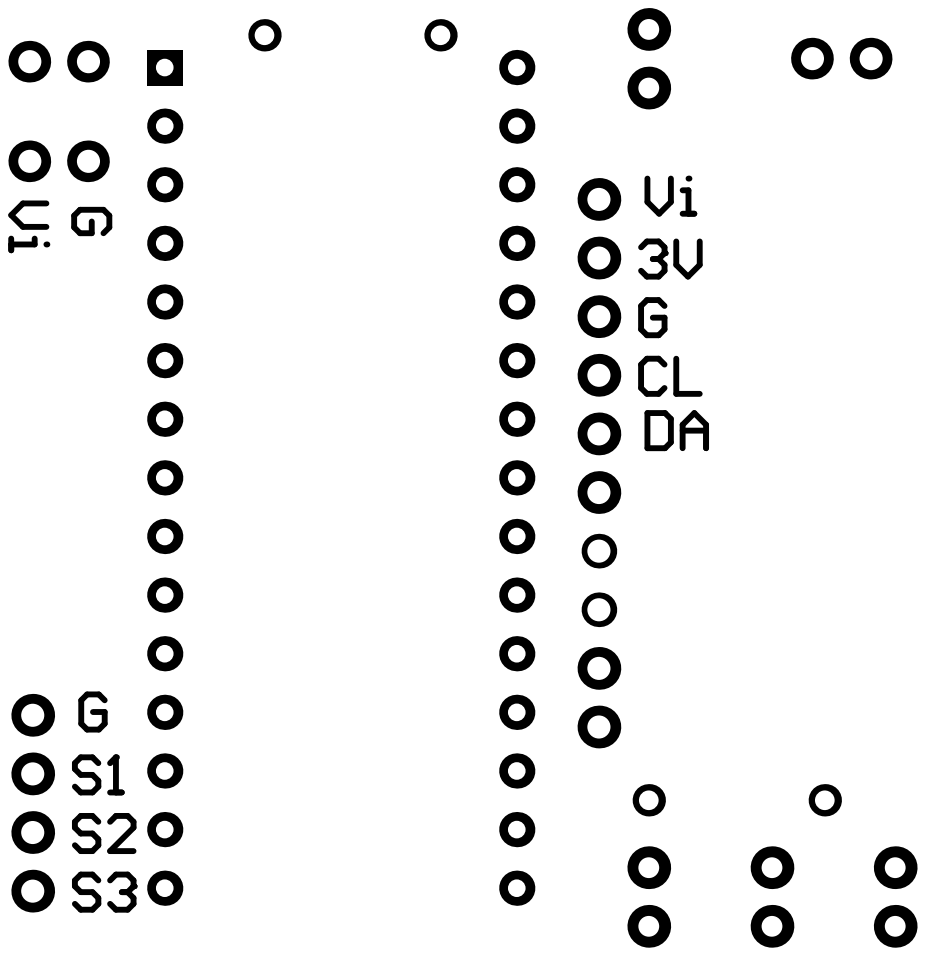
[picture p94: page 2]

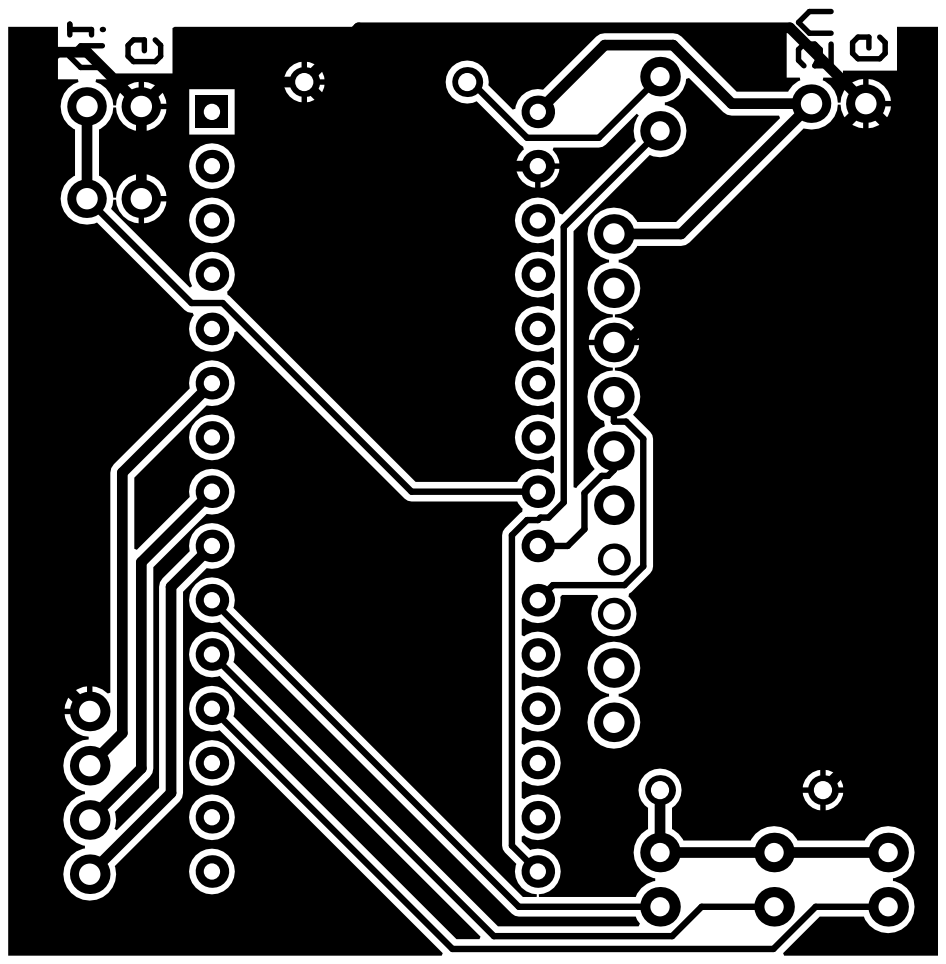
[picture p95: page 3]
