raphaelcasimir/kord-stk/Rocket/Rocket PCB schematics/Rocket_PSU_board.pdf

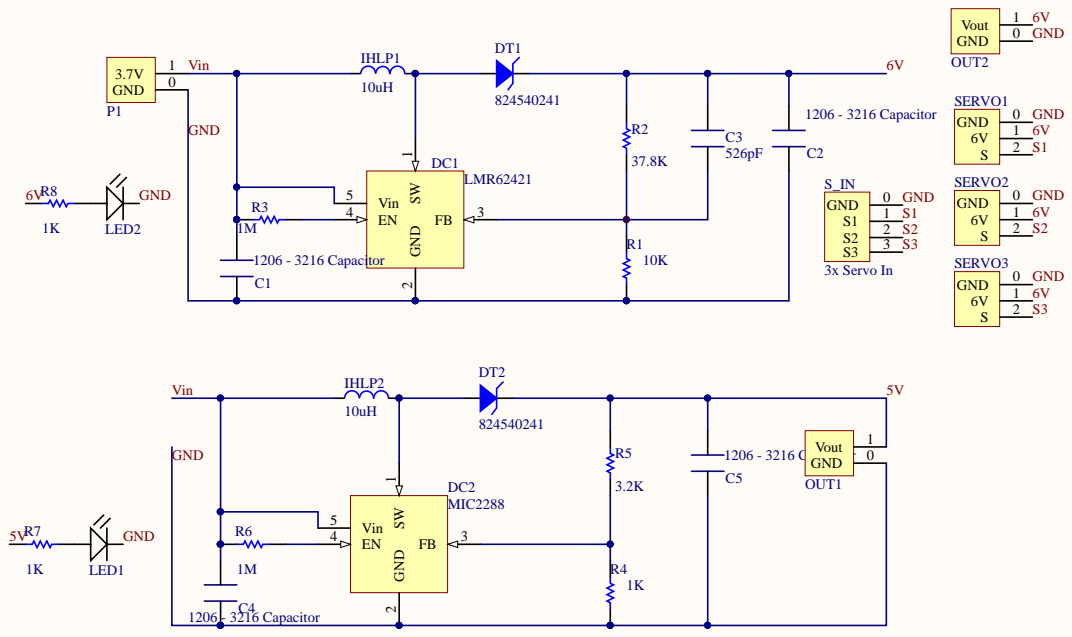
[picture p96: page 1]

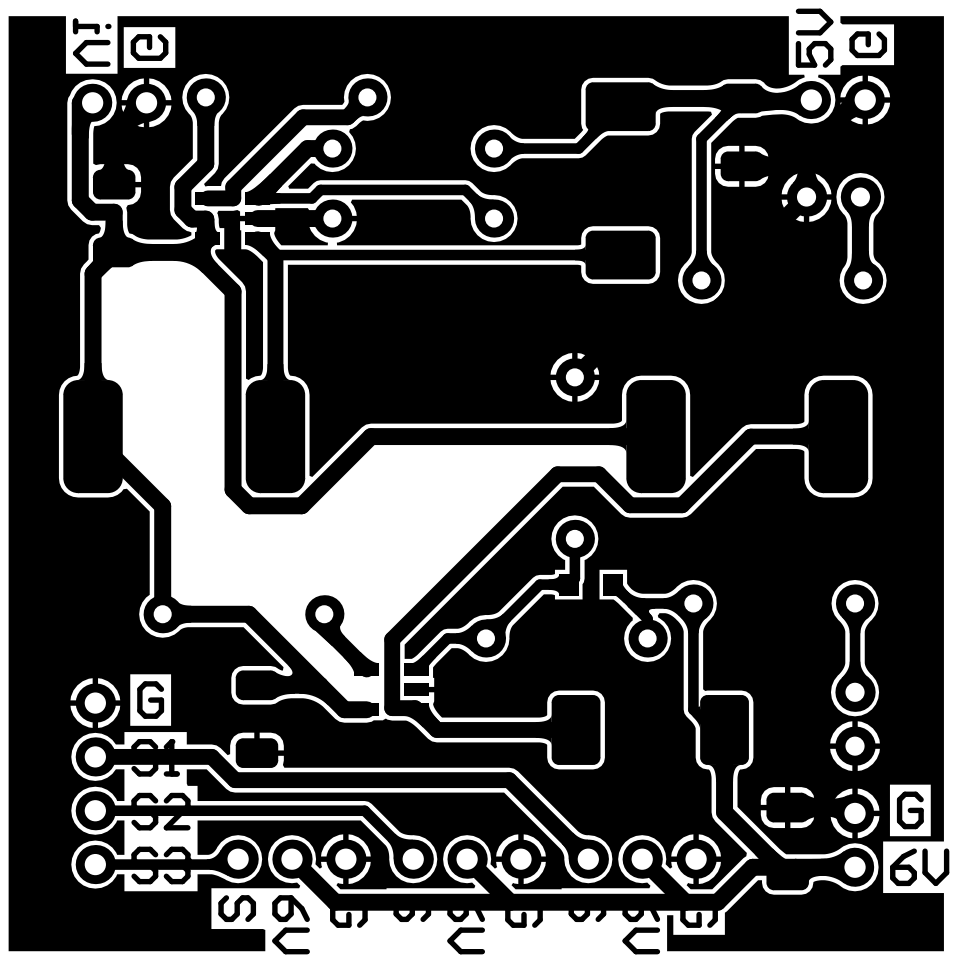
[picture p97: page 2]

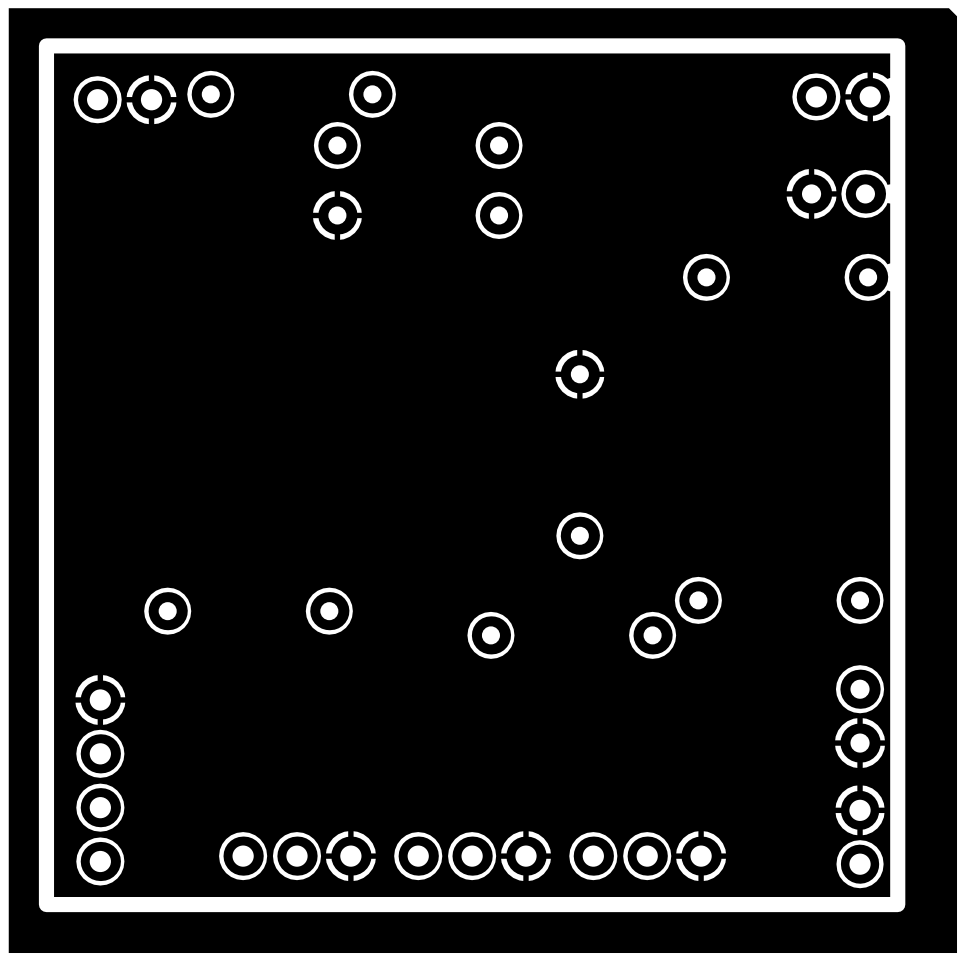
[picture p98: page 3]
