raphaelcasimir/kord-stk/Report/figures/appendix/PotentiometerPlotStick.pdf

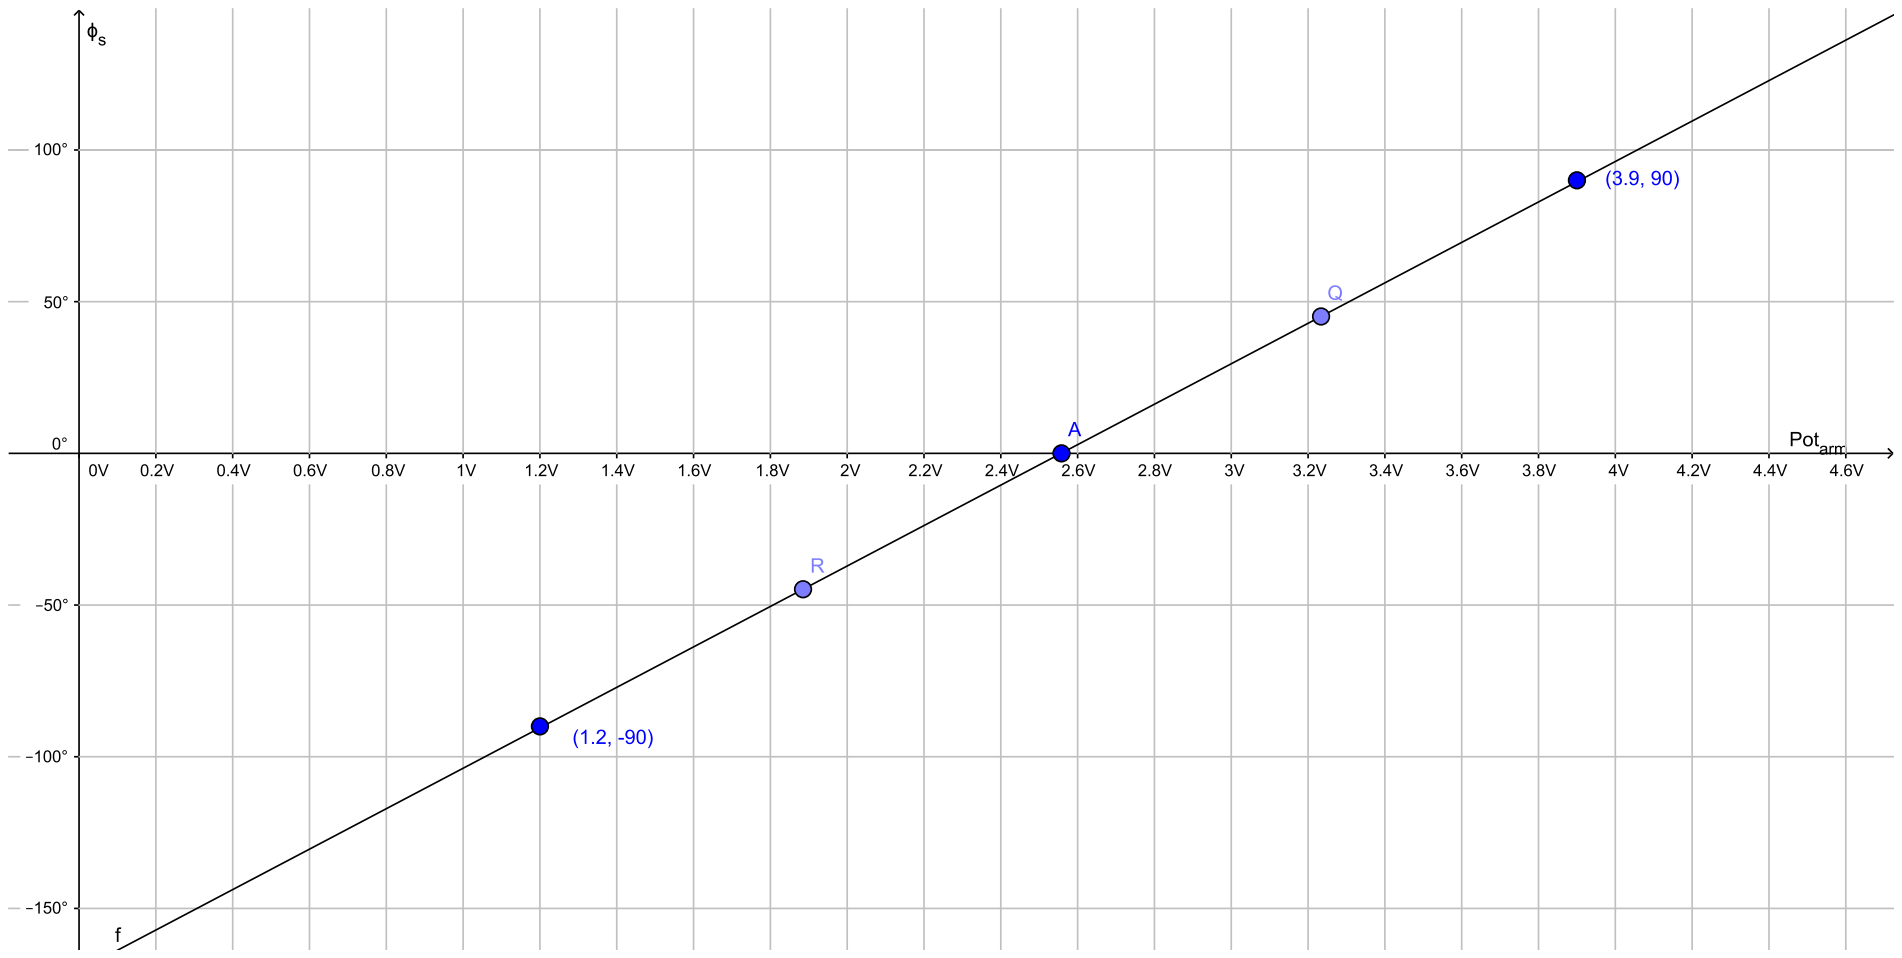
[picture p99: page 1]
