raphaelcasimir/kord-stk/Report/figures/appendix/PotentiometerPlot.pdf

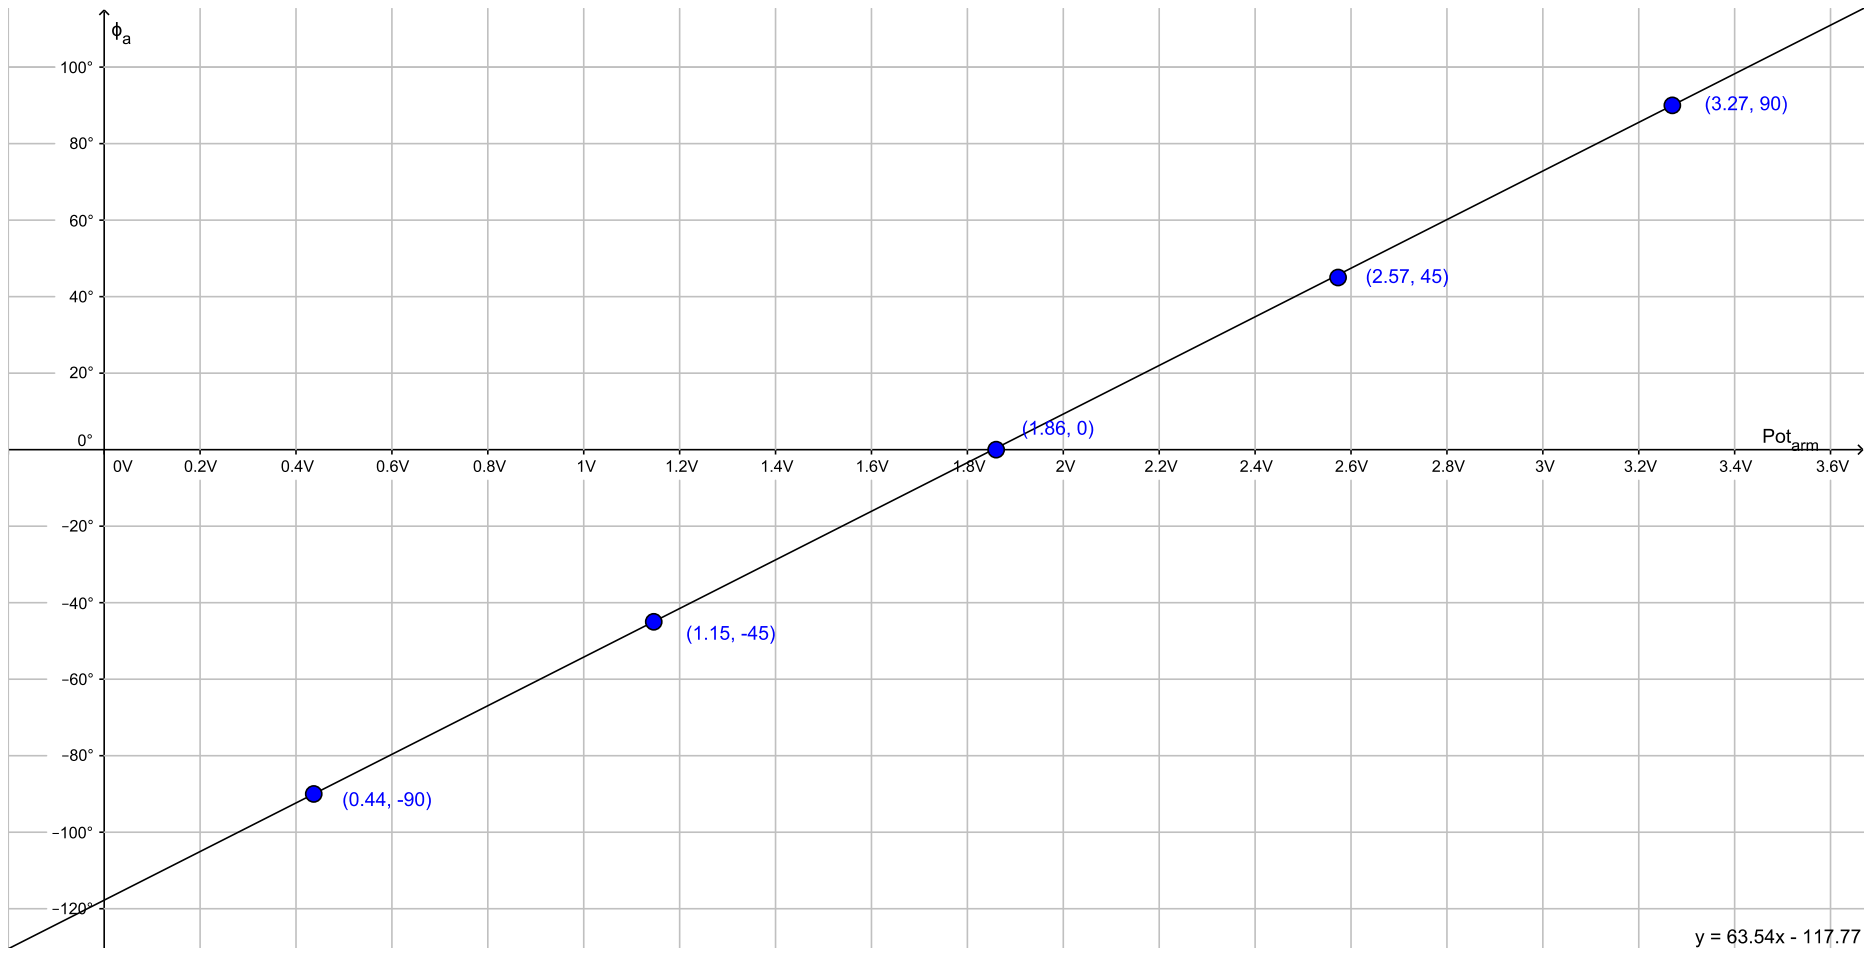
[picture p100: page 1]
