raphaelcasimir/kord-stk/Report/figures/modeling/gearTrain/GearAndBeltSystem.pdf

+

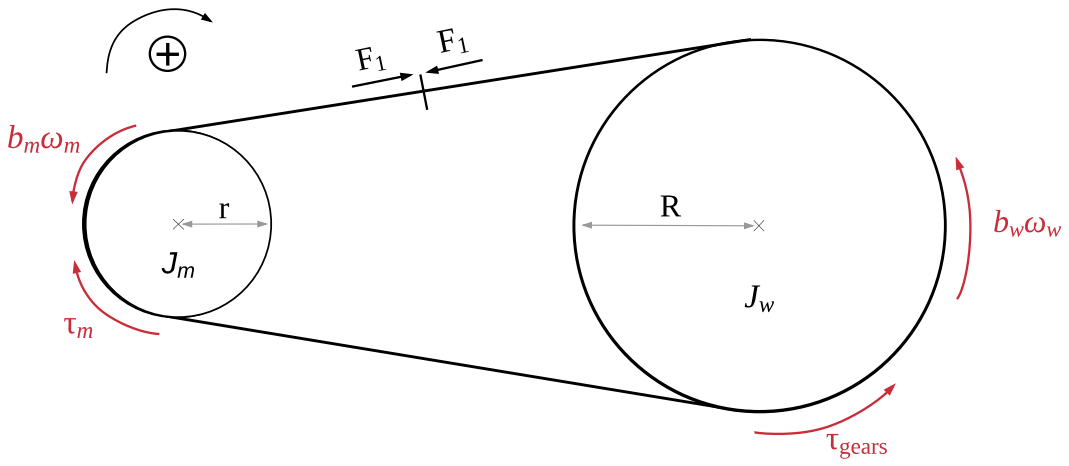
[picture p101: page 1]
?g ear
