raphaelcasimir/kord-stk/Report/figures/modeling/gearTrain/InputOutputGear.pdf

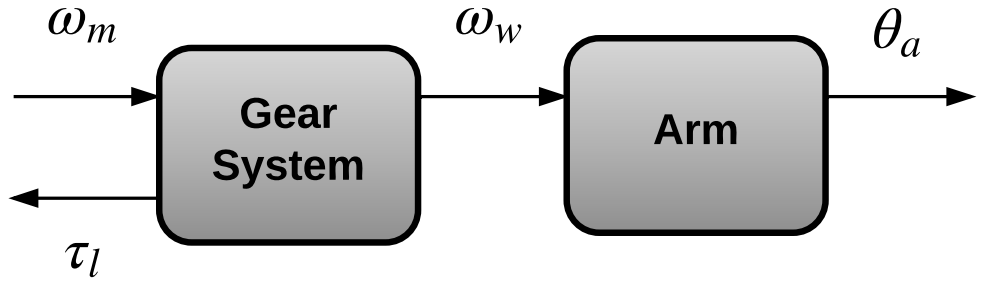
[picture p102: page 1]
