raphaelcasimir/kord-stk/Report/figures/Rocket/design/BlockRocket.pdf

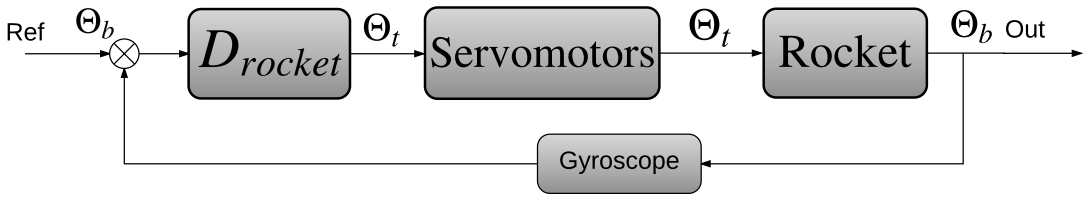
[picture p103: page 1]
