raphaelcasimir/kord-stk/Report/figures/Rocket/design/FinalBlockRocket.pdf

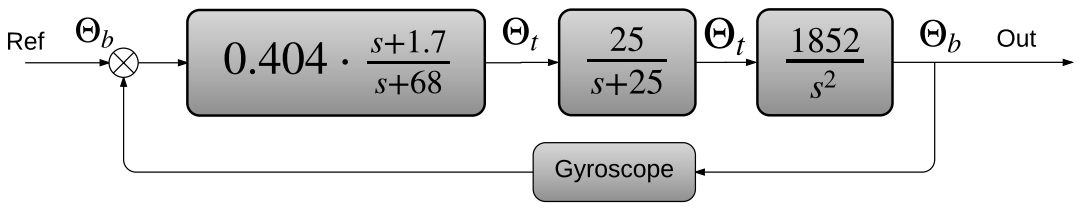
[picture p104: page 1]
