raphaelcasimir/kord-stk/Report/figures/Design/IPController/FinalBlockControllers.pdf

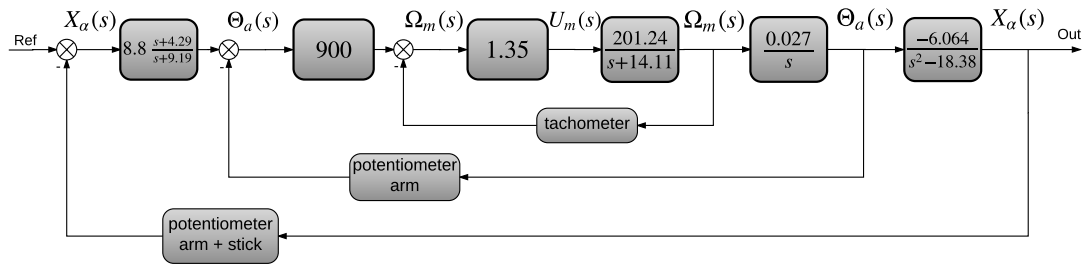
[picture p105: page 1]
tio; tic
