raphaelcasimir/kord-stk/Report/figures/Design/IPController/IPCascadeEnhanced.pdf

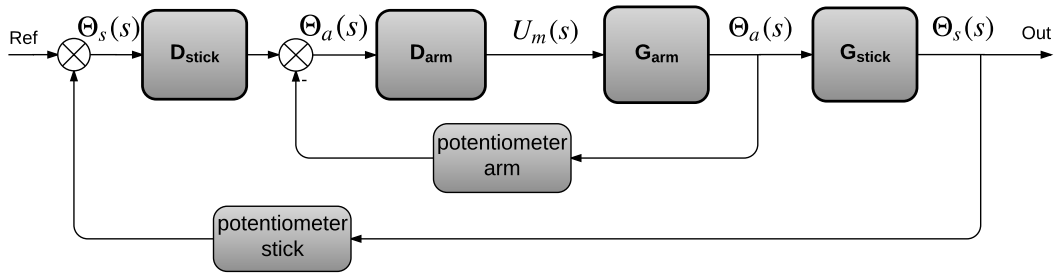
[picture p106: page 1]
tio; tic
