raphaelcasimir/kord-stk/Report/figures/Design/IPController/ModelDistAlpha.pdf

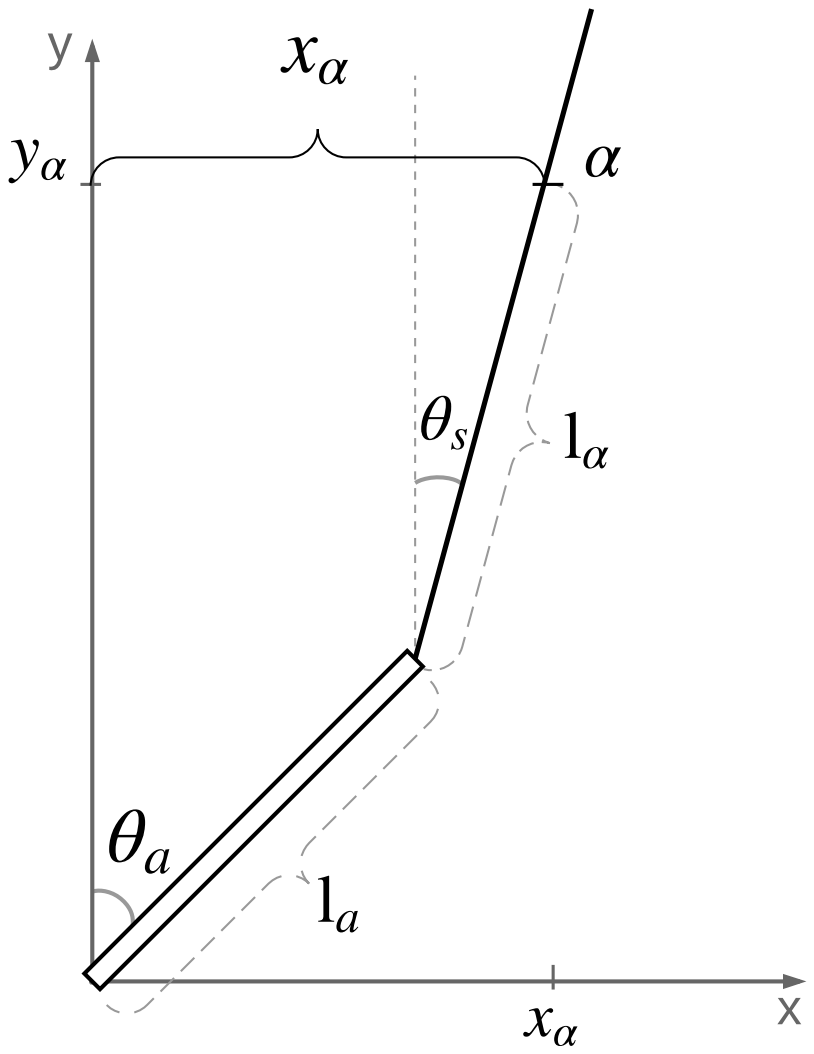
[picture p107: page 1]
