raphaelcasimir/kord-stk/Report/figures/modeling/ArmStick/StickAndForces.pdf

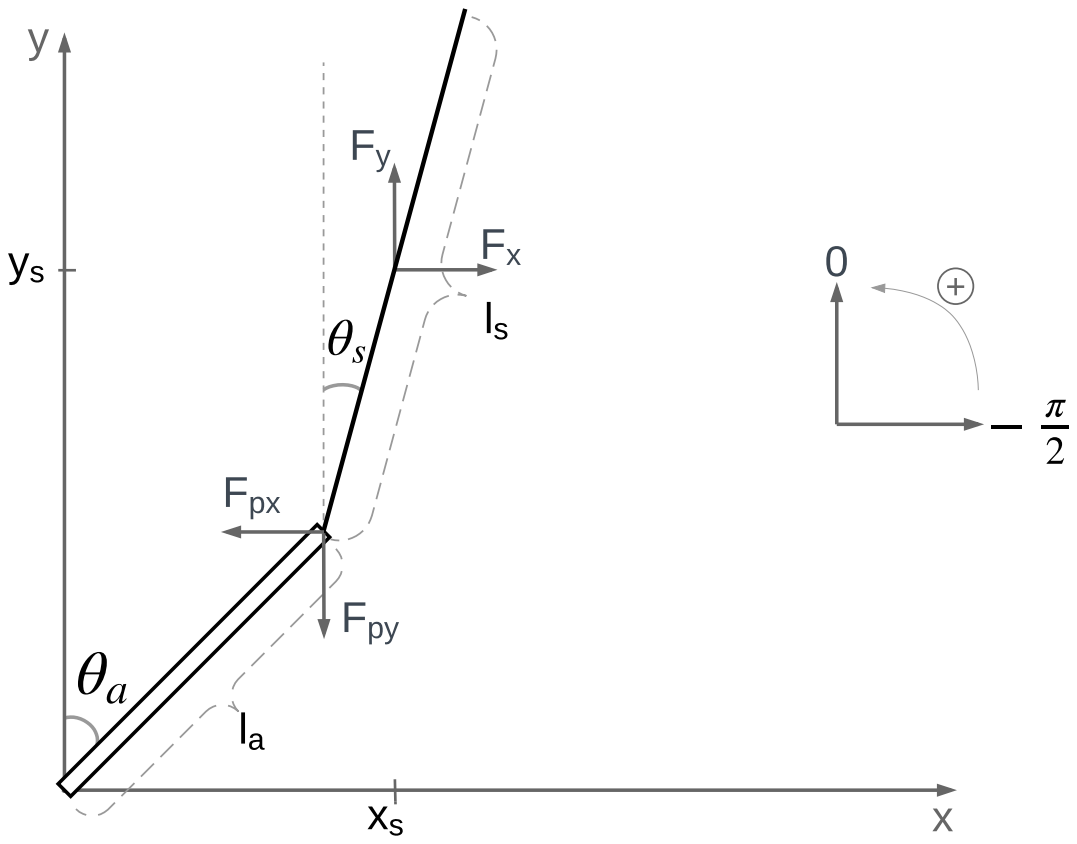
[picture p108: page 1]
