raphaelcasimir/kord-stk/Report/figures/Design/MotorLoop/MotorStepUncontrolled.pdf

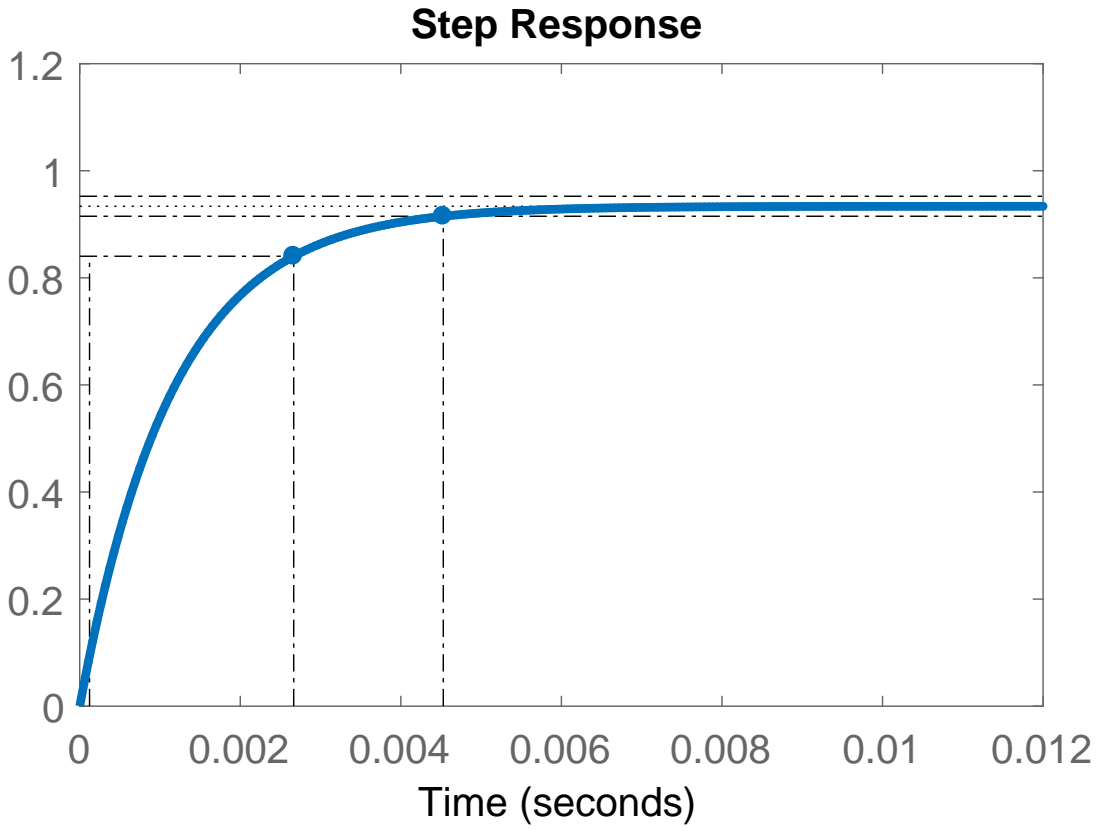
[picture p109: page 1]
Step Response; Time (seconds)
