raphaelcasimir/kord-stk/Report/figures/Design/IPController/ModelWithTF.pdf

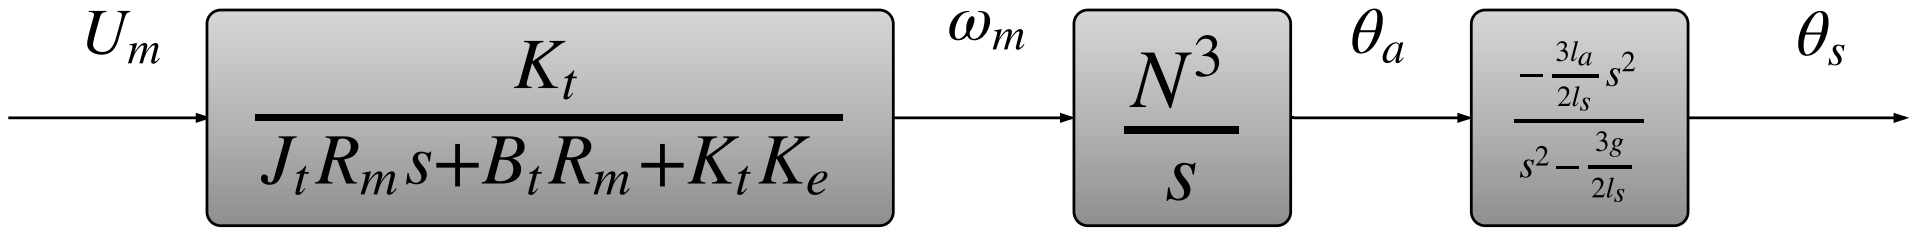
[picture p110: page 1]
