raphaelcasimir/kord-stk/Report/figures/modeling/ArmStick/InputOutputStick.pdf

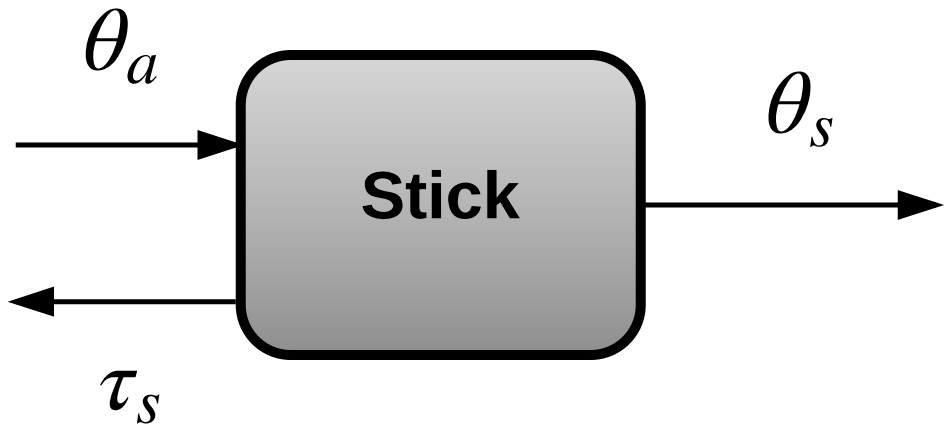
[picture p111: page 1]
Stick
