raphaelcasimir/kord-stk/Report/figures/modeling/gearTrain/loadOnThetaA.pdf

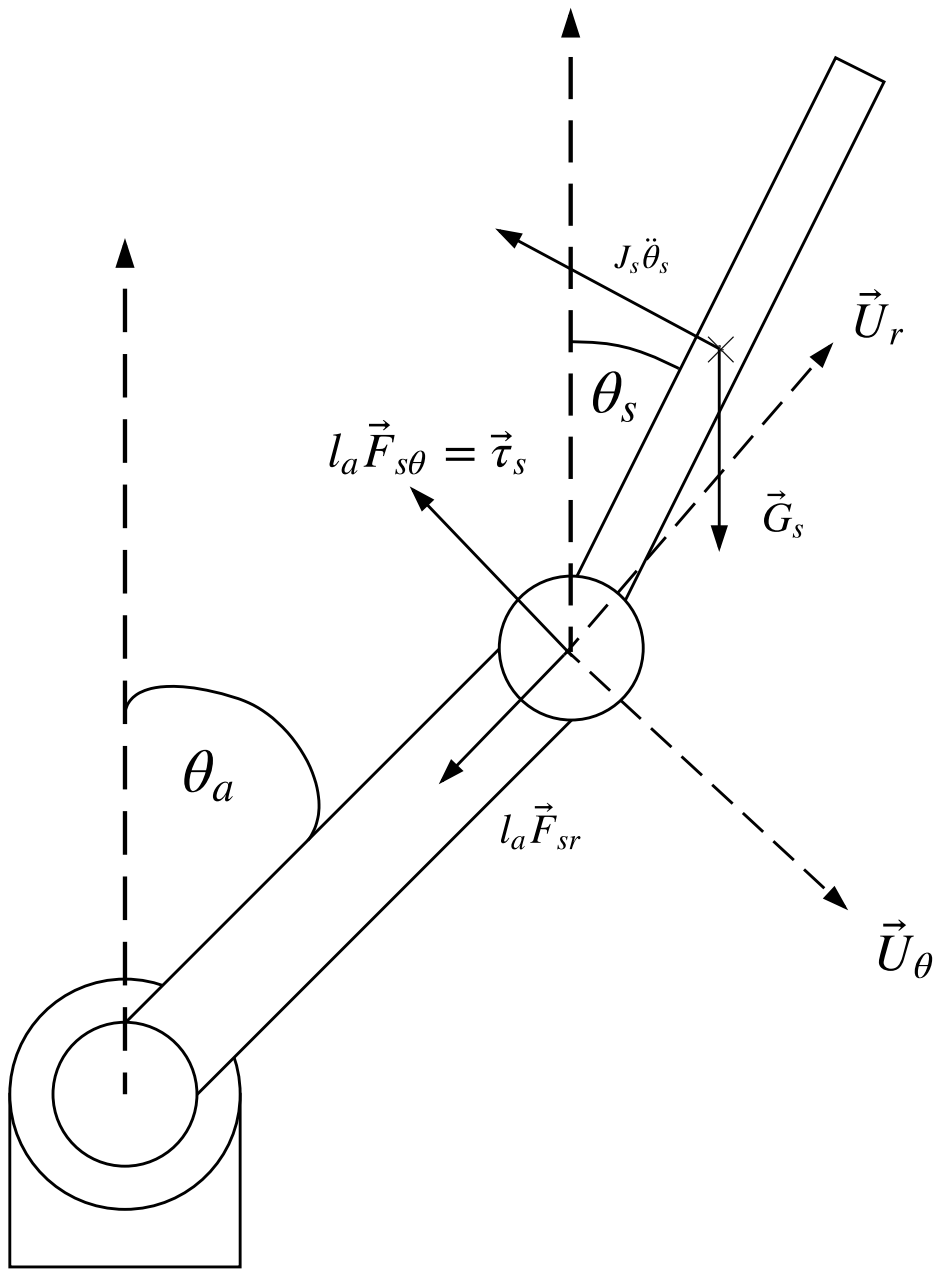
[picture p112: page 1]
