raphaelcasimir/kord-stk/Report/figures/appendix/Motor&GearTests/LmDiagram.pdf

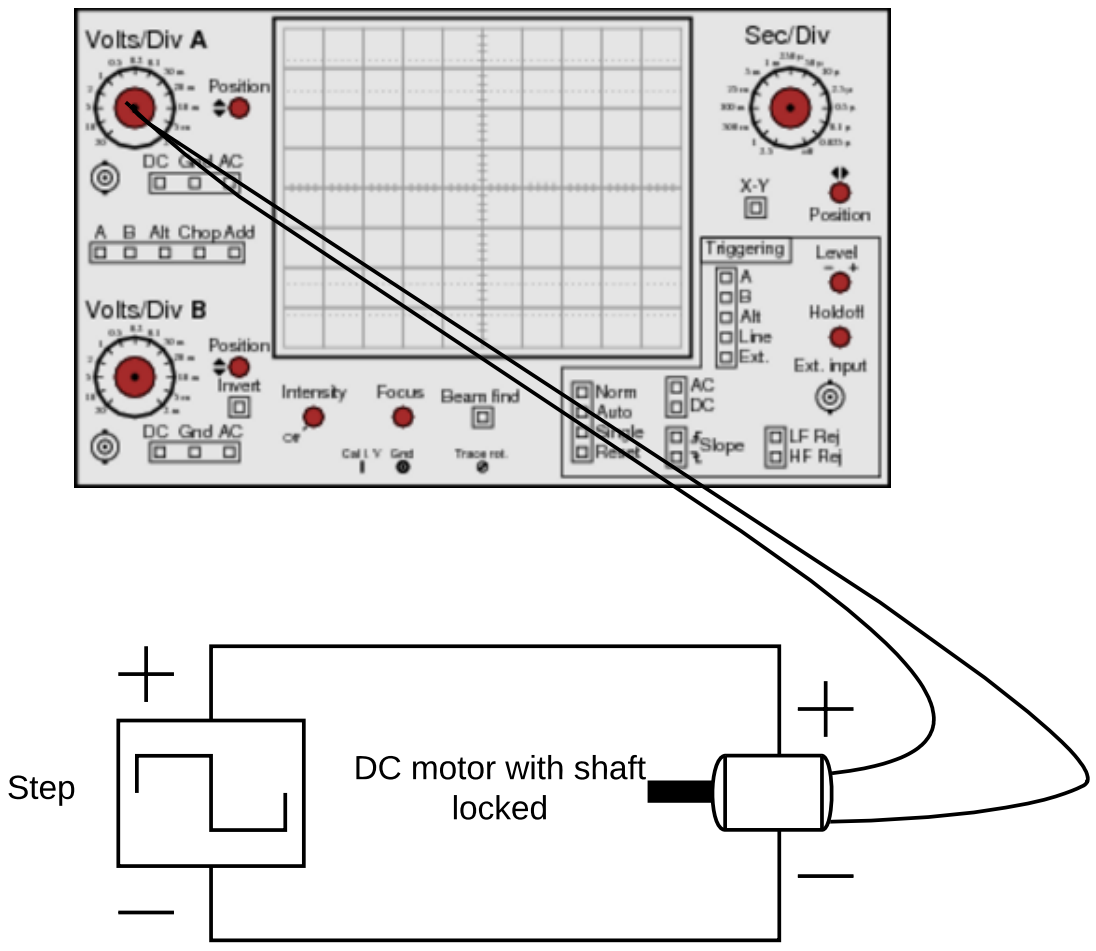
[picture p113: page 1]
wit; t locked
