raphaelcasimir/kord-stk/Report/figures/appendix/Motor&GearTests/BmTestSetUp.pdf

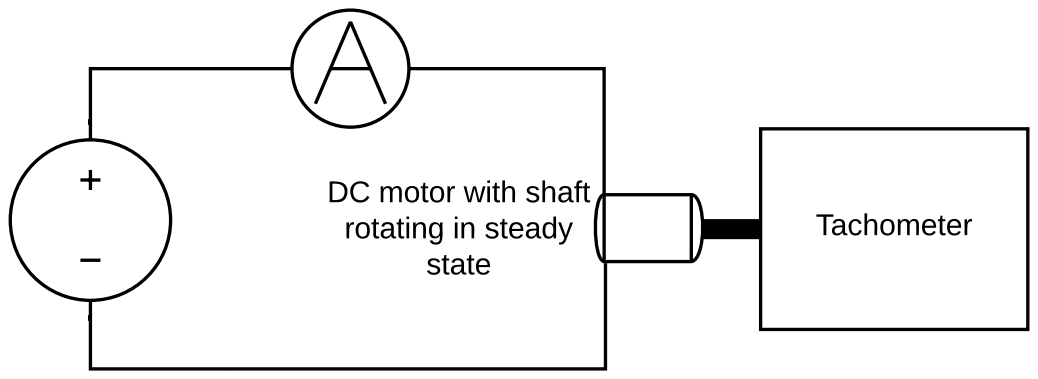
[picture p114: page 1]
wit; tin
