raphaelcasimir/kord-stk/Report/figures/appendix/Motor&GearTests/KeTestSetUp.pdf

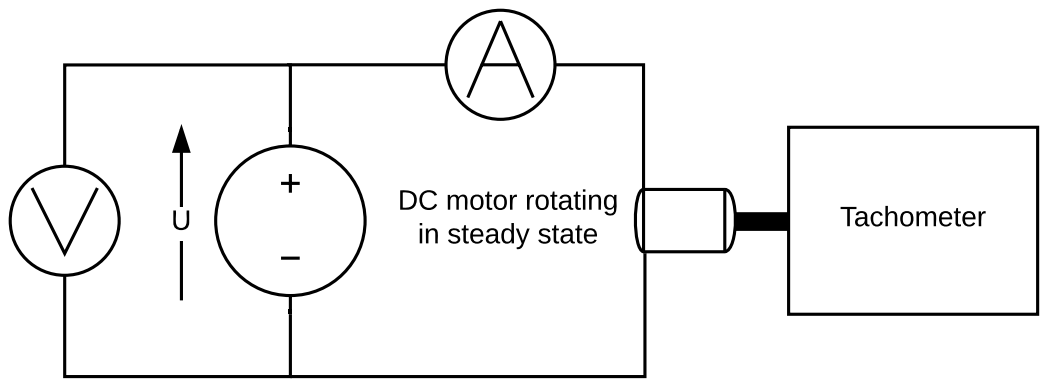
[picture p115: page 1]
tin

g in steady state
