raphaelcasimir/kord-stk/Report/figures/appendix/Motor&GearTests/KtTestSetUp.pdf

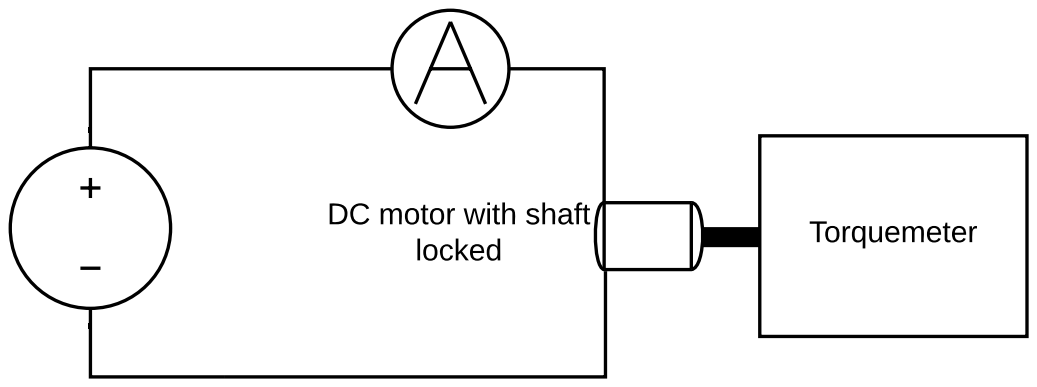
[picture p116: page 1]
wit; t locked
