raphaelcasimir/kord-stk/Report/figures/modeling/gearTrain/PendulumWithWeightlessRod.pdf

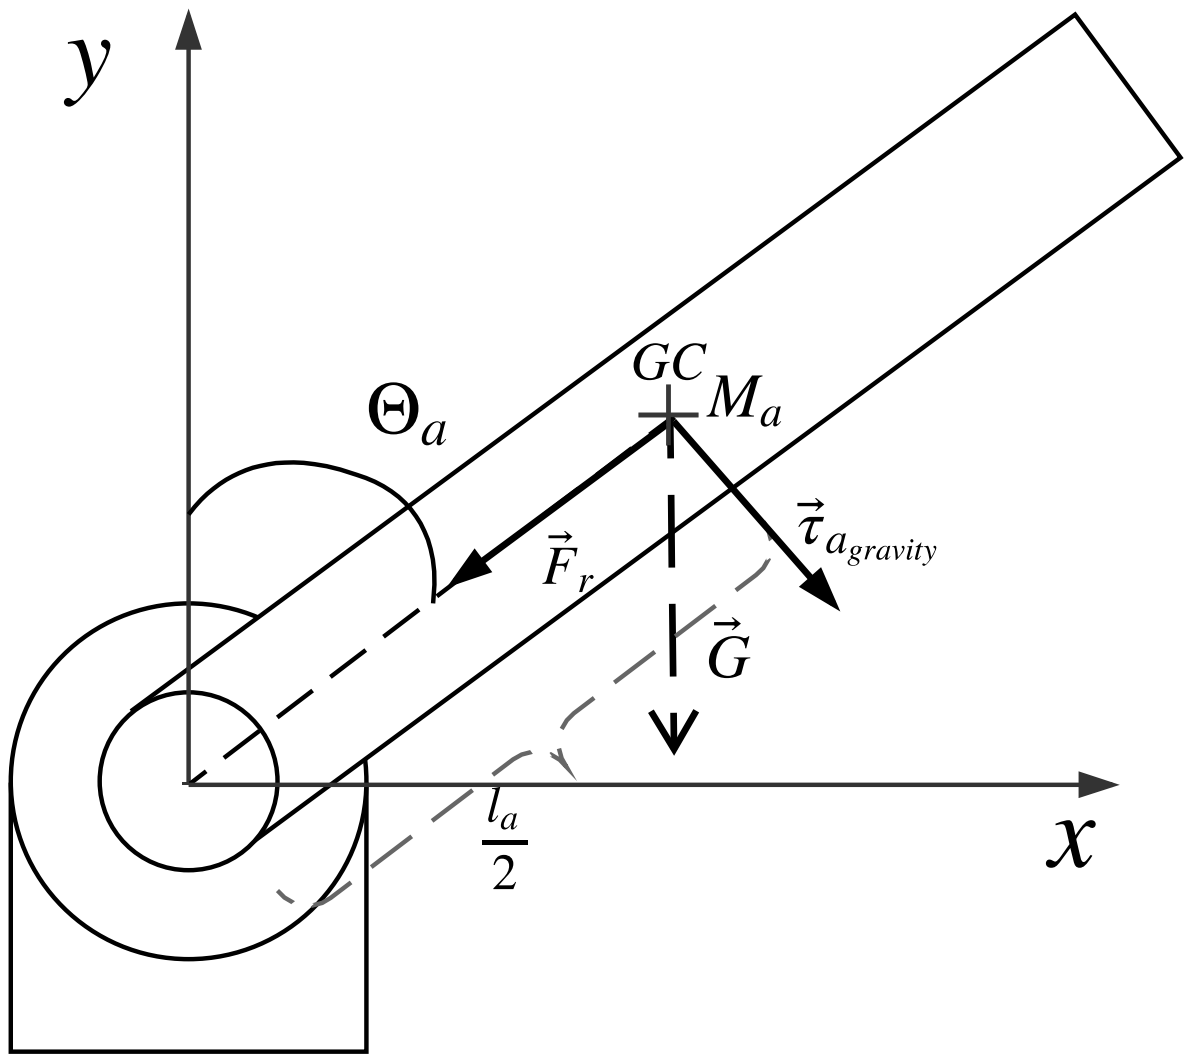
[picture p117: page 1]
