raphaelcasimir/kord-stk/Report/figures/modeling/Motor/MotorElectricCircuit.pdf

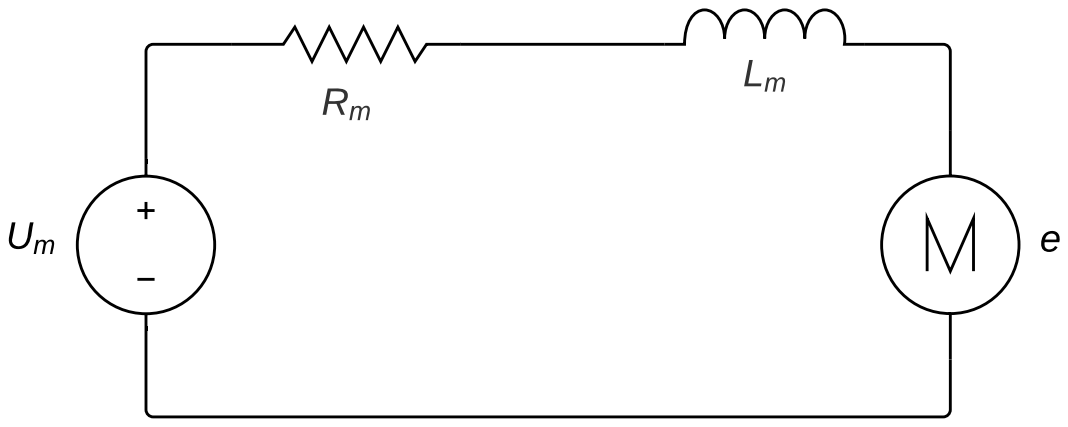
[picture p118: page 1]
