raphaelcasimir/kord-stk/Report/figures/modeling/gearTrain/CosSinLinApprox-eps-converted-to.pdf

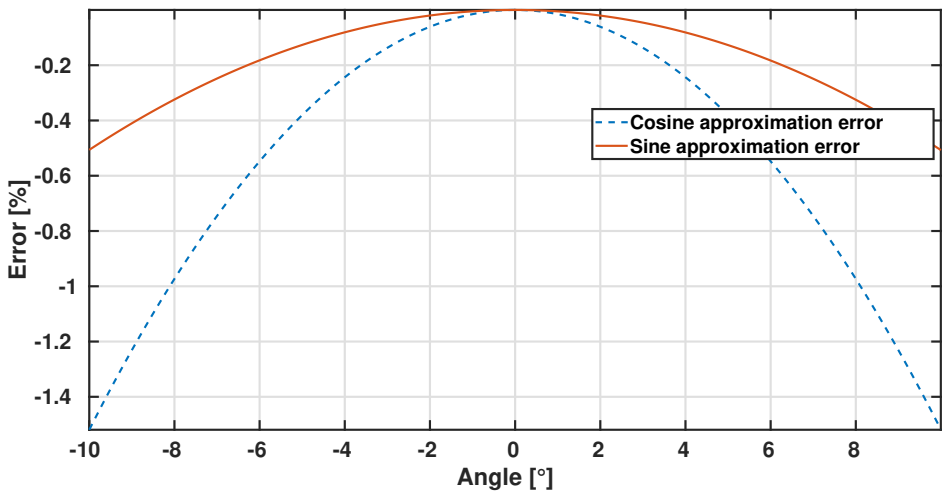
[picture p119: page 1]
Angle [°]; Error [%]

Cosine approximation error
Sine approximation error
