raphaelcasimir/kord-stk/Inverted Pendulum Controller Code/FinalInvertedPendulumController/FinalInvertedPendulumController.ino

#include "TimerOne.h"

//PINS
#define PWM_PIN 9
#define ENABLE_PIN 7
#define POTMETERARM A0
#define POTMETERSTICK A1
#define VELOCITY_INPUT A4
#define Digit 6

//Physical values
#define La 0.33
#define Lalpha 0.533 //0.8 stick 0.533 | 0.4 stick 0.267
//Conversion value
#define analog2digit (1/204.8)

#define deg2rad (31.415926 / 1800.0)

#define curr0 512
#define volt2amp 1.0
#define amp2pwm (409.6/11.0)

#define vel0 2.5
#define volt2rpm (3000.0/1.5)
#define rpm2radSec (31.415926/300)

//Mapping value
//These values by were found by curve fitting on geogebra
#define mappingSlopeArm (63.11/204.8)
#define mappingConstArm (117.0)

#define mappingSlopeStick (66.66/204.8)
#define mappingConstStick (150.92)

//Limits for safety
#define refArmMax 0.9
#define refArmMin -0.9

#define refCurrentMin (-11.0)
#define refCurrentMax (11.0)

#define setVelocityMin (-3000.0*rpm2radSec)
#define setVelocityMax (3000.0*rpm2radSec)

// Time constant
#define sampleTime 2.0 //in milli seconds

//Controller characteristics
//Velocity controller
#define KpVel 10.0

//Arm controller
#define KpInner -900.0

//Stick controller
#define gO -8.8	//nice value 0.8 stick -8.85 	| 	0.4 stick -6.8
#define zO 4.29		//nice value 0.8 stick 4.29 	| 	0.4 stick 6.06
#define pO 9.19		//nice value 0.8 stick 9.27 	| 	0.4 stick 11.06

//Analog reading of the potentiometer
double posStick=0, posArm=0;

//Actual interesting value of the stick and the arm
double distStick, angleArm ,angleStick, velocity=0;
double lastDistStick=0, lastAngleArm=0, lastRefArm=0;

//Set point for the controllers
double setPointDist=0, refArm=0, setVelocity=0, refCurrent=0;

//Value of the controllers
double errorArm=0,		errorDist=0;
double errorVelocity=0;

//PWM signal
int PWM;

void setup()
{
  noInterrupts();
  // setup timerOne, we use this library to get 10bit resolution for PWM.
  Timer1.initialize(200);
  Timer1.stop();        //stop the counter
  Timer1.restart();     //set the clock to zero
  Timer1.pwm(PWM_PIN, 512, 200);

  //PINMODE
  pinMode(PWM_PIN, OUTPUT);
  pinMode(ENABLE_PIN, OUTPUT);
  pinMode(Digit, OUTPUT);

  //Enable ESCON driver
  digitalWrite(ENABLE_PIN, LOW);  // disable ESCON to clear any errors
  delay(2000);
  digitalWrite(ENABLE_PIN, HIGH);  // enable ESCON

  //Serial intialization
  Serial.begin(57600);
  
  //Interrupts start
  interrupts();
}

void calcPID()
{
	// Outer loop controller first
	// Compute error values
	errorDist = setPointDist - distStick;
	
	refArm = gO*(2*1000/sampleTime+zO)/(2*1000/sampleTime+pO)*errorDist + gO*(zO-2*1000/sampleTime)/(2*1000/sampleTime+pO)*lastDistStick - (pO-2*1000/sampleTime)/(2*1000/sampleTime+pO)*lastRefArm;
	
	if(refArm > refArmMax) refArm = refArmMax;
	else if(refArm < refArmMin) refArm = refArmMin;

	// Update previous values
	lastDistStick = errorDist;
	lastRefArm = refArm;
	

	// Inner loop controller
	// Compute error values
	errorArm = refArm - angleArm;
	
	//Compute output
	setVelocity = KpInner * errorArm;
	if(setVelocity > setVelocityMax) setVelocity = setVelocityMax;
	else if(setVelocity < setVelocityMin) setVelocity = setVelocityMin;

	//	Velocity loop
	errorVelocity=setVelocity-velocity;

	//Compute output
	refCurrent=errorVelocity*KpVel;//+dVelocity*KdVel;
	if(refCurrent > refCurrentMax) refCurrent = refCurrentMax;
	else if(refCurrent < refCurrentMin) refCurrent = refCurrentMin;

	//Calculate and set output PWM
	PWM = round(curr0 + refCurrent*amp2pwm); // 0.82 motor resistance and PWM sets current.
	Timer1.setPwmDuty(PWM_PIN,PWM);
}

//Functions to simplify the program
void actualizeFeedbackValue(){
	//Actual angular velocity of the motor
	velocity=((analogRead(VELOCITY_INPUT))*analog2digit-2.5)*volt2rpm*rpm2radSec;

	//Actual position of the arm and the stick
	posArm=analogRead(POTMETERARM); // 
	posStick=analogRead(POTMETERSTICK); // 

	//Mapping the value of the potentiometer to physical value (stick distance and arm angle)
	angleArm = (mappingSlopeArm*posArm-mappingConstArm)*deg2rad;
	angleStick = (mappingSlopeStick*posStick-mappingConstStick)*deg2rad;
	//angle stick relative to the arm so change to it to correspond of the upright angle
	angleStick = angleArm+angleStick;

	// Distance for the stick
	distStick =sin(angleArm)*La+sin(angleStick)*Lalpha;
}


bool test=true;
double previous=0;
double prevCont=0;
void loop()
{
	double now=millis();
	digitalWrite(Digit, HIGH);
	actualizeFeedbackValue();
	
	calcPID();
	
	digitalWrite(Digit,LOW);
	while ((prevCont + sampleTime) > millis())
  	{} // wait
  	prevCont = millis();
}



// Arm Test
// into the void loop before calcPID
	//to check if it moves
	//to check if it moves
	/*if (now-previous>=10000){
		if (test==true) refArm=0.4;
		else refArm=-0.4;
		test=!test;
		previous=now;
	}*/
