raphaelcasimir/kord-stk/(commit log)

2017-02-16 Corrected small stuff in rocket stability switch back from \vref to \autoref because it is to repetitive
2017-02-16 Add the DC motor datasheet
2017-02-27 Arm and stick modeling
2017-02-28 Add the matlab script and the data to find the inductance of the DC motor
    [LaTest.CSV]
2017-03-02 Add the test journal for the Internal inductance of the DC motor test
2017-03-02 Add the DC motor datasheet in the references and once put the appendices in the report
2017-03-02 Edit the template for when you have a group of equations so please use it when such case occurs
2017-03-02 Motormodelling
    Motor modelling beginning
2017-03-06 DC Motor Modelling finished
2017-03-08 Just minor modifications
    [PRINT_03.CSV, PRINT_04.CSV]
2017-03-08 GearModelling step 1
2017-03-08 GearModelling Structure
2017-03-08 a for arm / s for stick becomes t for thruster and b for body
2017-03-08 Add the linearization part of the gear train and the beggining for finding Tau_as
2017-03-09 Progress in gear train modeling section
2017-03-10 Advancement in the modelling of the gear train
2017-03-13 Gear train modelling revised
2017-03-13 GearModelling revision 2.0
2017-03-13 dont know why i have a gearmodeling change
2017-03-13 Version 3.0 of gear modelling
2017-03-13 Add the unit at he end of some equations and corrected some mistakes so it only the 3.1 version of the gear modelling
2017-03-17 Motor Test Results
    [Motor Ra.xlsx]
2017-03-17 Prepared the test jounal for the gear train
    [PRINT_05.CSV]
2017-03-20 Flow-chartyyy it's your birthday, flow-chartyy know it your birthday
2017-03-20 Fixed K_e and new L_a plots
    [PRINT_06.CSV, PRINT_07.CSV, PRINT_08.CSV, PRINT_09.CSV, PRINT_10.CSV]
2017-03-21 start gyro
2017-03-22 Waiting for motor test results
2017-03-23 Tests & stuff
    [PRINT_11(J_test).CSV]
2017-03-27 SOme measurement for the gear train's moment of inertia
    [JgInput.csv, JgOutput.csv]
2017-03-27 more test results
    [PRINT_00.CSV]
2017-03-27 (ノಠ益ಠ)ノ彡┻━┻
    [JgInput.csv, JgOutputSetToZero.csv]
2017-03-28 Re Rm and stuff
    [LmRmTestLong.csv, LmRmTestShort.csv, LmRmTestShortInput.csv]
2017-03-28 Retest Rm because weird values
    [LmRmTestShort2.csv, LmRmTestShortInput2.csv]
2017-03-30 Data from motor+gear tests
    [F0000CH1.CSV, F0001CH1.CSV, F0002CH1.CSV, Jm100msInput.CSV, Jm100msInputTEST.csv, Jm100msOutput.CSV, Jm100msOutputTEST.csv, JmInput.CSV]
2017-04-01 Some measurements fo the gear friction test
    [BgearFinalTest.csv, BgearFinalTestInput.csv]
2017-04-01 Tests, tests and tests
    [NewJmInput.CSV, NewJmOutput.CSV]
2017-04-01 (┛◉Д◉)┛彡┻━┻
    [BgearFinalTest.csv, BgearFinalTestInput.csv]
2017-04-03 New tests results *table flip*
    [Motor Ra (New tests).xlsb.xlsx]
2017-04-03 New Results Ke
    [Motor Ra (New tests).xlsb.xlsx]
2017-04-03 Test journal for DC motor almost done
2017-04-03 New Bm & Kt
    [Motor Ra (New tests).xlsb.xlsx]
2017-04-03 Hopefully the last motor tests
    [Motor Ra (New tests).xlsb.xlsx]
2017-04-04 The transfer function for motor gear train is done
2017-04-04 Updated DC motor values
    [Motor Ra (New tests).xlsb.xlsx]
2017-04-04 Just to receive the value for the DC motor
2017-04-04 Motor&Gears Test journal done (missing B_gears though)
    [Motor Ra (New tests).xlsb.xlsx]
2017-04-06 things and stuffs
    [Motor Ra (New tests).xlsb.xlsx]
2017-04-10 New Values: Rm = 0.82 Lm = 1.02E-2 Ke = 0.0366
    [AmpInputCurrent.CSV, AmpInputVoltage.CSV, AmpOutputCurrent.CSV, AmpOutputVoltage.CSV, Motor Ra (New tests).xlsb.xlsx]
2017-04-10 Added label, and sensor things.
2017-04-10 Tests remastered
    [Motor Ra (New tests).xlsb.xlsx]
2017-04-10 Diagram for the internal resistance and inductance of the motor
2017-04-11 Fix a wrong equation in torque load for the Dc motor modelling
2017-04-19 Edit some of the mistakes done in the torque load of the dc motor modelling
2017-04-20 New Subsection for Complete Motor+Gears TF
2017-04-24 Minor correction in modelling of the DC motor
2017-04-24 New GearSystemDiagram, and Mathias' comments fixed.
2017-04-24 Fixed GearSystemDiagram and added description
2017-04-24 Pretty much done with text and sample code for potentiometer angle.
2017-04-26 Added the last part of sensor implementation
2017-05-02 Tired of typing in shitty stuff...
2017-05-03 Tired of typing in shitty stuff... (reverted from commit 34e3d9331727fffaec8d0c9388535aa51318eb97)
    [PIDControllerTest.ino]
2017-05-03 Romain shit fail, within section modeling of the horizontal position. Fix your fucking latex code asshole ;-)
    [PControllerTest.ino]
2017-05-04 The failure of the maxime company :-(
    [PIDControllerTestByMaximeCompany.ino]
2017-05-05 Some tries for PID stuff
2017-05-05 Fix in Tau_s approximation
    [PIDGeofftroller.ino, PIDTEST.ino]
2017-05-05 Code From friday afternoon, 05-05-2017 is the correct one
    [05-05-2017.ino, TestOfPID.ino]
2017-05-10 Added thrust experiment report and attached files
2017-05-16 addition of design + servo + final test
2017-05-20 Correction for scripts and add the arm loop design in the report
    [ProperCodeWithVelocityLoop.ino]
2017-05-20 CDs from old reports
    [MaalingPindogArm.xlsx]
2017-05-22 Motor Controller Design
2017-05-22 Arm loop done may correct some mnor detail later though
2017-05-22 Updated the root locus of the intro and add the transfer functions for the loops (not the motor loop)
2017-05-23 minor correction in the design of the onverted pendulum and the code for the working inverted pendulum orl
    [ProperCodeWithVelocityLoop.ino]
2017-05-25 Added PWM stuff and corrected stuff
2017-05-25 flowchart 1rst version
2017-05-26 Edited the flow chart and the intro
2017-05-26 This should be the last flow chart, hopefully...
2017-05-26 Added rocket controller and srb_test data
    [CONFIG.TXT]
2017-05-28 Finished implementation, put rocket stuff in rocket folder
    [CONFIG.TXT]
2017-05-29 servomotor conclusion change
2017-05-29 Cropped Flowchart
2017-05-29 Gear Train stuff fixed
